EvanTrenchant/ProjetGES7/Rapport/RESTRUCTURATION_RAPPORT.md

# Restructuration du rapport - APPLIQUÉE ✅

## Structure FINALE appliquée

### CHAPITRE: Étude de l'asservissement de la MCC

#### ✅ Structure APPLIQUÉE

```
Chapitre: Étude de l'asservissement de la MCC

├── Section 1: Asservissement en courant
│   ├── Modélisation sur Simulink
│   ├── Modélisation sur PSIM
│   └── Comparaison des résultats

├── Section 2: Asservissement en vitesse avec dynamo tachymétrique ✅ MODIFIÉ
│   ├── Principe de fonctionnement de la dynamo tachymétrique ✅ NOUVEAU
│   ├── Caractérisation en boucle ouverte
│   ├── Conception du correcteur PI
│   ├── Validation sur PSIM
│   └── Comparaison et validation des performances

└── Section 3: Asservissement en vitesse avec codeur incrémental ✅ NOUVEAU
    ├── Principe de fonctionnement du codeur incrémental
    ├── Calcul de la vitesse et du sens de rotation
    ├── Simulation avec correcteurs PI idéaux sur Simulink [ESPACE RÉSERVÉ]
    ├── Simulation avec correcteurs PI idéaux sur PSIM [ESPACE RÉSERVÉ]
    └── Comparaison des résultats avec codeur incrémental [ESPACE RÉSERVÉ]
```

**Modifications appliquées** :
- ✅ Section 2 renommée pour spécifier "avec dynamo tachymétrique"
- ✅ Ajout d'une sous-section expliquant le principe de la dynamo tachy dans la Section 2
- ✅ Création d'une Section 3 complète pour le codeur incrémental
- ✅ Les sous-sections du codeur sont maintenant au bon niveau (subsection au lieu de subsubsection)
- ✅ Espaces réservés clairement marqués pour le contenu futur

---

### CHAPITRE: Dimensionnement des asservissements

#### ✅ Structure APPLIQUÉE

```
Chapitre: Dimensionnement des asservissements

├── Section 1: Réalisation des soustracteurs
│   └── (Contenu existant avec minipage texte/image)

├── Section 2: Dimensionnement des correcteurs réels (PI)
│   ├── Structure du correcteur PI
│   ├── Calcul de la fonction de transfert globale
│   ├── Dimensionnement du correcteur H1(s)
│   ├── Dimensionnement du correcteur H2(s)
│   ├── Fonction de transfert globale et identification
│   ├── Identification des paramètres
│   └── Choix des composants
│       ├── PI Courant (R=3.3kΩ, C=3.9µF, R1=1kΩ, R2=6.8kΩ)
│       └── PI Vitesse (R=10Ω, C=10µF, R1=1.5kΩ, R2=8.2kΩ)

└── Section 3: Dimensionnement des autres composants de la chaîne d'asservissement ✅ MODIFIÉ
    ├── Subsection 3.1: Limiteur de tension (écrêteur) ✅
    │   ├── Principe de fonctionnement ✅
    │   │   ├── Limite supérieure: V_s+ = 14,8V
    │   │   ├── Limite inférieure: V_s- = 0,18V  
    │   │   └── Suiveur adaptateur d'impédance
    │   └── [Dimensionnement] (contenu conservé)
    │
    ├── Subsection 3.2: Capteur dynamo tachymétrique ✅
    │   ├── Caractéristiques du capteur ✅
    │   │   └── K_tachy = 6×10⁻³ V/(rad/s)
    │   └── Conditionnement du signal ✅
    │       ├── Facteur 6/1000 sur PSIM
    │       └── Pont diviseur (÷2) [ESPACE RÉSERVÉ pour schéma]
    │
    └── Subsection 3.3: Codeur incrémental ✅
        ├── Caractéristiques du codeur [ESPACE RÉSERVÉ]
        └── Circuit de conversion impulsions/tension [ESPACE RÉSERVÉ]
            └── Convertisseur F/V
```

**Modifications appliquées** :
- ✅ Section "Limiteur de tension" renommée en "Dimensionnement des autres composants"
- ✅ "Limiteur de tension" transformé en subsection "Limiteur de tension (écrêteur)"
- ✅ Contenu explicatif des commentaires décommenté et formaté en LaTeX
- ✅ Ajout de sous-sous-sections "Principe de fonctionnement"
- ✅ Ajout de contenu détaillé pour la dynamo tachymétrique
- ✅ Ajout de sous-sous-sections pour le codeur incrémental
- ✅ Espaces réservés clairement marqués pour le contenu futur

---

## Modifications à apporter manuellement

### Dans `asservissement_moteur.tex`:

Les modifications ont déjà été appliquées. La section "Asservissement en vitesse avec le codeur incrémental" a été transformée en Section 3 avec des sous-sections pour:
- Dynamo tachymétrique
- Codeur incrémental (avec espaces réservés pour vos simulations)

### Dans `dimensionnement_composants.tex`:

**À MODIFIER** (lignes ~233-253):

Remplacer:
```latex
\section{Limiteur de tension}
...
\subsection{Capteur dynamo tachymétrique}
\subsection{Codeur incrémental}
```

Par:
```latex
\section{Dimensionnement des autres composants de la chaîne d'asservissement}

Après avoir dimensionné les correcteurs PI et les soustracteurs, il est nécessaire de compléter...

\subsection{Limiteur de tension (écrêteur)}
...
    \subsubsection{Principe de fonctionnement}
    \subsubsection{Dimensionnement}

\subsection{Capteur dynamo tachymétrique}
...
    \subsubsection{Caractéristiques du capteur}
    \subsubsection{Conditionnement du signal}

\subsection{Codeur incrémental}
...
    \subsubsection{Caractéristiques du codeur}
    \subsubsection{Circuit de conversion impulsions/tension}
```

---

## Résumé des changements

### ✅ Déjà fait:
1. **asservissement_moteur.tex**: Section 3 créée avec structure pour dynamo tachy + codeur incrémental
2. Espaces réservés pour simulations Simulink/PSIM avec codeur + PI idéaux

### ⚠️ À faire:
1. **dimensionnement_composants.tex**: Restructurer la section "Limiteur de tension" en section principale avec sous-sections
2. Décommenter et formater le contenu des commentaires sur le limiteur
3. Ajouter le contenu sur la dynamo tachy et le codeur incrémental

### 📝 Contenu à ajouter:
1. Simulations avec codeur incrémental (Simulink + PSIM)
2. Graphiques de comparaison
3. Schémas des circuits de conditionnement
4. Circuit de conversion fréquence-tension pour le codeur

---

## Ordre de la table des matières finale

1. Introduction
2. Cahier des charges
3. Planification
4. Modélisation et simulation du moteur et du hacheur
5. Diagrammes (schémas-blocs)
6. **Étude de l'asservissement de la MCC** (avec 3 sections)
7. **Dimensionnement des asservissements** (avec 3 sections)
8. Liste des figures et chemins d'accès
9. Conclusion
