EvanTrenchant/ProjetGES7/Rapport/contenu/diagrammes.tex

\section{Simplification du schéma bloc}

\noindent
\begin{minipage}[t]{0.48\textwidth}
\vspace{0pt}
A ce stade de l'analyse, nous disposons du schéma bloc complet de notre système, avant asservissement en vitesse. Comme illustré dans la Figure \ref{fig:schema_bloc_asservissement}, ce schéma est assez complexe en raison de la présence de plusieurs boucles de rétroaction imbriquées. Pour faciliter l'analyse et la conception des contrôleurs, il est nécessaire de simplifier ce schéma bloc en combinant les différents éléments.
\end{minipage}
\hfill
\begin{minipage}[t]{0.48\textwidth}
\vspace{0pt}
Cette simplification permet d'obtenir une représentation plus concise du système, facilitant ainsi l'analyse et la conception des contrôleurs.
\[
\begin{aligned}
\left\{
\begin{array}{l}
\varepsilon = e - \textcolor{blue}{B} \cdot \Omega - \textcolor{green!60!black}{C} \cdot \Omega \\
s = \textcolor{red}{A} \cdot \varepsilon = \textcolor{red}{A} \cdot \left( e - (\textcolor{blue}{B} + \textcolor{green!60!black}{C}) \cdot s \right)
\end{array}
\right.
\\[0.5em]
\Longrightarrow \quad
s = \frac{\textcolor{red}{A}\cdot e}{1+\textcolor{red}{A} \cdot \left( \textcolor{blue}{B} + \textcolor{green!60!black}{C}\right)} = H \cdot e
\end{aligned}
\]
\end{minipage}

\begin{figure}[H]
    \centering
    \begin{tikzpicture}[auto, node distance=2cm,>=latex', scale=0.65, transform shape]
        % Définition des styles
        \tikzstyle{block} = [draw, rectangle, minimum height=3em, minimum width=3em]
        \tikzstyle{sum} = [draw, circle, minimum size=6mm, node distance=1.5cm]
        \tikzstyle{input} = [coordinate]
        \tikzstyle{output} = [coordinate]
        \tikzstyle{gain} = [draw, regular polygon, regular polygon sides=3, shape border rotate=-90, minimum size=0.5em, inner sep=1pt]
        
        % Nœuds - Entrée et premier sommateur
        \node [input, name=input] (input) {};
        \node [gain, right of=input, node distance=1.5cm] (commande) {$6.4$};
        \node [sum, right of=commande, node distance=1.5cm] (sum2) {};
        
        \draw (sum2.north east) -- (sum2.south west);
        \draw (sum2.south east) -- (sum2.north west);
        \node [above left, inner sep=6pt] at (sum2.center) {\tiny $+$};
        \node [below right, inner sep=6pt] at (sum2.center) {\tiny $-$};
        
        % Bloc correcteur de vitesse
        \node [block, right of=sum2, node distance=2cm] (corrV) {$\dfrac{1}{R+L\cdot s}$};
        
        % Point intermédiaire entre corrV et kphi (nœud noir)
        \node [circle, fill=black, inner sep=2pt, right of=corrV, node distance=1.4cm] (point_iM) {};
        
        % Gain Kphi
        \node [gain, right of=corrV, node distance=2.4cm] (kphi) {$K_\phi$};

        % Sortie delta i_M au-dessus de corrV
        \node [output, above of=kphi, node distance=1.5cm] (delta_iM) {};
        \node [above] at (delta_iM) {$\delta i_M$};
        
        % Troisième sommateur
        \node [sum, right of=kphi, node distance=1.8cm] (sum3) {};
        
        % Ajout des signes + et - dans le troisième sommateur
        \draw (sum3.north east) -- (sum3.south west);
        \draw (sum3.south east) -- (sum3.north west);
        \node [above left, inner sep=6pt] at (sum3.center) {\tiny $+$};
        \node [below right, inner sep=6pt] at (sum3.center) {\tiny $-$};
        
        % Bloc intégrateur
        \node [block, right of=sum3, node distance=2.5cm] (integ) {$\dfrac{1}{J\cdot s}$};
        
        % Point Omega pour dérivation
        \node [coordinate, right of=integ, node distance=2.5cm] (omega) {};
        % Point s (nœud noir) après l'intégrateur
        \node [circle, fill=black, inner sep=2pt, right of=omega, node distance=0cm] (s_point) {};
        % Label s en bas à droite du point noir
        \node [below right, inner sep=3pt] at (s_point) {\small $s$};
        % Sortie
        \node [output, right of=omega, node distance=0.5cm] (output) {};
        
        % Boucle de retour 1 : Bloc retour 2f - positionné sous sum3
        \node [gain, shape border rotate=90, below of=integ, node distance=2cm] (gain2f) {$2f$};
        
        % Boucle de retour 2 : Bloc retour complexe Kphi² - positionné sous integ
        \node [block, below of=gain2f, node distance=2cm, minimum width=6em] (retourA) {$\dfrac{K_\phi^2}{L\cdot s+(R+R_{ch})}$};
        
        % Sommateur 4 : entre les retours 2f et Kphi² avant sum3
        \node [sum, below of=sum3, node distance=2cm] (sum4) {};
        
        % Ajout des signes + dans le sommateur 4
        \draw (sum4.north east) -- (sum4.south west);
        \draw (sum4.south east) -- (sum4.north west);
        \node [above right, inner sep=6pt] at (sum4.center) {\tiny $+$};
        \node [below right, inner sep=6pt] at (sum4.center) {\tiny $+$};
        
        % Boucle de retour 3 : Gain Kphi - positionné pour aller vers sum2
        \node [gain, shape border rotate=90, below of=sum3, node distance=5.5cm] (kphiret) {$K_\phi$};
        
        % Connexions principales
        \draw [->] (input) -- node[above, pos=- 0.2] {$\delta u_{commande}$} (commande);
        \draw [->] (commande) -- (sum2);
        \draw [->] (sum2) -- (corrV);
        \draw [-] (corrV) -- (point_iM);
        \draw [->] (point_iM) -- (kphi);
        
        % Sortie delta i_M depuis le point intermédiaire
        \draw [->] (point_iM) |- (delta_iM);
        
        \draw [->] (kphi) -- node[above] {$e$} (sum3);
        \draw [->] (sum3) -- node[above] {$\varepsilon$} (integ);
        \draw [-] (integ) -- (omega);
        \draw [->] (omega) -- node[above] {$\delta \Omega$} (output);
        
        % Boucle de retour 1 : 2f part de Omega et va dans sum4
        \draw [->] (omega) |- (gain2f);
        \draw [->] (gain2f) -- (sum4);
        
        % Boucle de retour 2 : Kphi² part de Omega et va dans sum4
        \draw [->] (omega) |- (retourA);
        \draw [->] (retourA) -| (sum4);
        
        % Sortie de sum4 vers sum3
        \draw [->] (sum4) -- (sum3);
        
        % Boucle de retour 3 : Kphi part de Omega et revient à sum2
        \draw [->] (omega) |- (kphiret);
        \draw [->] (kphiret) -| (sum2);
        
        % Rectangle coloré autour du bloc intégrateur
        \draw [red, thick, rounded corners] ([xshift=-0.2cm, yshift=0.2cm]integ.north west) rectangle ([xshift=0.2cm, yshift=-0.2cm]integ.south east);
        \node [red, font=\Large\bfseries, right of=integ, node distance=1.2cm, yshift=0.6cm] {A};
        
        % Rectangle coloré autour du bloc 2f
        \draw [blue, thick, rounded corners] ([xshift=-0.6cm, yshift=0.5cm]gain2f.north west) rectangle ([xshift=0.2cm, yshift=-0.4cm]gain2f.south east);
        \node [blue, font=\Large\bfseries, right of=gain2f, node distance=0.9cm, yshift=-0.5cm] {B};
        
        % Rectangle coloré autour du bloc Kphi²
        \draw [green!60!black, thick, rounded corners] ([xshift=-0.2cm, yshift=0.2cm]retourA.north west) rectangle ([xshift=0.2cm, yshift=-0.2cm]retourA.south east);
        \node [green!60!black, font=\Large\bfseries, left of=retourA, node distance=2.2cm, xshift=-0.05cm, yshift=0.5cm] {C};
        
    \end{tikzpicture}
    \caption{Schéma bloc de l'asservissement en courant avec boucle de courant imbriquée}
    \label{fig:schema_bloc_asservissement}
\end{figure}

Le diagramme bloc simplifié de l'asservissement en vitesse est présenté dans la Figure \ref{fig:schema_bloc_simplifie}.

\begin{figure}[H]
    \centering
    \begin{tikzpicture}[auto, node distance=2cm,>=latex', scale=0.65, transform shape]
        % Définition des styles
        \tikzstyle{block} = [draw, rectangle, minimum height=3em, minimum width=3em]
        \tikzstyle{sum} = [draw, circle, minimum size=6mm, node distance=1.5cm]
        \tikzstyle{input} = [coordinate]
        \tikzstyle{output} = [coordinate]
        \tikzstyle{gain} = [draw, regular polygon, regular polygon sides=3, shape border rotate=-90, minimum size=0.5em, inner sep=1pt]
        
        % Nœuds - Entrée et premier sommateur
        \node [input, name=input] (input) {};
        \node [gain, right of=input, node distance=1.5cm] (commande) {$6.4$};
        \node [sum, right of=commande, node distance=1.5cm] (sum2) {};

        \draw (sum2.north east) -- (sum2.south west);
        \draw (sum2.south east) -- (sum2.north west);
        \node [above left, inner sep=6pt] at (sum2.center) {\tiny $+$};
        \node [below right, inner sep=6pt] at (sum2.center) {\tiny $-$};

        % Bloc correcteur de vitesse
        \node [block, right of=sum2, node distance=2cm] (corrV) {$\dfrac{1}{R+L\cdot s}$};
        
        % Point intermédiaire entre corrV et kphi (nœud noir)
        \node [circle, fill=black, inner sep=2pt, right of=corrV, node distance=1.6cm] (point_iM) {};
        
        % Bloc Kphi * H
        \node [block, right of=point_iM, node distance=1.5cm] (kphih) {$K_\phi\cdot H$};

        % Sortie delta i_M au-dessus de corrV
        \node [output, above of=kphih, node distance=1.5cm] (delta_iM) {};
        \node [above] at (delta_iM) {$\delta i_M$};
        
        % Point Omega pour dérivation
        \node [coordinate, right of=kphih, node distance=1.5cm] (omega) {};
        % Point s (nœud noir) après l'intégrateur
        \node [circle, fill=black, inner sep=2pt, right of=omega, node distance=0cm] (s_point) {};
        % Label s en bas à droite du point noir
        \node [below right, inner sep=3pt] at (s_point) {\small $s$};
        % Sortie
        \node [output, right of=omega, node distance=0.5cm] (output) {};
        
        % Boucle de retour 3 : Gain Kphi - positionné pour aller vers sum2
        \node [gain, shape border rotate=90, below of=point_iM, node distance=1.5cm] (kphiret) {$K_\phi$};
        
        % Connexions principales
        \draw [->] (input) -- node[above, pos=- 0.2] {$\delta u_{commande}$} (commande);
        \draw [->] (commande) -- (sum2);
        \draw [->] (sum2) -- (corrV);
        \draw [-] (corrV) -- (point_iM);
        \draw [->] (point_iM) -- (kphih);

        % Sortie delta i_M depuis le point intermédiaire
        \draw [->] (point_iM) |- (delta_iM);

        \draw [-] (kphih) -- (omega);
        \draw [->] (omega) -- node[above] {$\delta \Omega$} (output);
        
        % Boucle de retour 3 : Kphi part de Omega et revient à sum2
        \draw [->] (omega) |- (kphiret);
        \draw [->] (kphiret) -| (sum2);
    \end{tikzpicture}
    \caption{Schéma bloc de l'asservissement en courant simplifié}
    \label{fig:schema_bloc_simplifie}
\end{figure}

On peut alors écrire la fonction de transfert en boucle ouverte du système simplifié :
\[
\delta_{i_{M}} (s) = \dfrac{\dfrac{1}{R+L\cdot s}}{1+\dfrac{\left(K_\phi\right)^2\cdot H}{R+L\cdot s}} \cdot 6{,}4 \cdot \delta u_{commande} (s) = FTBO (s) \cdot 6{,}4 \cdot \delta u_{commande} (s)
\]

Pour s'assurer que notre fonction de transfert est correcte, il faudrait la valider par des simulations numériques en comparant les résultats obtenus. Il serait alors possible de poursuivre l'analyse en utilisant cette fonction de transfert simplifiée pour concevoir et optimiser le contrôleur de l'asservissement en vitesse du moteur.
