EvanTrenchant/ProjetGES7/Rapport/contenu/liste_figures_chemins.tex

\chapter*{Liste des figures et chemins d'accès}
\addcontentsline{toc}{chapter}{Liste des figures et chemins d'accès}

Cette section recense l'ensemble des figures présentes dans ce rapport ainsi que le chemin d'accès aux fichiers de simulation correspondants.

\vspace{0.5cm}

% Cette liste se génère automatiquement à partir des figures ayant un chemin d'accès défini
% via la commande \figpath{label}{chemin} dans le préambule ou les chapitres
{\tiny
\begin{itemize}[leftmargin=0pt, labelwidth=0pt, labelsep=0pt, itemindent=0pt, itemsep=0.3cm]
    \printfigurelist
\end{itemize}
}
