EvanTrenchant/ProjetGES7/Partie Essais et Rectifications.docx

# Essais et Rectifications

Une fois que notre PCB est assemblé et que les connections avec les connectiques sont réalisées, nous pouvons passer au test du projet. Ce qui nous permettra également de résoudre les problèmes de conceptions si nous en rencontrons. Les tests se sont déroulés en deux parties principales qui sont l’asservissement à l’aide de la dynamo tachymétrique puis l’asservissement à l’aide du codeur incrémental.

## 1- Protocole d’essais

Pour réaliser ces tests, nous avons respecté le même protocole pour les deux parties.

Premièrement nous avons uniquement testé le PCB sur plaquette. Cela consiste à injecter des signaux continus aux différentes entrée de la chaine d’asservissement ou de traitement du signal codeur incrémental et d’observer les sorties de chaque étage. Une fois ces sorties mesurées, nous pouvons les comparer aux valeurs trouvées en simulation pour les mêmes tests et valider ou non le fonctionnement de notre carte. Pour ces tests avons veillé à court-circuiter les capacités de correcteur proportionnel intégrale pour qu’elle ne gêne pas les tests réalisés avec des signaux continus.

Une fois la validation du fonctionnement du PCB effectuée, nous pouvons passer aux tests sur la maquette réelle. Pour ce faire nous alimentons notre boitier en -15V/+15V et le hacheur qui alimentera la machine à courant continue en 48V. Nous utilisons un GBF pour appliquer une consigne, et avons choisis un signal carrée variant entre -2V et +2V de fréquence 400mHz pour observer un changement de sens de rotation de l’axe de la MCC. En parallèle nous utilisons un oscilloscope pour observer toutes les mesures qui nous intéresse donc la consigne envoyée à la carte, la vitesse de rotation du moteur donnée par la dynamo tachymétrique ou le codeur incrémental ainsi que le courant dans le moteur. Ces tests sur la maquette seront validés si la réponse de notre système est stable et si le courant dans le moteur est bien écrêté à une valeur maximale de 5A pour protéger la machine. Si ces critères sont remplis, nous pouvons faire les mesures de l’évolution dans le temps de la vitesse de rotation du moteur ainsi que le courant absorbé par celui-ci.

Finalement, la dernière partie des tests consistera à comparer les valeurs mesurées sur la maquette réelle aux valeur trouvées en simulations. Cela permettra de comparer les performances voulues en simulation aux performances que nous avons atteint en réalité. Nous portons une attention particulière au dépassement et au temps de réponse du système. Nous ferons une comparaison entre les valeurs réelles, les valeurs de simulation de Matlab ainsi qu’avec les valeurs données par PSIM.

## 2- Essais avec la dynamo tachymétrique

Pour ces premiers tests nous réalisons uniquement les tests pour asservir la machine à courant continue à l’aide du retour de vitesse fourni par la dynamo tachymétrique de la maquette.

### Problèmes rencontrés

Nous avons commencé par les tests sur plaquette de la carte et nous n’avons pas rencontrés de problèmes majeurs ce qui nous a permit de passer à la deuxième étape de test qui est tester notre carte sur la maquette. Nous avons donc réalisé ces tests sur maquette qui nous ont montré que notre système d’asservissement est fonctionnel car il répond de manière stable. En revanche nous avons observé deux problèmes qui sont :

- Le limiteur de courant était inefficace
- Le signal de courant n’était pas stable

Après avoir analyser notre montage et avoir refait des simulations nous nous somme rendu compte que pour le premier problème nous avions placer l’étage limiteur de courant au mauvais endroit dans la chaine d’asservissement. Ce limiteur avait été placé après l’étage qui compare la consigne de courant au retour de courant venant de la maquette alors que ce limiteur aurait dû être avant ce comparateur. Nous avons alors modifié notre PCB pour faire en sorte de replacer ce limiteur au bon endroit, comme montré sur la figure ci-dessous, et cela a fonctionné, nous avions bien un courant écrêté à 5A comme demandé pour protéger la machine.

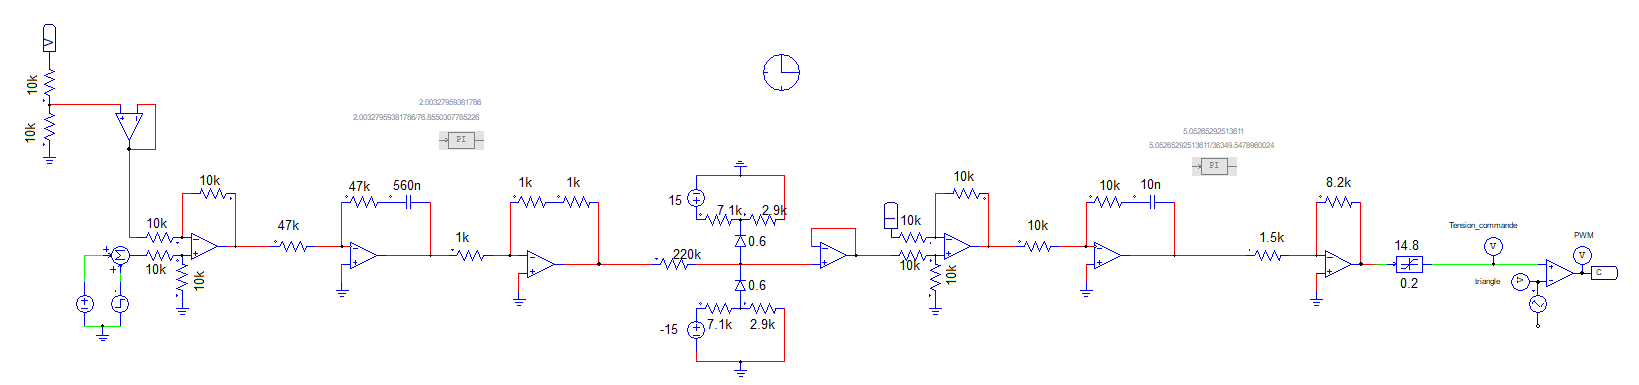
[picture p25: figure]

Figure 1 : Modification placement étage limiteur de courant

Pour ce qui est de la stabilité du signal de courant nous avons remarqué que nous avions soudé la mauvaise valeur de capacité dans l’étage du correcteur intégral de la boucle de courant. Nous avons donc remplacé cette capacité par la valeur prévue en lors du dimensionnement des composants et cela régler ce souci de stabilité.

### Performances obtenues

Une fois ces problèmes régler nous avons pu réaliser des tests complets sur la maquette. Grâce à l’oscilloscope nous avons relevé les courbes de vitesse et de courant réelles afin de pourvoir les comparer aux simulations. Nous avons réalisé les comparaisons en utilisant Matlab pour superposer les courbes données par Simulink, les valeurs renvoyées par PSIM et les valeurs réelles mesurées. Cela nous donne la comparaison suivant pour le courant :

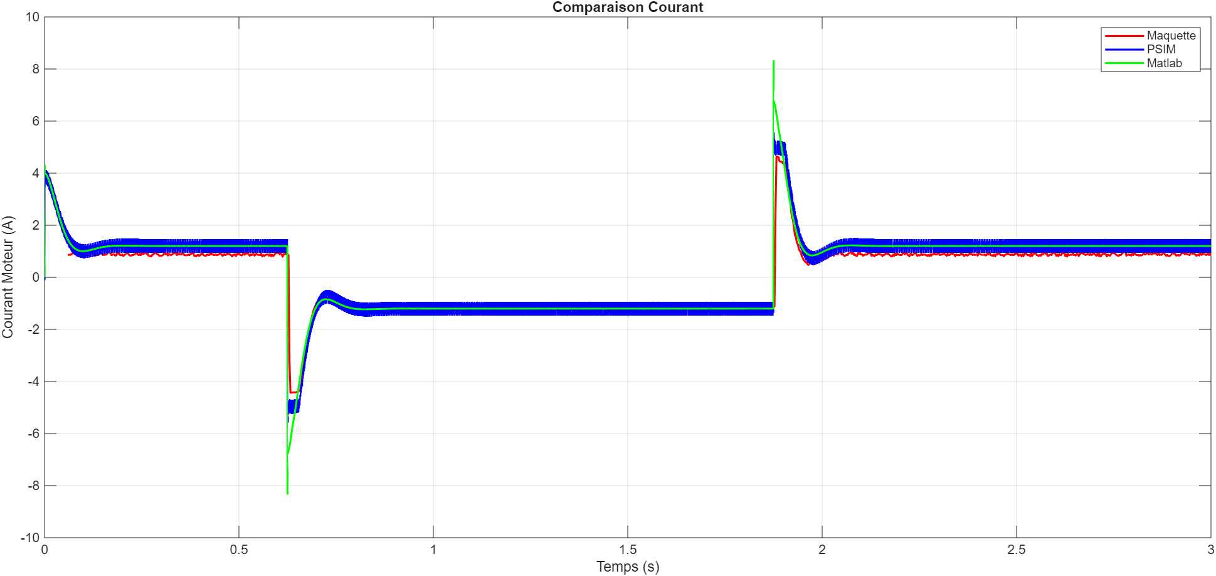
[picture p26: figure]

Pour la simulation faite avec Matlab nous avons volontairement laissé le pic de courant pour pouvoir observer facilement que notre projet écrête bien le courant à 5A, ce qui est également le cas pour la simulation PSIM avec laquelle nous avons dimensionné les composants. On observe que la courbe réelle du courant est très proche des courbes trouvées en simulation, ce qui permet de valider le fonctionnement de notre projet sur l’asservissement en courant. A noté que l’on peut observer une légère différence de valeur de courant en régime permanent entre les valeurs réelles et les valeurs simulées. Cela est dû au réglage de la charge que nous avons mis sur la maquette qui ne devait pas être exactement à une valeur de 10Ω alors que les simulations ont été réalisées pour une valeur exacte de 10Ω.

Figure 2 : Comparaison Courant Maquette Simu

Pour ce qui est de l’asservissement en vitesse nous obtenons cette comparaison :

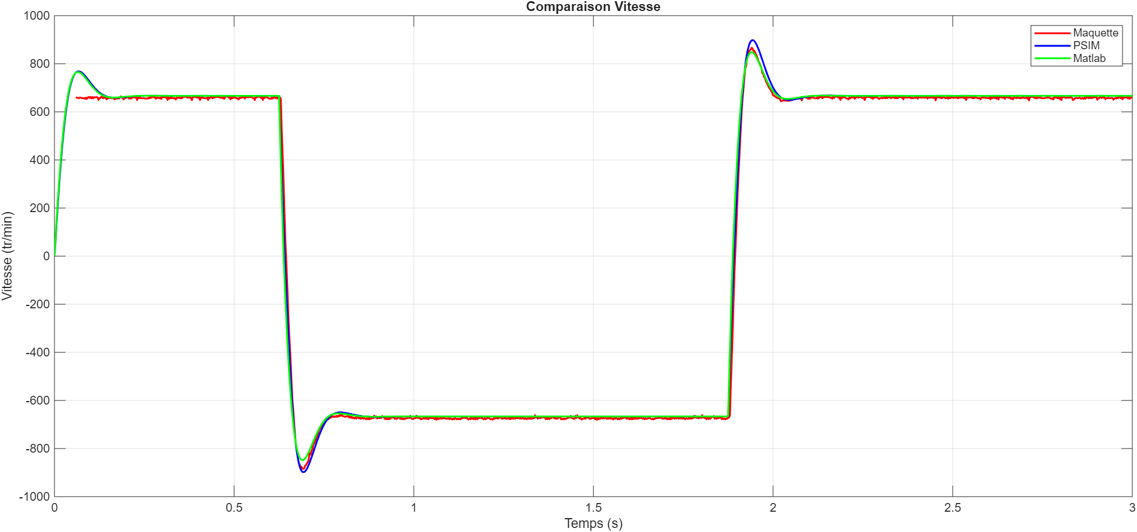
[picture p27: figure]

On remarque encore que les trois courbes ont très proches les unes des autres ce qui confirme que notre dimensionnement répond bien aux exigences que nous voulions. Nous avons également réalisé les mesures du temps de réponse et de dépassement à l’oscilloscope pour récupérer les performances de notre carte :

Figure 3 : Comparaison Vitesse Maquette Vitesse

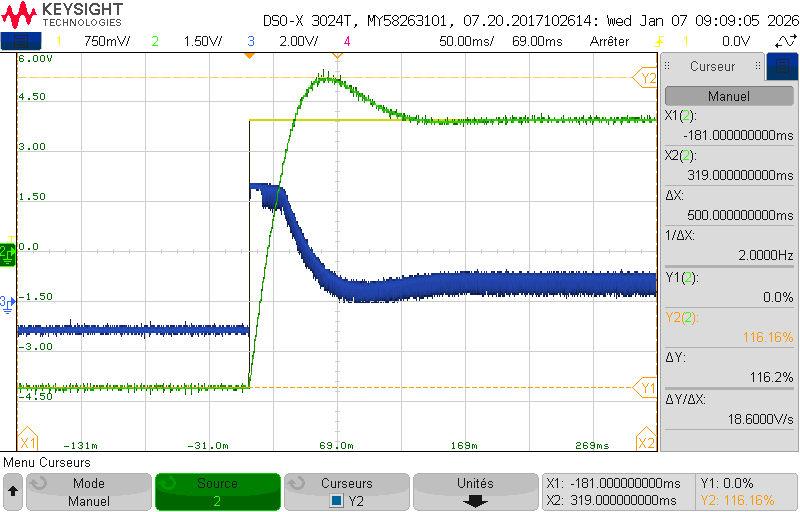
[picture p28: figure]
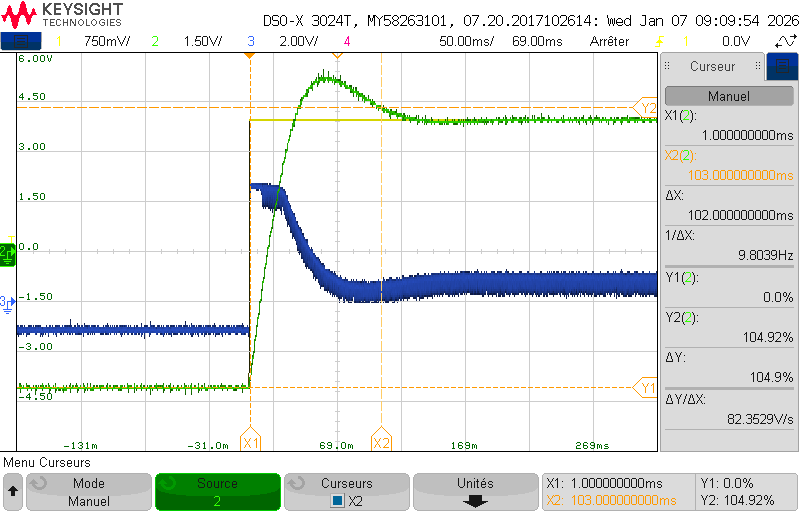
[picture p29: figure]

Figure 5 : Mesure Dépassement

Figure 5 : Mesure Temps de Réponse

Nous avons obtenu les performances suivantes :

- Dépassement : 16,2%
- Temps de réponse : 102 ms
- Limitation du courant : 4,97 A

Ces performances remplissent le cahier des charges que nous avions.

## 3- Essais avec le codeur incrémental

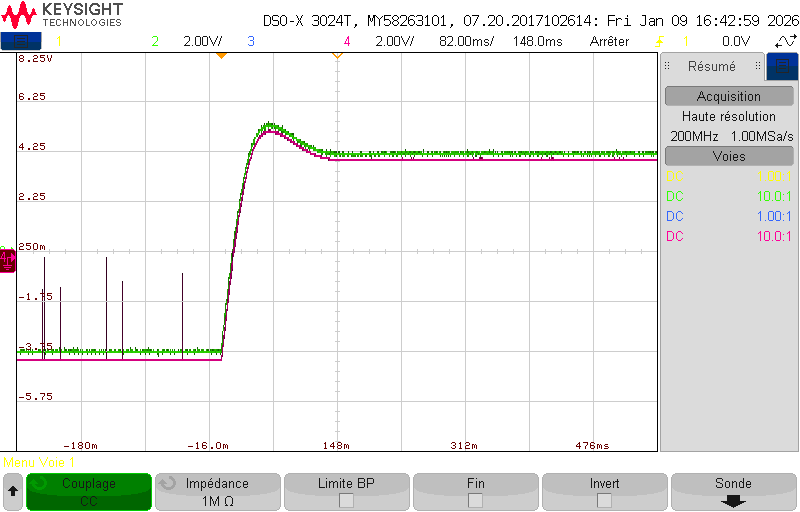
[picture p30: figure]

Pour cette partie des tests nous réalisons uniquement les tests pour asservir la machine à courant continue à l’aide du retour de vitesse fourni par le codeur incrémental de la maquette. Pour vérifier le bon fonctionnement de notre chaine de traitement du signal venant du codeur incrémental nous avons fait attention à vérifier sur le signal en sortie de cette chaine de traitement renvoie la même valeur de vitesse que la dynamo tachymétrique. Pour ce faire nous avons mis en place l’asservissement avec la dynamo tachymétrique et avons branché le codeur incrémental à notre chaine de traitement puis nous avons observé les retours de vitesses venant des deux capteurs. Cela nous a permis de régler le gain de la chaine de traitement du codeur incrémental pour obtenir le même retour de vitesse. Ce test est représenté ci-dessous :

Figure 6 : Test retour de vitesse Codeur Incrémental

### Problèmes rencontrés

Aucun problème n’a été rencontré lors des tests de la chaine de traitement du codeur incrémental sur plaquette ni sur la maquette.

### Performances obtenues

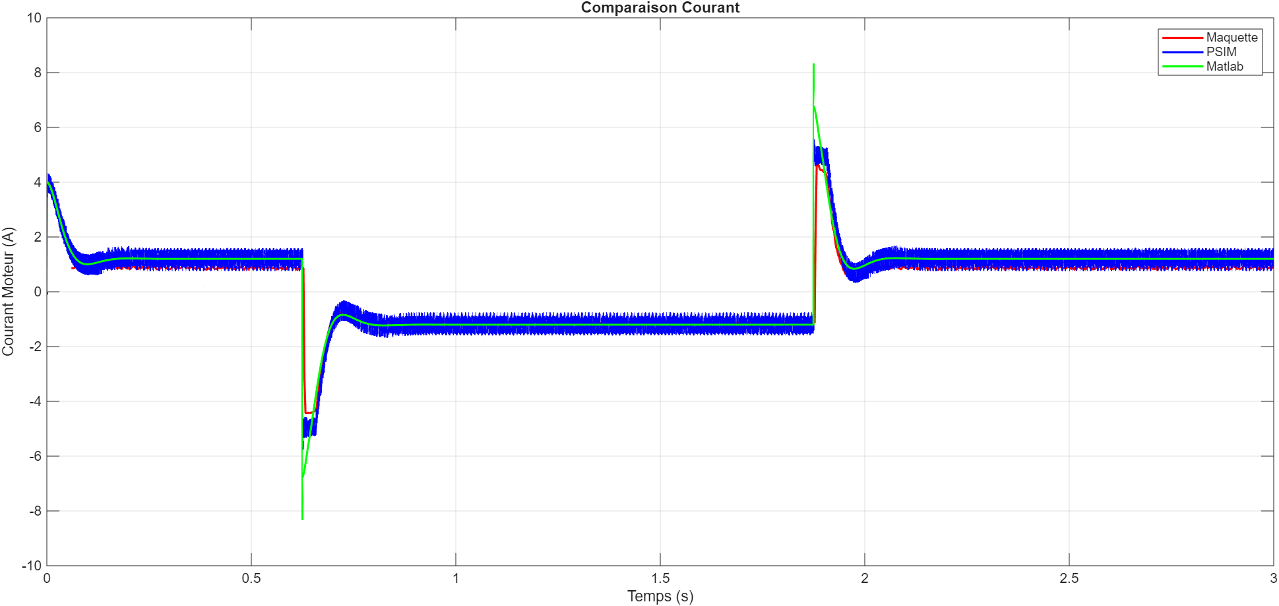
[picture p31: figure]

N’ayant pas rencontré de problème lors des tests nous avons pu réaliser les mesures de performance rapidement. Ces mesures nous donnent les comparaisons suivantes pour les courbes de vitesse et de courant. Nous obtenons à nouveau des courbes très similaires ce qui nous a permis de valider le fonctionnement de chaine d’asservissement en utilisant le codeur incrémental.

Figure 7 : Comparaison Courant Maquette Simu

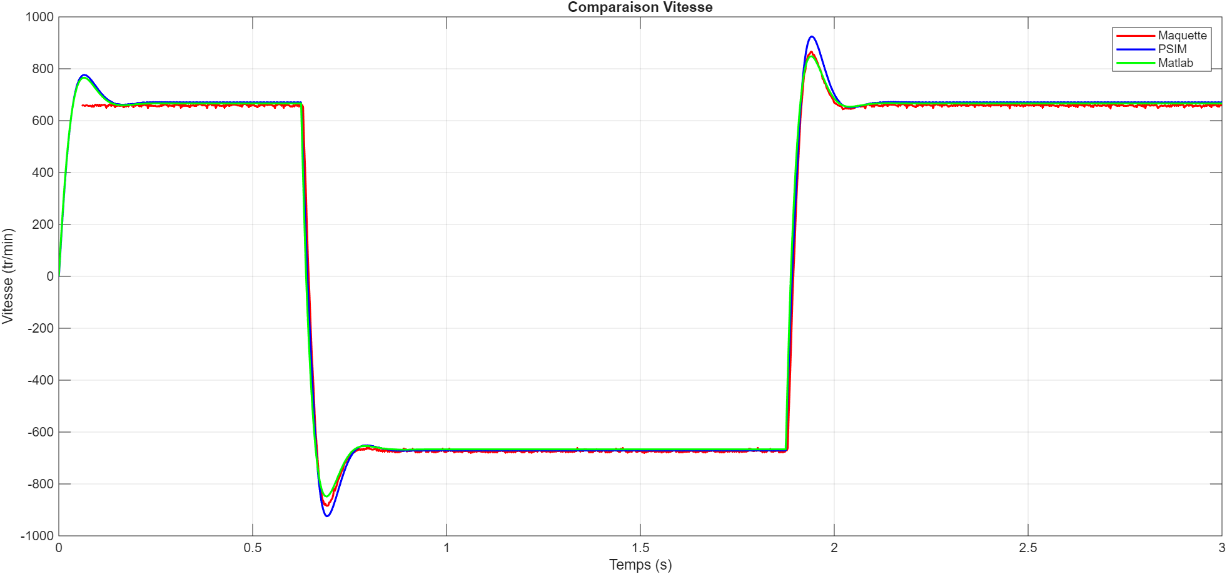
[picture p32: figure]

Figure 8 : Comparaison Vitesse Maquette Simu

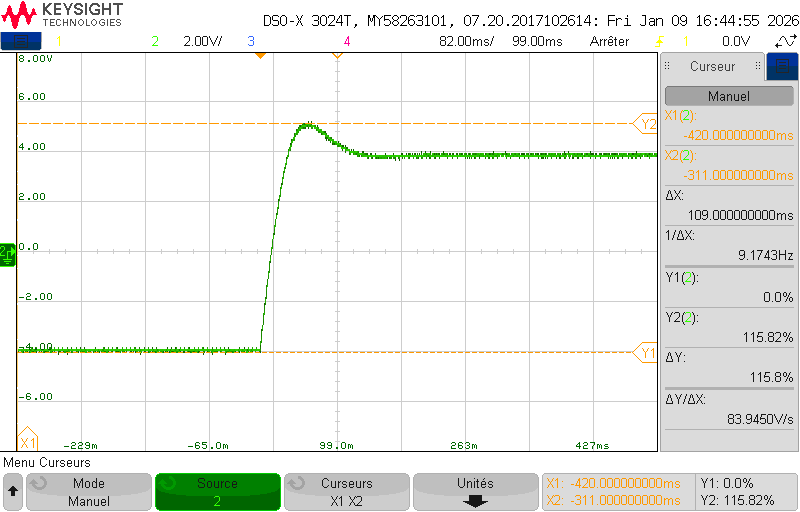
[picture p33: figure]
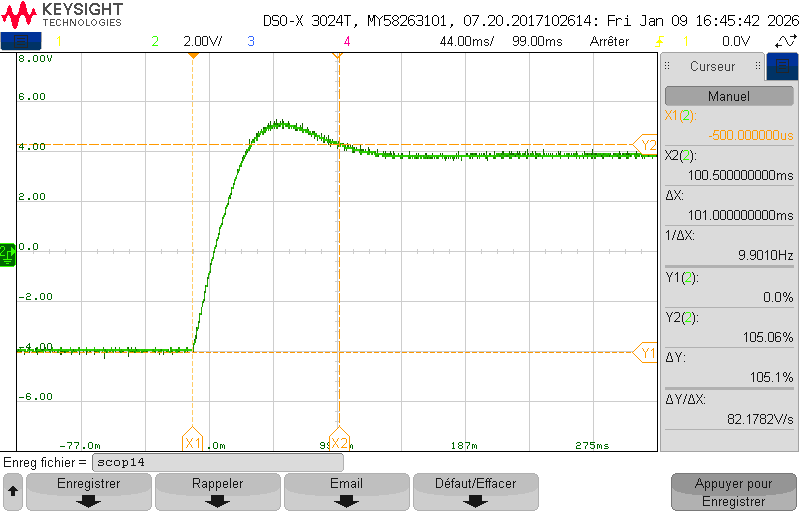
[picture p34: figure]

Nous avons également réalisé les mesures du temps de réponse et de dépassement à l’oscilloscope pour récupérer les performances de notre carte :

Figure 9 : Mesure Dépassement

Figure 10 : Mesure Temps de Réponse

Nous avons obtenu les performances suivantes :

- Dépassement : 15,8%
- Temps de réponse : 101 ms
- Limitation du courant : 4,97 A

Ces performances remplissent le cahier des charges que nous avions.
