EvanTrenchant/ProjetGES7/Projet_GES7_Rapport_Intermediaire_GE4_G2_TROULLIER_TRENCHANT_VIRQUIN_2025.pdf

# Projet GE S7

## Asservissement d’une machine à courant continu

## TRENCHANT Evan TROULLIER Laël VIRQUIN Rudy GE4, groupe 2

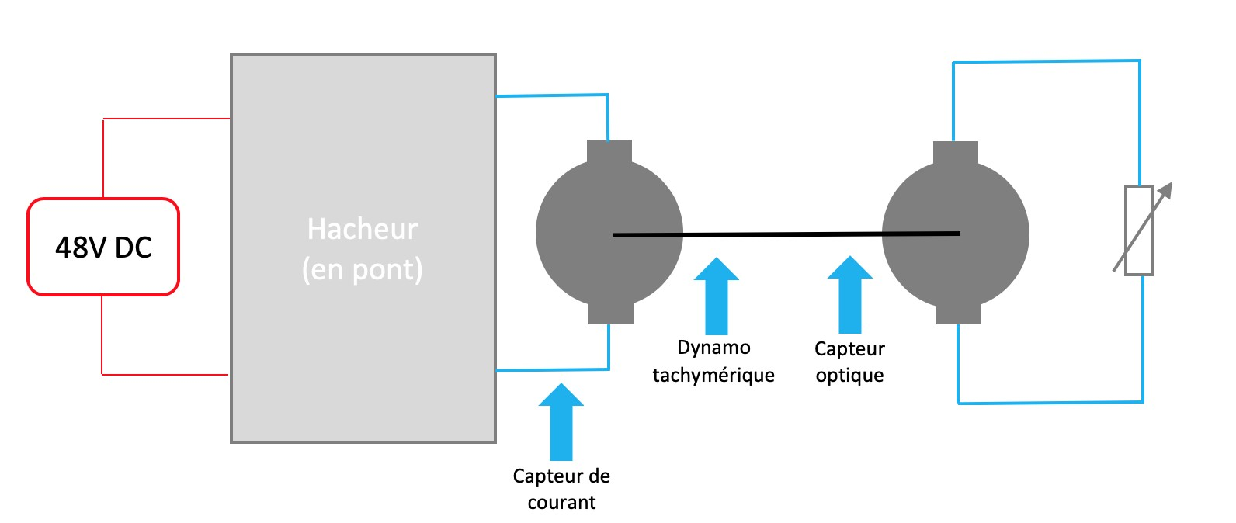
[picture p35: figure]

Professeur : Damien Flieller

9 novembre 2025

TRENCHANT Evan, TROULLIER Laël, VIRQUIN Rudy | 9/11/2025

# Introduction

Dans le domaine de l’électronique de puissance et de l’automatique, la commande des machines électriques constitue un enjeu majeur pour de nombreuses applications industrielles. Parmi ces machines, la machine à courant continu (MCC) occupe une place particulière de par sa simplicité de commande et sa capacité à fournir des couples élevés à basse vitesse.
Ce projet, réalisé dans le cadre du semestre 7 de la formation en Génie Électrique à l’INSA Strasbourg, porte sur l’étude et la réalisation de l’asservissement d’une machine à courant continu avec charge. L’objectif principal est de développer un système de contrôle permettant d’asservir précisément la vitesse et le courant de la machine tout en respectant les contraintes de performance imposées.

Contexte et problématique

L’asservissement des machines électriques nécessite une approche méthodique combinant la modélisation théorique, la simulation numérique et la validation expérimentale. Dans le cas particulier de la machine à courant continu, plusieurs défis doivent être relevés :

- La modélisation précise du comportement dynamique de la machine et de sa charge
- La conception de correcteurs adaptés pour les boucles de courant et de vitesse
- La limitation des dépassements lors des régimes transitoires
- L’optimisation des performances en régime permanent et dynamique

Objectifs du projet

Ce projet vise à concevoir et valider un système d’asservissement complet pour une machine à courant continu. Les objectifs spécifiques sont les suivants :

1. Modélisation et simulation : Développer un modèle mathématique précis de la machine à courant continu et de sa charge, puis l’implémenter dans les environnements MATLAB/Simulink et PSIM
2. Asservissement en courant : Concevoir et régler une boucle de régulation de courant permettant de contrôler précisément le couple de la machine
3. Asservissement en vitesse : Implémenter une boucle de régulation de vitesse en cascade avec la boucle de courant, utilisant soit un capteur tachymétrique soit un codeur incrémental
4. Respect des spécifications : Garantir que les dépassements en vitesse et en courant restent dans la plage de 10 à 20% lors des transitoires
5. Validation comparative : Comparer les résultats obtenus entre les simulations MAT-LAB/Simulink et PSIM pour valider la cohérence des modèles

Approche méthodologique

La démarche adoptée suit une approche progressive et structurée :
- Phase 1 : Étude et modélisation de la machine seule
- Phase 2 : Intégration de la charge mécanique et validation du modèle complet
- Phase 3 : Conception et réglage de la boucle de courant

- Phase 4 : Conception et réglage de la boucle de vitesse
- Phase 5 : Optimisation globale et validation finale du système d’asservissement

Chaque phase fait l’objet d’une validation croisée entre les outils MATLAB/Simulink et PSIM, permettant de garantir la fiabilité des résultats et d’identifier d’éventuelles divergences de modélisation.

Structure du rapport

Ce rapport présente de manière détaillée l’ensemble des travaux réalisés. Il s’articule autour des axes suivants :
- La modélisation théorique et numérique de la machine à courant continu
- L’analyse comparative des outils de simulation
- La conception des correcteurs et leur réglage
- La validation expérimentale des performances obtenues
- L’analyse critique des résultats et les perspectives d’amélioration
Les résultats obtenus démontrent la faisabilité d’un asservissement efficace de la machine à courant continu tout en respectant les spécifications imposées, ouvrant ainsi la voie à des applications industrielles concrètes.

# Table des matières

Introduction | 2
1 Cahier des charges | 5
2 Planification du projet | 6
3 Étude de la MCC et de son hacheur | 7
4 Étude de l’asservissement de la MCC | 18
5 Dimensionnement des asservissements | 27
Conclusion | 35
Liste des figures et chemins d’accès | 36

# 1 - Cahier des charges

### 1. Notations des variables pour le projet

Le tableau suivant récapitule l’ensemble des notations utilisées dans ce projet, ainsi que les valeurs et unités correspondantes pour notre moteur à courant continu.

Notations | Nom | Valeurs | Unités
| | Paramètres nominaux
M0 | couple en rotation lente | 0,54 | N.m
I0 | courant permanent rotation lente | 4,5 | A
U | tension d’alimentation de définition | 49 | V
N | vitesse de définition | 3 000 | tr/min
Paramètres maximaux
Umax | tension maximale | 65 | V
Nmax | vitesse maximale | 4 800 | tr/min
Imax | courant impulsionnel | 13 | A
Constantes électromécaniques
Ke | constante de fem (à 25°C) | 13,3 | V/(1000 tr/min)
KΦ | constante de couple électromagné-tique | 0,127 | N.m/A

Paramètres de frottement
Tf | couple de frottement sec | 2,4 | N.cm
Kd | coefficient de viscosité | 0,53 | N.cm/(1000 tr/min)
Paramètres électriques
R | résistance du bobinage (à 25°C) | 1,52 | Ω
L | inductance du bobinage | 2,2 | mH
Rch | résistance de charge | 10 | Ω
Paramètres mécaniques
J | inertie du rotor | 8,3 · 10⁻⁵ | kg.m²
M | masse du moteur | 1,34 | kg
Tth | constante de temps thermique | 7 | min
Variables dynamiques
Ω | vitesse de rotation | rad/s
Cm | couple électromagnétique | N.m
Cr | couple résistant total | N.m
i | courant d’induit | A
u | tension d’alimentation | V
e | force contre-électromotrice | V

### 2. Spécifications du système

Le cahier des charges du projet est défini comme suit :

Asservissement en courant

- Temps de réponse maximal de 10 fois la periode de la MLI soit 0,45 ms
- Depassement maximal de 20%

Asservissement en vitesse

- Temps de réponse à 5% divisé par 3 par rapport à la boucle ouverte
- Depassement maximal de 20%

# 2 - Planification du projet

La réalisation de ce projet d’asservissement d’une machine à courant continu nécessite une planification rigoureuse pour garantir l’atteinte des objectifs dans les délais impartis. Cette section présente l’organisation temporelle du projet et le diagramme de Gantt détaillant les différentes phases de développement.

Diagramme de Gantt

Le diagramme de Gantt ci-dessous illustre la planification détaillée du projet sur 9 semaines, avec les dépendances entre les tâches et les jalons importants.

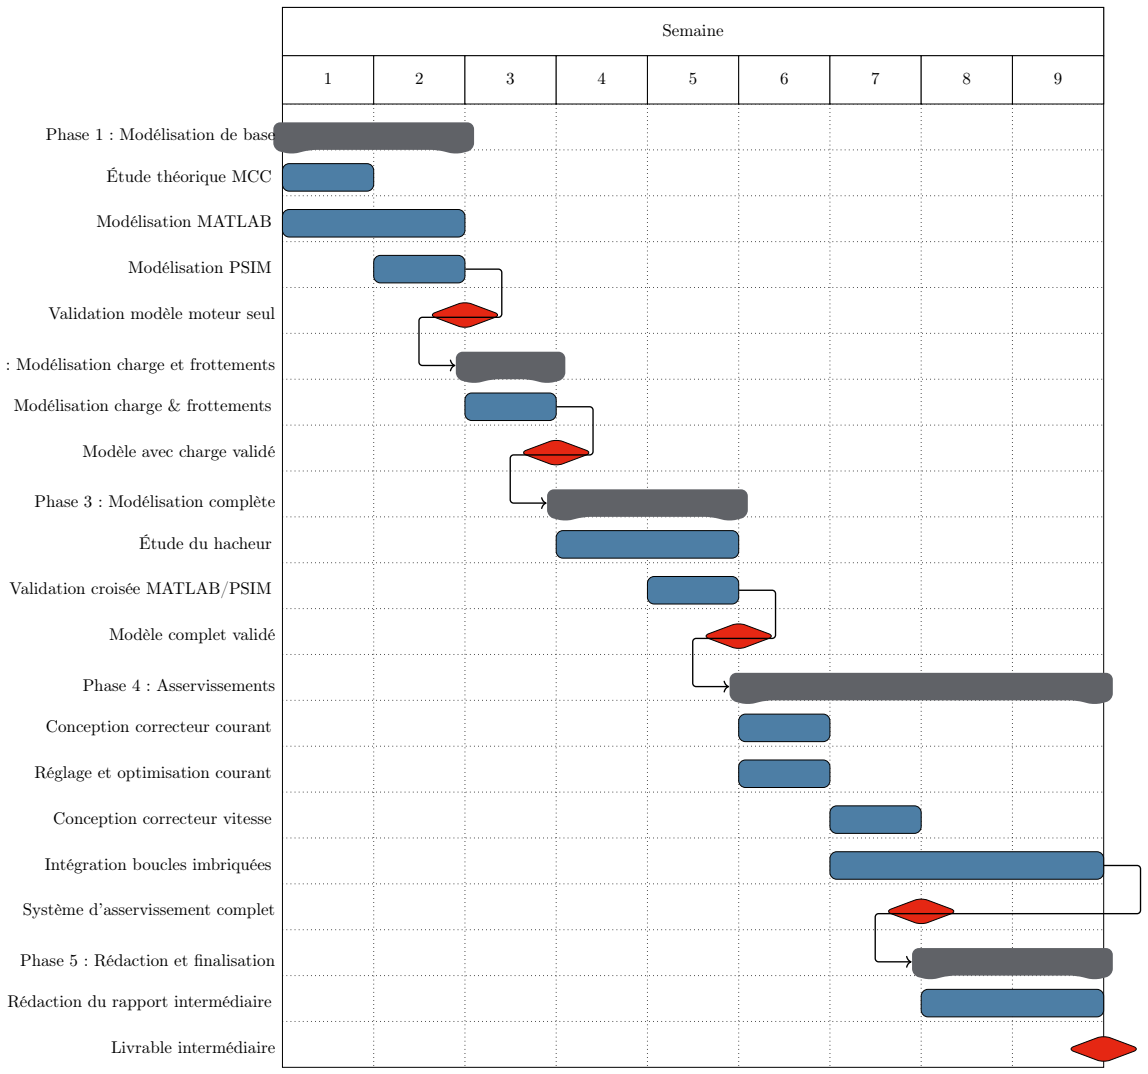
[picture p36: figure]
Semaine; Phase 1 : Modélisation de base; Étude théorique MCC; Modélisation MATLAB; Modélisation PSIM; Validation modèle moteur seul; Modélisation charge & frottements; Modèle avec charge validé; Phase 3 : Modélisation complète; Étude du hacheur; Validation croisée MATLAB/PSIM; Modèle complet validé; Phase 4 : Asservissements; Conception correcteur courant; Réglage et optimisation courant; Conception correcteur vitesse; Intégration boucles imbriquées; Système d’asservissement complet; Phase 5 : Rédaction et finalisation; Rédaction du rapport intermédiaire; Livrable intermédiaire

Phase 2 : Modélisation charge et frottements

Figure 2.1 – Diagramme de Gantt — récapitulatif jusqu’à 9 semaines

# 3 - Étude de la MCC et de son hacheur

### 1. Modélisation de la MCC à vide

### 1.1. Équations de la MCC

La machine à courant continu (MCC) est un dispositif électromécanique capable de convertir l’énergie électrique en énergie mécanique, et inversement. Cette conversion bidirectionnelle s’effectue grâce au passage d’un courant continu dans son induit, générant ainsi un couple moteur qui entraîne l’arbre en rotation. En mode générateur, le principe est inversé : la rotation de l’arbre produit une force électromotrice aux bornes de la machine. La MCC constitue ainsi un élément clé dans de nombreux systèmes d’entraînement industriels et de conversion d’énergie.

Formules d’une MCC sans pertes et sans charge

Les équations régissant le comportement d’une machine à courant continu sans pertes et sans charge sont les suivantes :

Équations temporelles de la MCC

u(t) = R · i(t) + L

di(t)
dt + e(t)

Cm(t) = Kc · i(t)

e(t) = Ke · ω(t)

J

dω
dt = Cm(t)

On note ici : Kc = Ke = KΦ

Transformée de Laplace

Les équations précédentes peuvent être exprimées dans le domaine de Laplace, ce qui facilite l’analyse et la modélisation du système :

Équations dans le domaine de Laplace

I(s) = U(s) − KΦΩ
R + Ls

Cm(s) = KΦ · I(s)

E(s) = KΦ · Ω(s)

Ω(s) = KΦ · I(s)
Js

Conversion vitesse-tension

Le moteur possède une force contre-électromotrice E proportionnelle à sa vitesse de rotation. Les données constructeur indiquent : E = 13,3 V pour 1000 tr/min.
En notant N la vitesse en tr/min et Ω la vitesse en rad/s, on obtient les relations suivantes :

E =

13, 3
1 000
- N

Ω = πN
30

⇒ E =

13, 3
1 000

·

30
π | | {z | }

0,127

·Ω

La constante de fcem est donc : KΦ = 0,127 V/(rad/s).

Une fois le modèle mathématique de la MCC défini à partir des équations présentées ci-dessus, nous pouvons procéder à sa simulation numérique. Cette simulation sera réalisée successivement sur deux environnements logiciels complémentaires : Simulink, qui permet une approche par schéma-blocs, et PSIM, orienté vers la simulation de circuits de puissance. La confrontation des résultats obtenus avec les deux outils permettra de valider notre modélisation théorique.

### 1.2. Simulation avec Simulink

Dans l’environnement Simulink, notre démarche consiste à traduire le système d’équations différentielles sous forme d’un schéma-blocs interconnectés, où chaque bloc représente une opération mathématique élémentaire.

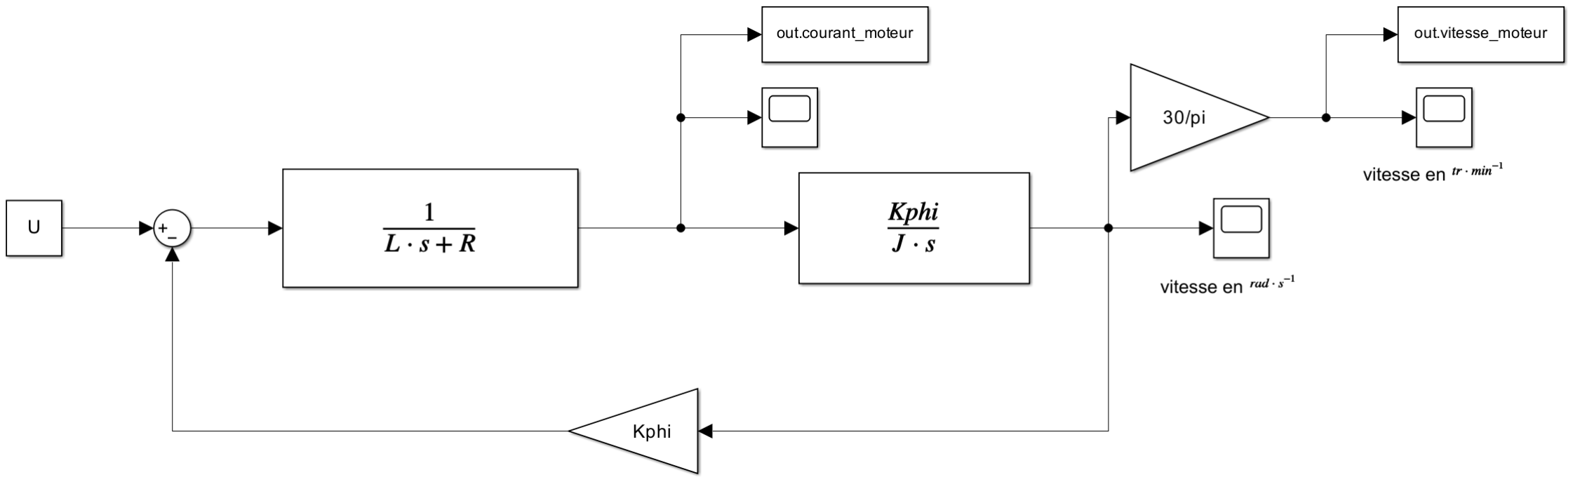
[picture p37: figure]

Figure 3.1 – Schéma Simulink du moteur à courant continu à vide

On remarque que le schéma Simulink présenté en Figure 3.1 intègre les équations de la MCC sans charge. Les simulations effectuées avec ce modèle permettent d’obtenir les réponses temporelles du courant et de la vitesse du moteur à vide, illustrées dans la Figure 3.2.

- Figure 3.1: Modélisation_Intermédiaire_VALIDE/00_Moteur_a_Vide/Moteur_Seul_VALIDE_12_09_2025.slx | 8/36


Figure 3.2 – Courbes de réponse du moteur à courant continu

### 1.3. Simulation sur PSIM

Pour la simulation sur PSIM, nous adoptons une approche méthodologique complémentaire. L’utilisation de deux méthodes distinctes (Simulink et PSIM) constitue une validation croisée : si les résultats concordent, nous pourrons confirmer la validité de nos modélisations. Contrairement à Simulink qui nécessite la construction du modèle à partir des équations différentielles, PSIM propose une approche plus directe basée sur l’utilisation de composants prédéfinis. Le logiciel met à disposition une bibliothèque de machines à courant continu standards qu’il suffit de paramétrer avec les caractéristiques de notre moteur réel. Cette méthodologie se rapproche davantage du fonctionnement physique du système et réduit significativement le nombre de calculs intermédiaires.

Le principe de modélisation sous PSIM repose sur l’assemblage de composants dont on définit ensuite les propriétés. Par exemple, pour simuler notre moteur, nous plaçons simplement un bloc « moteur DC » dans l’environnement de travail, puis nous renseignons ses paramètres électriques et mécaniques.


Figure 3.3 – Modélisation du moteur à courant continu sur PSIM

### 1.4. Comparaison des résultats

Nous comparons les résultats avec un programme MATLAB. Pour cela, nous avons besoin de récupérer les valeurs de notre modélisation sous forme de tableau : X =

t i(t) ω(t)

On retrouve bien les valeurs attendues, notamment en vitesse où on a la relation suivante à

- Figure 3.2: Modélisation_Intermédiaire_VALIDE/00_Moteur_a_Vide/Moteur_Seul_VALIDE_12_09_2025.slx
- Figure 3.3: Modélisation_Intermédiaire_VALIDE/00_Moteur_a_Vide/Moteur_Seul_VALIDE_12_09_2025.psimsch

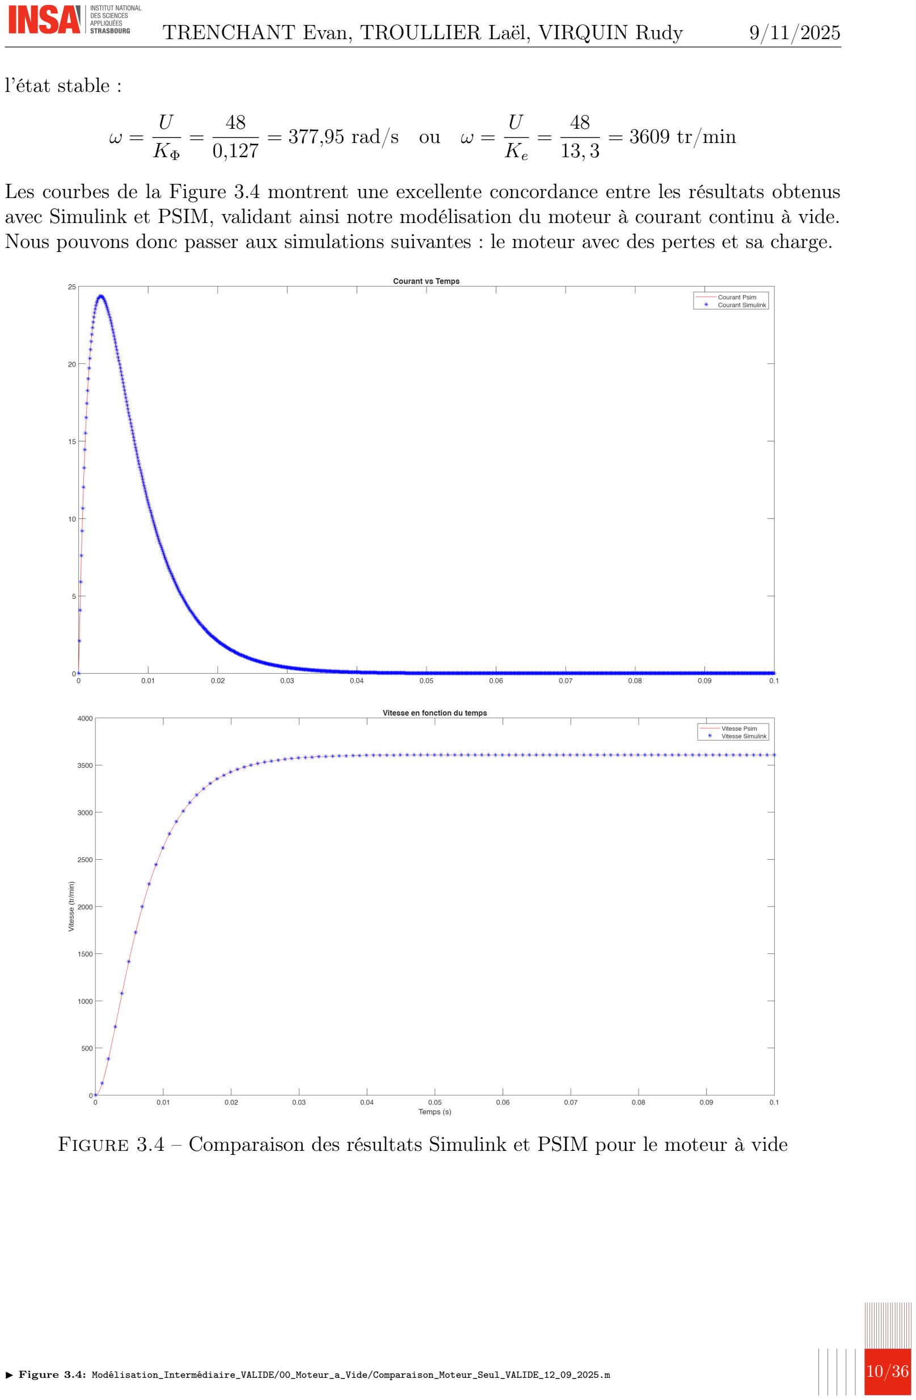
[picture p38: page 10]

l’état stable :

ω =

U
KΦ

=

48
0,127

= 377,95 rad/s ou ω =

U
Ke

=

48
13, 3

= 3609 tr/min

Les courbes de la Figure 3.4 montrent une excellente concordance entre les résultats obtenus avec Simulink et PSIM, validant ainsi notre modélisation du moteur à courant continu à vide. Nous pouvons donc passer aux simulations suivantes : le moteur avec des pertes et sa charge.

Figure 3.4 – Comparaison des résultats Simulink et PSIM pour le moteur à vide

- Figure 3.4: Modélisation_Intermédiaire_VALIDE/00_Moteur_a_Vide/Comparaison_Moteur_Seul_VALIDE_12_09_2025.m | 10/36

### 2. Modélisation de la MCC avec charge

Dans cette partie, nous allons effectuer la même logique qu’avec le moteur à vide. Cette fois-ci le moteur a des pertes, appelées frottements, et le couple résistant du moteur est pris en compte. On note :

f = Cf · Ω = 30
π

·

1
1 000
- 0,53 · 10⁻² = 5,06 · 10⁻⁵ N.m/rad.s

Cr = 2 · C0 = 0,024 N.m

### 2.1. Équations de la MCC avec pertes

Les équations de notre système vont donc changer. En effet en ajoutant les frottements, le système devient :

Formules d’une MCC avec pertes

u(t) = R · i(t) + L

di(t)
dt + e(t)

Cm(t) = Kc · i(t)

e(t) = Ke · ω(t)

J

dω
dt = Cm(t) − f · ω(t) − Cr(t)

Ce qui donne dans le domaine de Laplace :

Équations dans le domaine de Laplace

I(s) = U(s) − KΦΩ
R + Ls

Cm(s) = KΦ · I(s)

E(s) = KΦ · Ω(s)

Ω(s) = Cm + Cr
Js + f

Une fois les équations trouvées, nous allons pouvoir déterminer le schéma bloc et effectuer les mesures.

### 2.2. Simulation Simulink

Le schéma bloc n’est plus le même. En effet, celui-ci devient plus complexe, puisque qu’on y ajoute le couple résistant Cr et les frottements f.


Figure 3.5 – Schéma Simulink du moteur à courant continu avec charge et frottements

### 2.3. Simulation sur PSIM

De manière analogue à la simulation du moteur à vide, nous utilisons PSIM pour valider le modèle Simulink incluant cette fois-ci la charge et les frottements. La démarche reste similaire : nous utilisons le bloc moteur à courant continu de PSIM, mais en y ajoutant les paramètres de couple résistant (Cr) et de frottement visqueux (f). Cette approche directe, basée sur des composants physiques, permet de vérifier la cohérence des résultats obtenus par la modélisation par équations dans Simulink.


Figure 3.6 – Modélisation du moteur avec charge et frottements sur PSIM

- Figure 3.5: Modélisation_Intermédiaire_VALIDE/01_Moteur_Charge_Frottement/Moteur_Charge_Frottement_VALIDE_03_11_2025.slx
- Figure 3.6: Modélisation_Intermédiaire_VALIDE/01_Moteur_Charge_Frottement/Moteur_Charge_Frottement_VALIDE_03_11_2025.psimsch

### 2.4. Comparaison des résultats


Figure 3.7 – Comparaison des résultats Simulink et PSIM pour le moteur avec charge

Les courbes de la Figure 3.7 confirment la validité de notre modélisation avec charge et frottements. On observe une superposition quasi-parfaite des résultats Simulink (marqueurs) et PSIM (ligne continue) sur l’ensemble des grandeurs mesurées. La vitesse atteint un régime permanent
à environ 3100 tr/min, valeur inférieure à celle du moteur à vide (3609 tr/min) en raison de
la présence de la charge de 10 Ω, du couple résistant Cr et des frottements visqueux. Le cou-
- Figure 3.7: Modélisation_Intermédiaire_VALIDE/01_Moteur_Charge_Frottement/Comparaison_Courant_Moteur_Charge_Frottement_VALIDE_03_11_2025.m | 13/36

rant d’induit présente un pic initial caractéristique du démarrage, puis se stabilise à une valeur permanente correspondant à l’équilibre entre le couple moteur et les couples résistifs. Cette concordance valide l’implémentation des pertes mécaniques dans les deux environnements de simulation.

### 3. Modélisation de la MCC avec charge et hacheur

### 3.1. Modélisation du hacheur

Le hacheur, ou convertisseur continu–continu, est un dispositif d’électronique de puissance qui permet de modifier la valeur moyenne d’une tension continue à l’aide d’interrupteurs commandés. Il est couramment utilisé pour piloter des charges électriques (ici une machine à courant continu) avec un bon rendement.
Sur PSIM, le hacheur est modélisé par un pont en H composé de quatre transistors MOSFET pilotés en paires. Le schéma fonctionnel comporte le pont en H alimenté par une source continue (ici 48 V), un générateur de signal triangulaire et un comparateur qui produit le signal PWM de commande.


Figure 3.8 – Modélisation du hacheur sur PSIM

Le hacheur fournit une tension de sortie moyenne qui peut être positive ou négative (mode bipolaire). La valeur moyenne de la tension de sortie Vs dépend de trois grandeurs : la tension d’alimentation (ici 48 V), la tension de commande continue (notée Vcommande) et le rapport cyclique α du signal de commande (duty cycle) appliqué aux interrupteurs.
La commutation des transistors s’effectue par paires (par exemple 1 et 4 d’une part, 2 et 3 d’autre part) de façon complémentaire afin de piloter le pont en H. Le rapport cyclique α correspond à la proportion de la période pendant laquelle l’interrupteur est fermé. Pour α = 0 la tension de sortie vaut Vs = −48 V, pour α = 1 on obtient Vs = +48 V, et pour des valeurs intermédiaires de α la tension de sortie varie de manière (approximativement) linéaire entre ces extrêmes. Ainsi, une augmentation de α entraîne une augmentation de Vs.
La commande PWM est générée en comparant, au moyen d’un comparateur (ou d’un AOP configuré), une tension continue de référence Ve = Vcommande avec un signal triangulaire Vtriangle
- Figure 3.8: Modélisation_Intermédiaire_VALIDE/02_Moteur_Hacheur/Moteur_Hacheur_VALIDE_03_11_2025.psimsch | 14/36

qui varie typiquement de 0 à 15 V. Le comparateur produit alors le signal Vpwm dont le rapport cyclique est proportionnel à Vcommande. En sortie du comparateur, des suiveurs (buffers) sont placés pour assurer une adaptation d’impédance et piloter correctement les étages de commande des MOSFET.

### 3.2. Caractéristique du hacheur

Le hacheur utilisé possède une caractéristique de transfert non-linéaire avec une zone morte. La tension de sortie moyenne ⟨uAB⟩ dépend de la tension de commande ucommande selon la relation suivante :

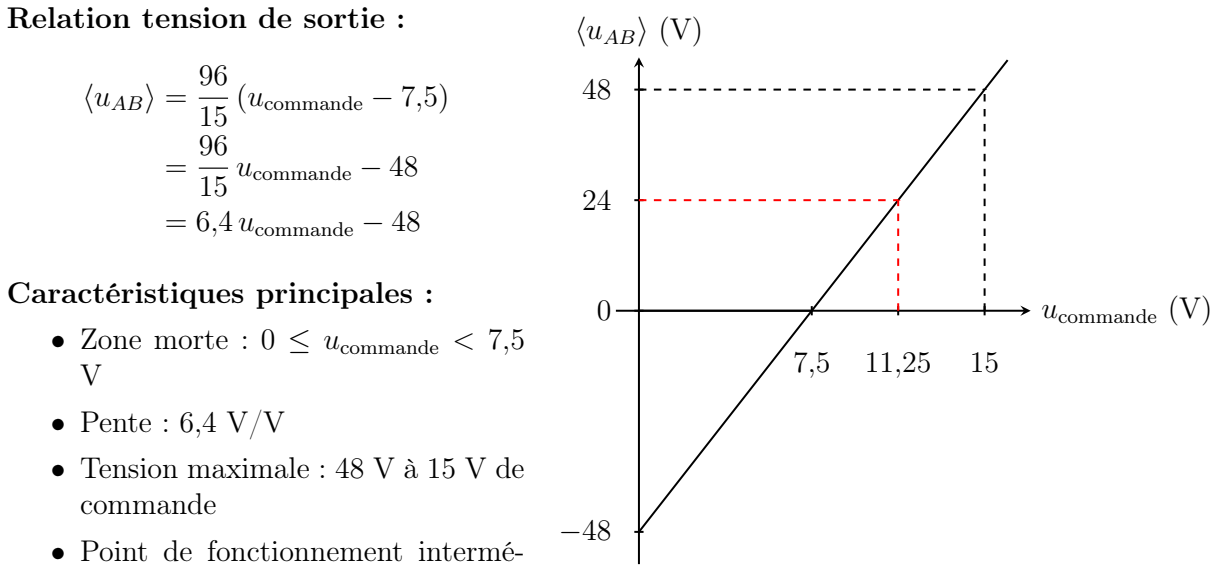
[picture p39: figure]
Relation tension de sortie :; ⟨uAB⟩ =; (ucommande − 7,5); ucommande − 48; = 6,4 ucommande − 48; Caractéristiques principales :; • Zone morte : 0 ≤ ucommande < 7,5 V; • Pente : 6,4 V/V; • Tension maximale : 48 V à 15 V de commande; • Point de fonctionnement intermé-; ⟨uAB⟩ (V); ucommande (V)

diaire (en rouge) : (11,25 V; 24 V)
Figure 3.9 – Caractéristique de transfert du hacheur

Cette caractéristique montre que le hacheur présente une zone morte pour les faibles tensions de commande (inférieures à 7,5 V), puis un comportement linéaire avec un gain de 6,4. La tension de sortie est limitée à ±48 V.

### 3.3. Simulation sur Simulink


Figure 3.10 – Modélisation du moteur avec hacheur sur Simulink

- Figure 3.10: Modélisation_Intermédiaire_VALIDE/02_Moteur_Hacheur/Moteur_Hacheur_VALIDE_03_11_2025.slx | 15/36

### 3.4. Comparaison des résultats

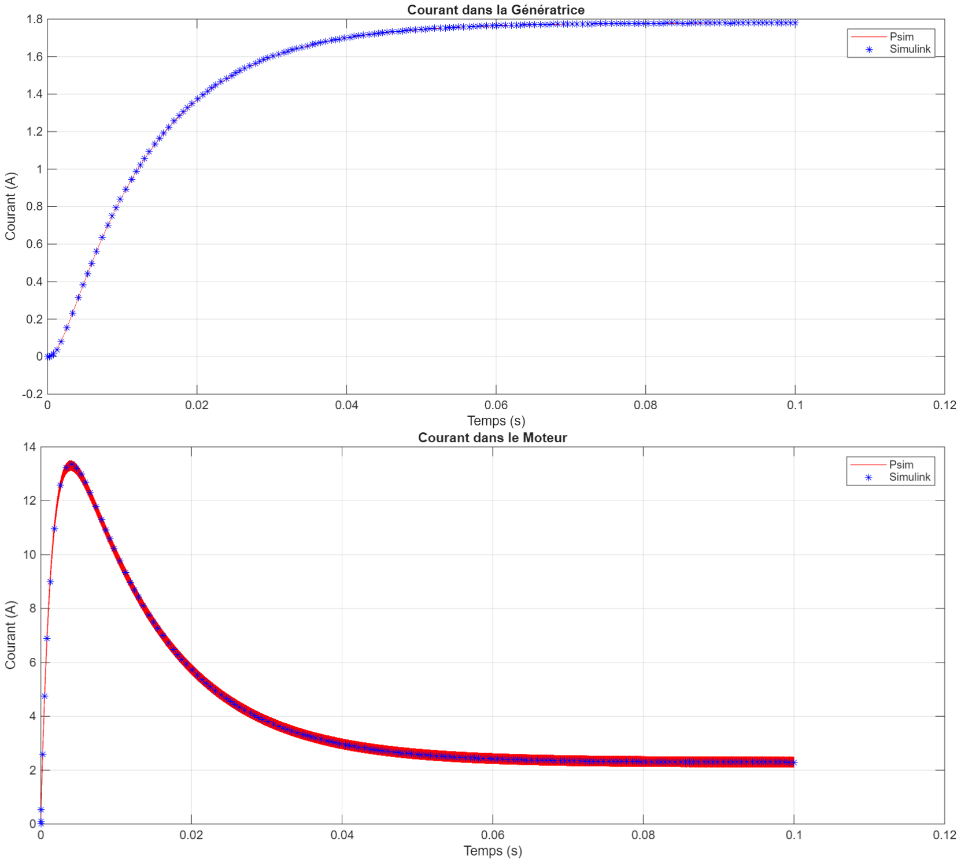
[picture p40: figure]

Figure 3.11 – Comparaison des résultats Simulink et PSIM pour le moteur avec hacheur

Les résultats présentés dans la Figure 3.11 démontrent la cohérence entre les modélisations Simulink et PSIM du système complet moteur-hacheur. Les trois grandeurs observées (courant générateur, courant moteur et vitesse) montrent une excellente superposition des courbes issues des deux simulateurs. On constate notamment que l’introduction du hacheur impose
une dynamique légèrement différente par rapport à l’alimentation directe, avec des ondulations
- Figure 3.11: Modélisation_Intermédiaire_VALIDE/02_Moteur_Hacheur/Comparaison_Courant_Moteur_Hacheur_VALIDE_03_11_2025.m | 16/36

caractéristiques de la modulation PWM. La vitesse converge vers une valeur de régime permanent proche de 3100 tr/min, cohérente avec le point de fonctionnement imposé par la tension de commande du hacheur. Cette validation croisée confirme la justesse de notre modélisation du convertisseur statique et de son interaction avec la charge mécanique.

### 4. Simplification du schéma bloc

A ce stade de l’analyse, nous disposons du schéma bloc complet de notre système, avant asservissement en vitesse. Comme illustré dans la Figure 3.12, ce schéma est assez complexe en raison de la présence de plusieurs boucles de rétroaction imbriquées. Pour faciliter l’analyse et la conception des contrôleurs, il est nécessaire de simplifier ce schéma bloc en combinant les différents éléments.

Cette simplification permet d’obtenir une représentation plus concise du système, facilitant ainsi l’analyse et la conception des contrôleurs.
ε = e − B · Ω − C · Ω
s = A · ε = A · (e − (B + C) · s)

=⇒ s =

A · e
1 + A · (B + C)

= H · e

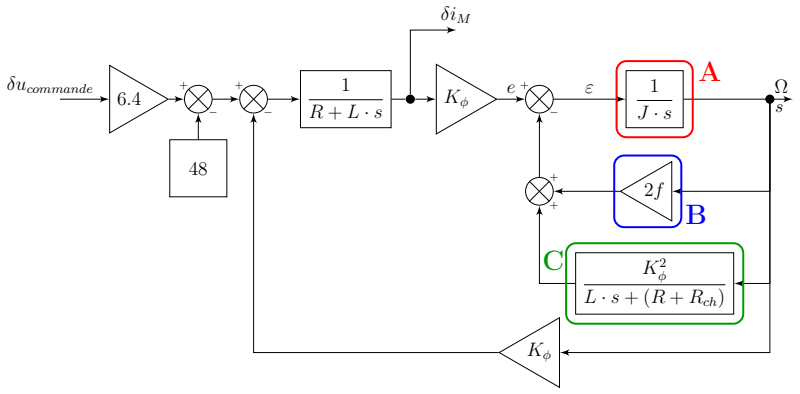
[picture p41: figure]
δiM; K² ϕ L · s + (R + Rch); δucommande

Figure 3.12 – Schéma bloc de l’asservissement en courant avec boucle de courant imbriquée

Le diagramme bloc simplifié de l’asservissement en vitesse est présenté dans la Figure 3.13.

6.4

48

+

−

+

−

1
R + L · s

Kϕ · H

δiM

s

Kϕ

δucommande | Ω

Figure 3.13 – Schéma bloc de l’asservissement en courant simplifié

On peut alors écrire la fonction de transfert en boucle ouverte du système simplifié :

δiM (s) =

1
R + L · s

1 +

(Kϕ)

2
- H
R + L · s
- δucommande(s) = F T BO(s) · δucommande(s)

Pour s’assurer que notre fonction de transfert est correcte, il faudrait la valider par des simulations numériques en comparant les résultats obtenus. Il serait alors possible de poursuivre l’analyse en utilisant cette fonction de transfert simplifiée pour concevoir et optimiser le contrôleur de l’asservissement en vitesse du moteur.

# 4 - Étude de l’asservissement de la MCC

### 1. Asservissement en courant

L’asservissement en courant du moteur constitue la boucle interne de notre système de régulation en cascade. Son rôle principal est d’assurer que le courant absorbé par le moteur suive fidèlement la consigne fournie par l’asservissement en vitesse. Cette régulation permet de contrôler précisément le couple moteur et d’améliorer la dynamique globale du système.

### 1.1. Modélisation sur Simulink

L’asservissement en courant doit appliquer la consigne déterminée par l’asservissement en vitesse. Pour cela, nous mettons en œuvre un correcteur Proportionnel-Intégral (PI). Le cahier des charges impose un temps de réponse égal à 10 fois la période de la modulation de largeur d’impulsion (MLI), soit 0.45 ms, avec un dépassement maximal de 20 %.
À l’aide de l’outil PID Tuner de Simulink, nous obtenons les paramètres optimaux suivants pour le correcteur PI :
- Gain proportionnel : Kp = 5,053
- Gain intégral : Ki = 36 349,6

Il est important de souligner que la notation du correcteur PI diffère entre Simulink et PSIM. Sur PSIM, la valeur du paramètre τ représente le rapport Kp
Ki

, tandis que sur Simulink, les deux gains sont exprimés directement.

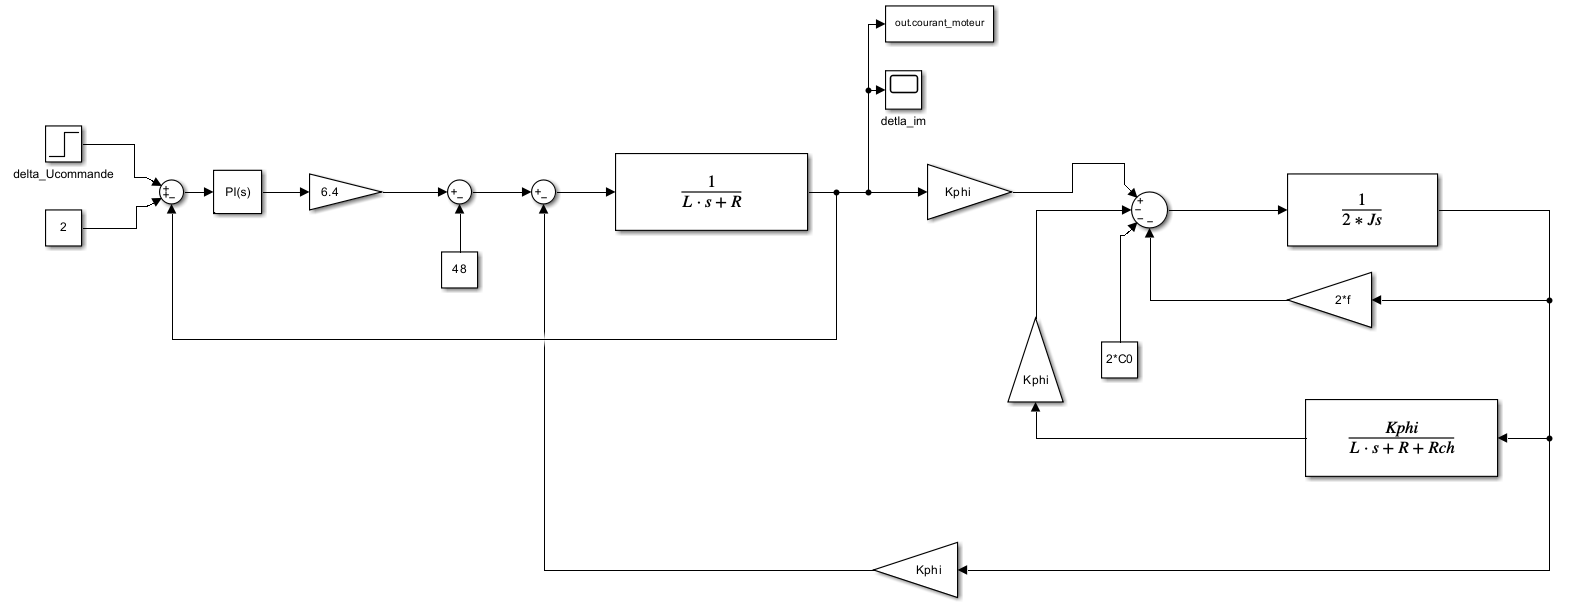
[picture p42: figure]

Figure 4.1 – Schéma de l’asservissement en courant du moteur dans Simulink

### 1.2. Modélisation sur PSIM

Pour adapter le correcteur PI de Simulink à PSIM, il faut convertir les paramètres en utilisant les relations suivantes :
Dans Simulink :

G(s) = Kp +

Ki
s

= Kp

s +

Ki
Kp
s
- Figure 4.1: Modélisation_Intermédiaire_VALIDE/03_BF_Courant/BF_Courant_VALIDE_06_11_2025.slx | 18/36

Dans PSIM :
G(s) = k

1 + sT
sT

⇒ k = Kp et T =

Kp
Ki

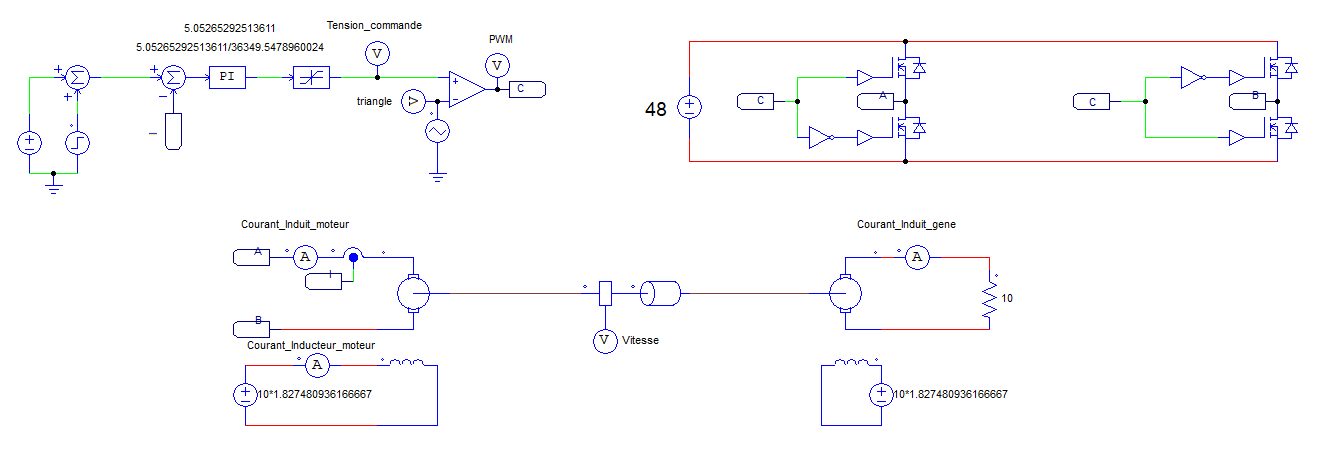
[picture p43: figure]

Figure 4.2 – Schéma de l’asservissement en courant du moteur dans PSIM

### 1.3. Comparaison des résultats

Dans cette section, nous allons comparer les résultats obtenus avec les deux outils de simulation, Simulink et PSIM.

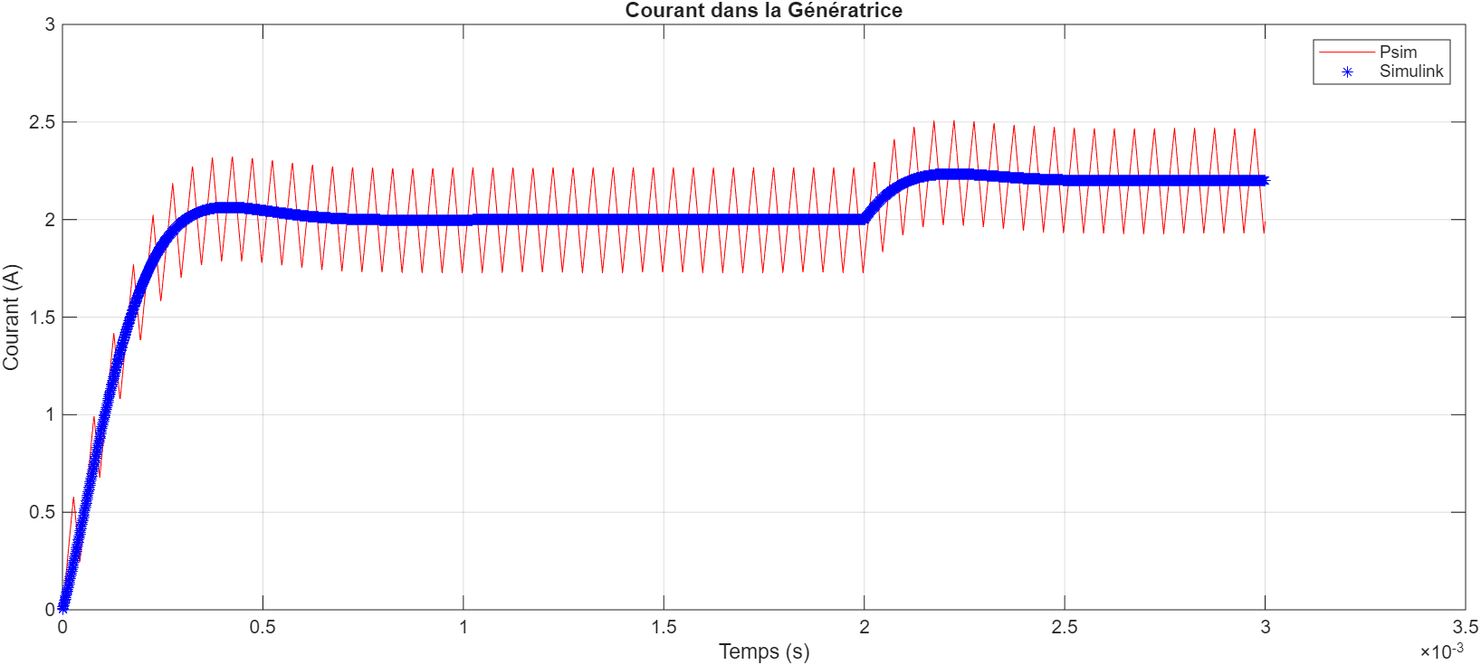
[picture p44: figure]

Figure 4.3 – Comparaison des réponses indicielle de l’asservissement en courant du moteur entre Simulink et PSIM

La figure 4.3 illustre la comparaison des réponses indicielle de l’asservissement en courant du moteur entre Simulink et PSIM. Les deux courbes sont quasiment superposées, ce qui confirme la cohérence des modélisations réalisées dans les deux environnements.
On constate que la réponse indicielle de l’asservissement en courant du moteur présente un dépassement d’environ 19% et un temps de réponse de 0,35 ms. Ce qui respecte les spécifications du cahier des charges qui exige un dépassement maximal de 20% et un temps de réponse maximal de 10 fois la prériode de la MLI soit 0,45 ms.
- Figure 4.2: Modélisation_Intermédiaire_VALIDE/03_BF_Courant/BF_Courant_VALIDE_06_11_2025.psimsch
- Figure 4.3: Modélisation_Intermédiaire_VALIDE/03_BF_Courant/Comparaison_Asservissement_Courant_VALIDE_06_11_2025.m

### 2. Asservissement en vitesse avec dynamo tachymétrique

L’asservissement en vitesse constitue la boucle externe et la régulation principale de notre système de contrôle en cascade. Contrairement à l’asservissement en courant qui opère sur une grandeur électrique interne, l’asservissement en vitesse agit directement sur la grandeur mécanique d’intérêt pour l’application finale. C’est donc cet asservissement qui détermine les performances réelles du système vis-à-vis des exigences du cahier des charges.
La régulation en vitesse permet de garantir que le moteur atteint et maintient la vitesse de rotation souhaitée, indépendamment des perturbations externes telles que les variations de charge ou les frottements. Elle assure également la rapidité de la réponse du système face aux changements de consigne, tout en limitant les dépassements pour éviter les sollicitations mécaniques excessives.
Dans cette section, nous utilisons une dynamo tachymétrique comme capteur de vitesse. Ce capteur analogique fournit une tension proportionnelle à la vitesse de rotation, ce qui permet une mise en œuvre simple et une mesure continue de la vitesse.

### 2.1. Principe de fonctionnement de la dynamo tachymétrique

La dynamo tachymétrique est une petite génératrice à courant continu couplée mécaniquement au moteur. Elle génère une tension proportionnelle à sa vitesse de rotation selon la relation :

Vtachy = Ktachy · ω

où Ktachy est la constante de la dynamo tachymétrique (en V/(rad/s)) et ω la vitesse angulaire du moteur.
Cette caractéristique linéaire en fait un capteur particulièrement adapté pour les asservissements analogiques, car la tension de sortie peut être directement utilisée comme signal de rétroaction sans nécessiter de conversion numérique-analogique.

### 2.2. Caractérisation en boucle ouverte

Nous commençons par la simulation de la vitesse du moteur en boucle ouverte sur Simulink afin d’établir une référence de performance. Nous réalisons le schéma suivant :

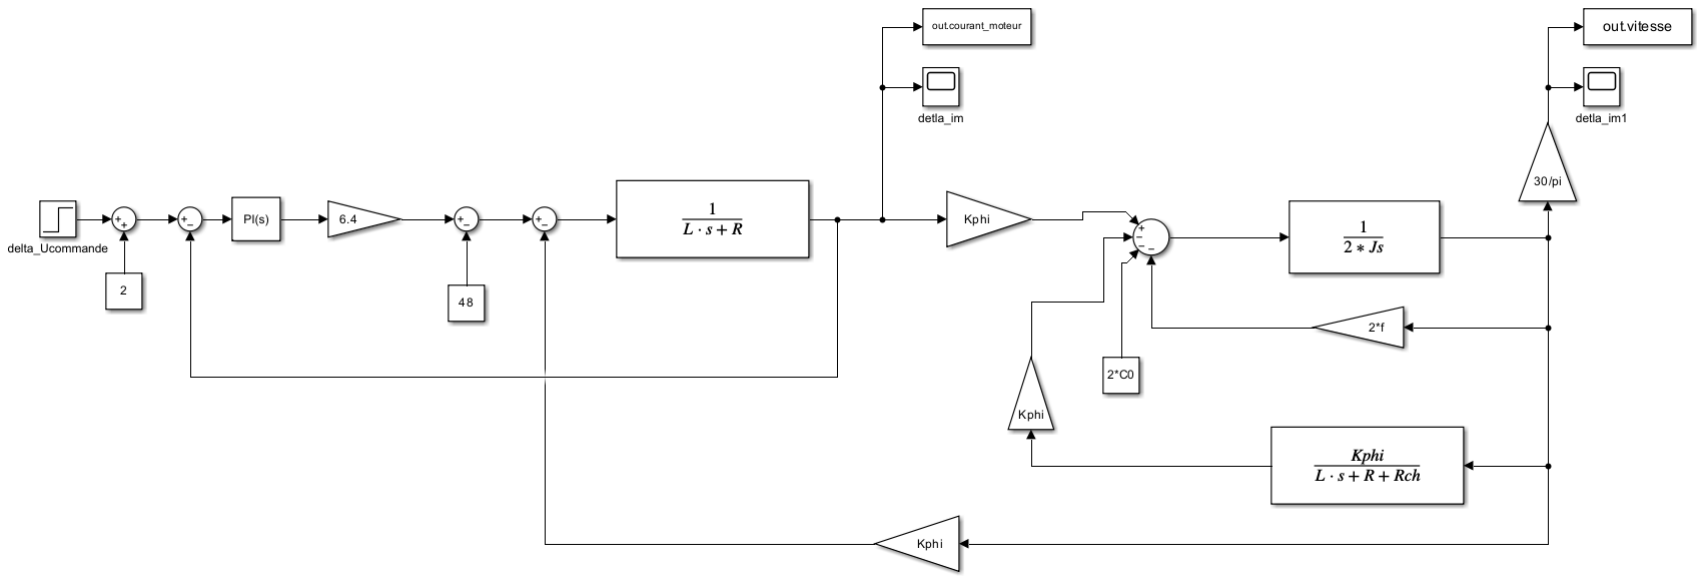
[picture p45: figure]

Figure 4.4 – Schéma de la simulation en boucle ouverte de la vitesse du moteur dans Simulink

La simulation en boucle ouverte nous permet d’observer la réponse naturelle du système sans rétroaction. Cette étape est essentielle pour comprendre les limites intrinsèques du système et établir les objectifs d’amélioration pour l’asservissement. Pour effectuer cette caractérisation,

- Figure 4.4: Modélisation_Intermédiaire_VALIDE/04_BF_Courant_Vitesse/BO_Vitesse/BO_Vitesse_VALIDE_06_11_2025.slx | 20/36

nous attendons d’abord que le système atteigne son régime permanent, puis nous appliquons une consigne en échelon pour observer la dynamique de réponse.

L’analyse de la réponse indicielle révèle un temps de réponse à 5 % en boucle ouverte de 124.1 ms. Cette valeur relativement élevée indique une dynamique lente qui ne serait pas acceptable pour de nombreuses applications industrielles nécessitant des temps de réaction rapides.

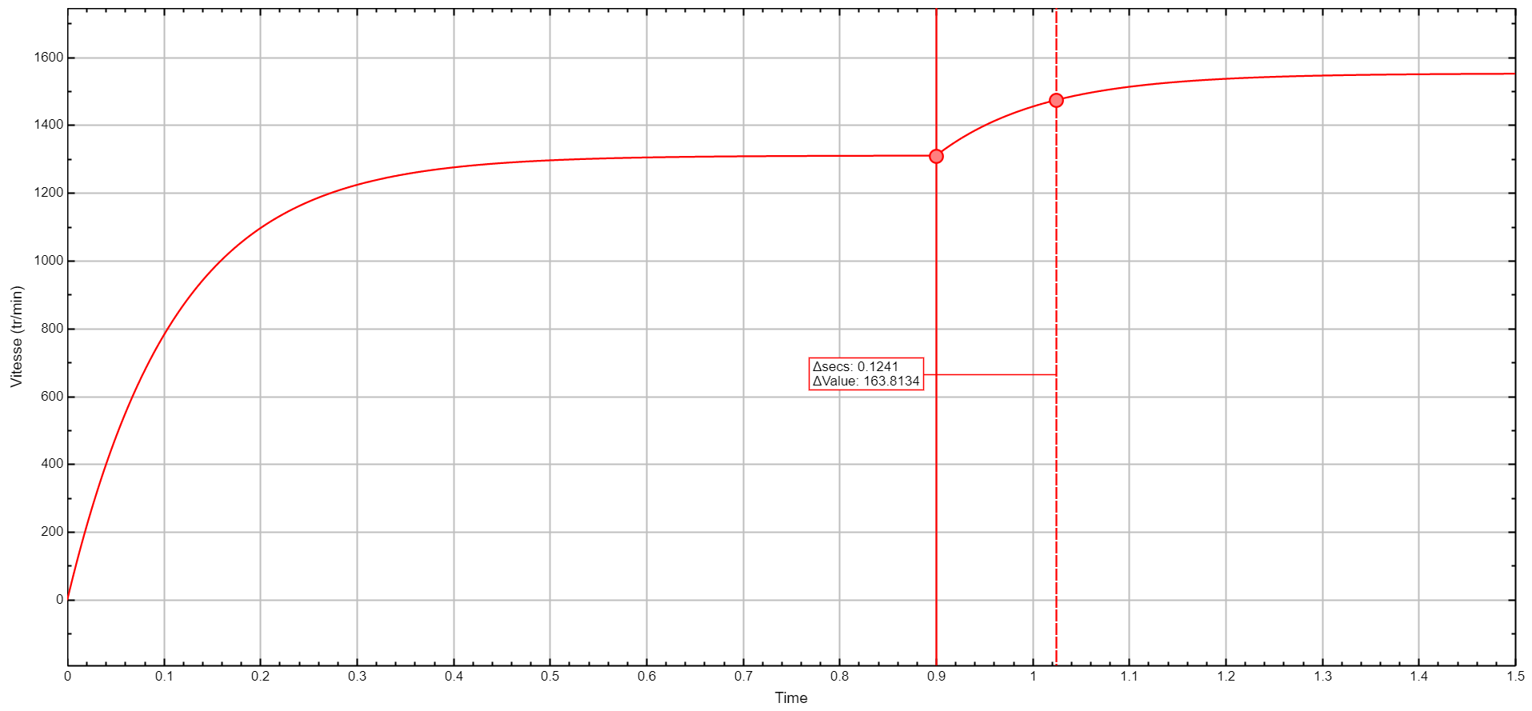
[picture p46: figure]

Figure 4.5 – Réponse de la vitesse du moteur en boucle ouverte dans Simulink

### 2.3. Conception du correcteur PI

Face aux limitations observées en boucle ouverte, nous mettons en œuvre un asservissement en boucle fermée avec un correcteur PI. L’objectif de cet asservissement est d’améliorer drastiquement les performances dynamiques du système. Nous visons un temps de réponse à 5 % trois fois plus rapide qu’en boucle ouverte, soit 41.37 ms, tout en maintenant un dépassement maximal de 20 % pour limiter les contraintes mécaniques.

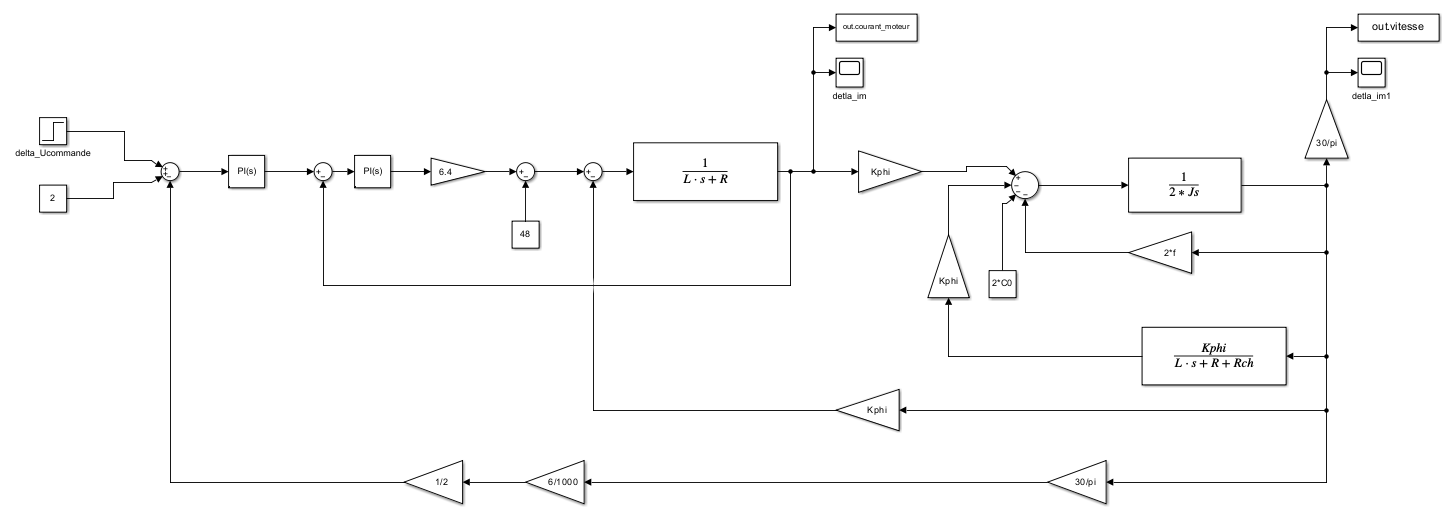
[picture p47: figure]

Figure 4.6 – Schéma de l’asservissement en vitesse du moteur dans Simulink

Le schéma présente l’architecture complète du système de régulation en cascade : la boucle externe d’asservissement en vitesse génère une consigne de courant qui est ensuite régulée par la boucle interne d’asservissement en courant. Cette structure en cascade permet de bénéficier d’une meilleure robustesse et d’une dynamique optimisée.
À l’aide de l’outil PID Tuner de Simulink, nous déterminons les paramètres optimaux du correcteur PI permettant de satisfaire les spécifications temporelles imposées :
- Figure 4.5: Modélisation_Intermédiaire_VALIDE/04_BF_Courant_Vitesse/BO_Vitesse/BO_Vitesse_VALIDE_06_11_2025.slx
- Figure 4.6: Modélisation_Intermédiaire_VALIDE/04_BF_Courant_Vitesse/BF_Vitesse/BF_Courant_Vitesse_VALIDE_06_11_2025.slx

- Gain proportionnel : Kp = 6,68
- Gain intégral : Ki = 496,43

Ces valeurs résultent d’un compromis entre rapidité et stabilité, garantissant une réponse dynamique tout en évitant les oscillations excessives qui pourraient endommager le système mécanique.

### 2.4. Validation sur PSIM

Après avoir conçu et validé le correcteur PI sur Simulink, nous procédons à l’implémentation du système complet sur PSIM. Cette étape est cruciale car PSIM offre une modélisation plus proche de la réalité physique, notamment en ce qui concerne les composants électroniques de puissance et leurs caractéristiques non-idéales. Comme pour l’asservissement en courant, il est nécessaire d’adapter les paramètres du correcteur PI de Simulink vers la notation utilisée par PSIM, en utilisant les relations de conversion présentées précédemment :

k = Kp et T =

Kp
Ki

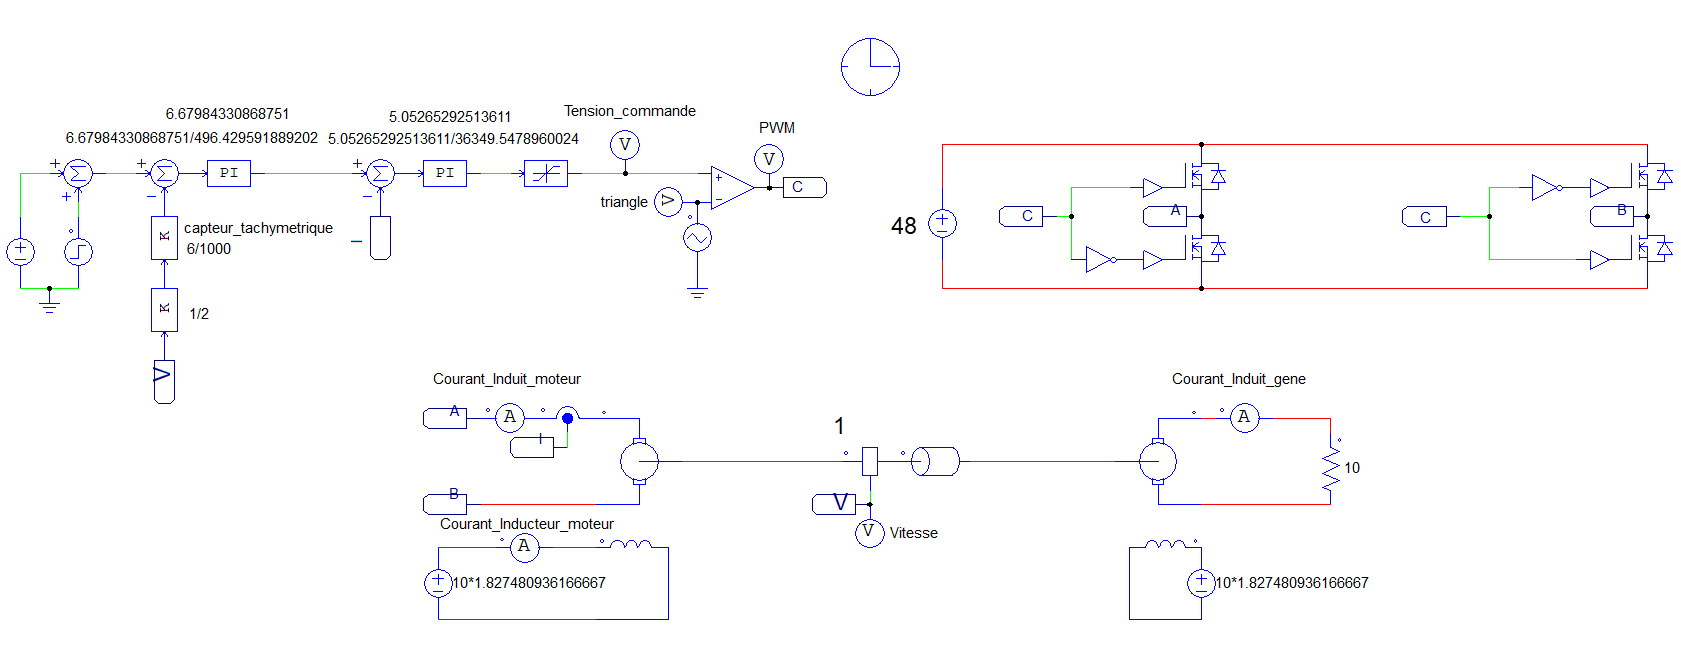
[picture p48: figure]

Figure 4.7 – Schéma de l’asservissement en vitesse du moteur dans PSIM

Le schéma PSIM intègre l’ensemble de la chaîne de régulation en cascade : l’asservissement en vitesse commande l’asservissement en courant, qui lui-même pilote le hacheur quatre quadrants alimentant le moteur à courant continu. Cette modélisation complète permet de simuler le comportement réel du système dans des conditions proches de l’implémentation finale.

### 2.5. Comparaison et validation des performances

La validation de notre approche de modélisation nécessite une comparaison rigoureuse entre les résultats obtenus sur Simulink et PSIM. Cette confrontation permet non seulement de vérifier la cohérence de nos modèles, mais également de confirmer que les performances visées sont effectivement atteintes dans les deux environnements de simulation.

- Figure 4.7: Modélisation_Intermédiaire_VALIDE/04_BF_Courant_Vitesse/BF_Vitesse/BF_Asservissement_Courant_Vitesse_VALIDE_06_11_2025.psimsch | 22/36

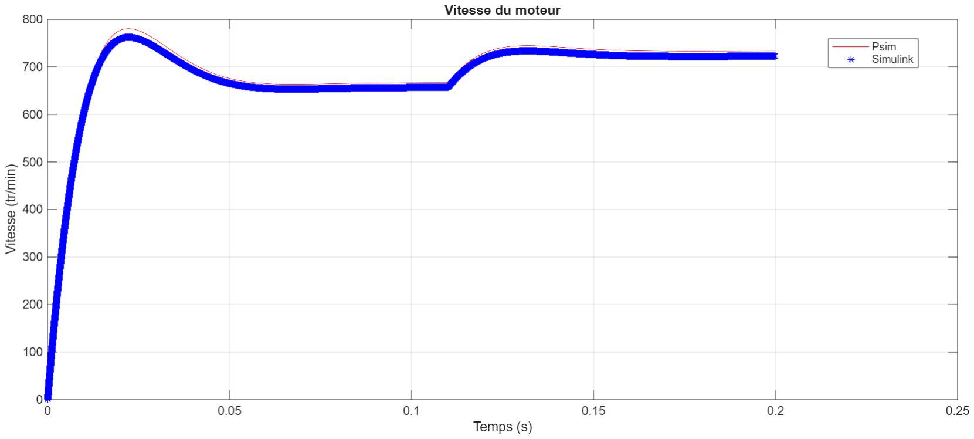
[picture p49: figure]

Figure 4.8 – Comparaison des réponses en vitesse entre Simulink et PSIM

La figure 4.8 illustre une superposition quasi-parfaite des réponses temporelles obtenues dans les deux environnements. Cette concordance remarquable valide la cohérence de nos modélisations et confirme que les paramètres du correcteur PI ont été correctement adaptés entre Simulink et PSIM. Pour faciliter la visualisation des deux courbes, un facteur de 0.99 a été appliqué aux valeurs de vitesse issues de Simulink.
L’analyse des performances révèle que l’asservissement en vitesse respecte pleinement les spécifications du cahier des charges :
- Le temps de réponse à 5 % est d’environ 39.8 ms, soit plus de trois fois plus rapide que la réponse en boucle ouverte (124.1 ms)
- Le dépassement observé reste inférieur à 20 % ( 18.5 %), ce qui limite les contraintes mécaniques sur le système d’entraînement
- Le régime permanent est atteint sans erreur statique grâce à l’action intégrale du correcteur PI

### 3. Asservissement en vitesse avec codeur incrémental

Le cahier des charges impose également la possibilité d’asservir la vitesse du moteur à l’aide d’un codeur incrémental. Contrairement à la dynamo tachymétrique qui fournit un signal analogique continu, le codeur incrémental est un capteur numérique qui génère des impulsions proportionnelles à la vitesse de rotation. Ce type de capteur offre une précision élevée et une meilleure immunité au bruit électromagnétique que les capteurs analogiques.
Dans cette section, nous présentons d’abord le principe de fonctionnement du codeur incrémental, puis nous validons son utilisation dans l’asservissement en vitesse à travers des simulations avec des correcteurs PI idéaux sur Simulink et PSIM.

### 3.1. Principe de fonctionnement du codeur incrémental

Le fonctionnement du codeur incrémental repose sur un disque rotatif équipé de fentes. Celui-ci est interposé entre une diode électroluminescente et un capteur photodiode. Lorsque le disque tourne, les fentes permettent à la lumière de passer à travers, générant ainsi des impulsions électriques dans le capteur. Le nombre d’impulsions générées par tour dépend de la résolution du codeur.

- Figure 4.8:
Modélisation_Intermédiaire_VALIDE/04_BF_Courant_Vitesse/Comparaison_BF_Vitesse/Comparaison_Asservissement_Courant_Vitesse_VALIDE_06_11_2025.m

Le codeur incrémental fourni est composé de deux pistes de fentes décalées d’un quart de période, ce qui permet de déterminer le sens de rotation du moteur en analysant la séquence des impulsions générées par les deux capteurs.

### 3.2. Calcul de la vitesse et du sens de rotation

Pour mesurer la vitesse de rotation du moteur, il suffit de compter le nombre d’impulsions générées par le codeur sur une période de temps donnée. La vitesse angulaire peut être calculée en utilisant la formule suivante :
ω =

N · 2π
P · T
où :
- ω est la vitesse angulaire en radians par seconde (rad/s)
- N est le nombre d’impulsions comptées
- P est le nombre d’impulsions par tour du codeur
- T est la période de temps pendant laquelle les impulsions sont comptées en secondes (s)
- 2π est une constante pour convertir les tours en radians
Pour connaitre le sens de rotation, on analyse la séquence des impulsions des deux pistes. Si la piste A précède la piste B, le moteur tourne dans un sens. Si la piste B précède la piste A, le moteur tourne dans le sens inverse.

Rotation positive (A précède B)

A

B

t

Rotation négative (B précède A)

A

B

t

Figure 4.9 – Chronogrammes selon le sens de rotation avec le codeur incrémental

### 3.3. Simulation avec correcteurs PI idéaux sur PSIM

A présent, nous implémentons l’asservissement en vitesse avec le codeur incrémental en utilisant des correcteurs PI idéaux (blocs PI de PSIM). Cette étape permet de valider le principe de fonctionnement du système avant de passer à l’implémentation avec des composants réels. Nous obtenons le schéma suivant pour la partie codeur incrémental :

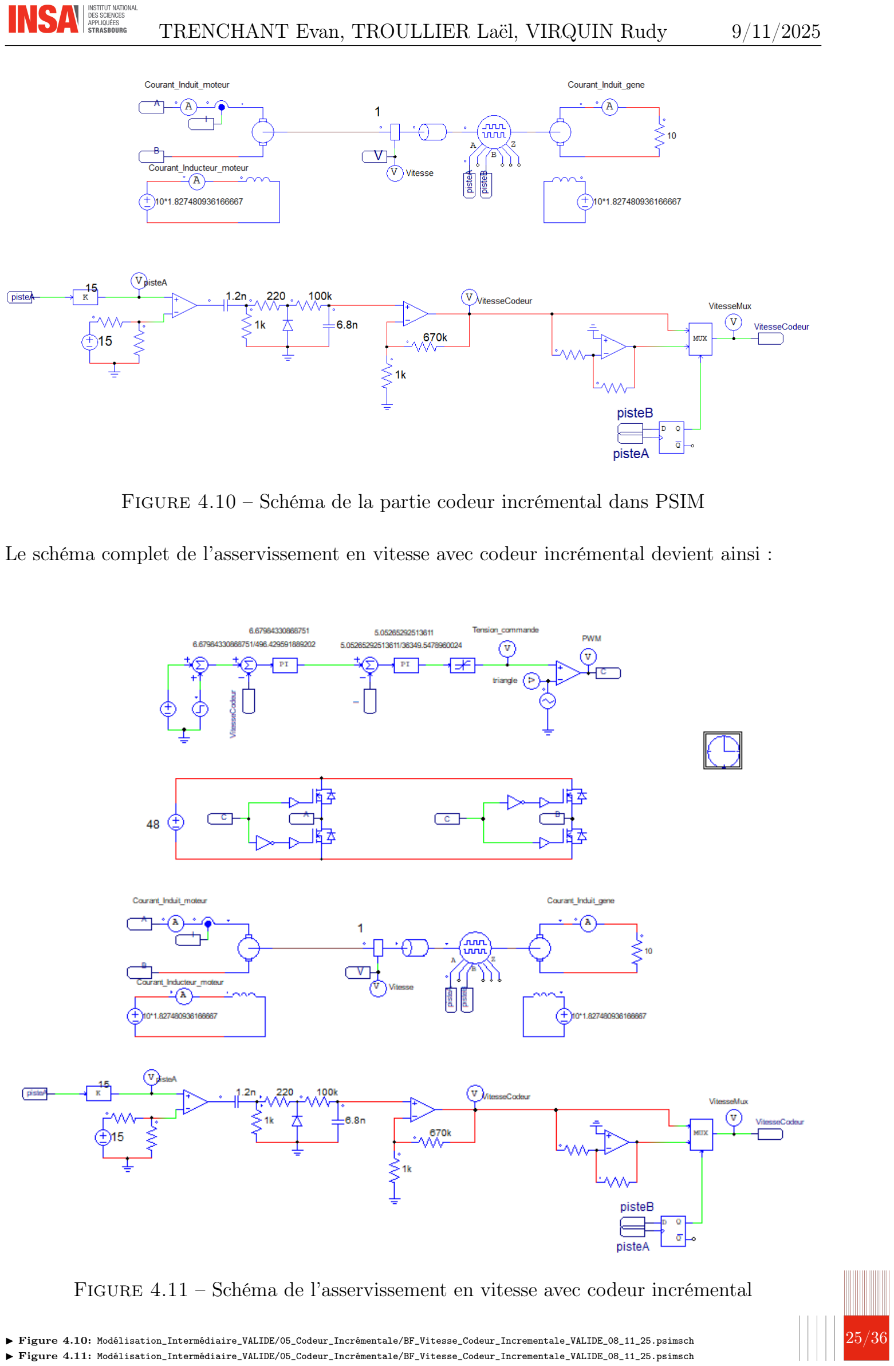
[picture p50: page 25]

Figure 4.10 – Schéma de la partie codeur incrémental dans PSIM

Le schéma complet de l’asservissement en vitesse avec codeur incrémental devient ainsi :

Figure 4.11 – Schéma de l’asservissement en vitesse avec codeur incrémental

- Figure 4.10: Modélisation_Intermédiaire_VALIDE/05_Codeur_Incrémentale/BF_Vitesse_Codeur_Incrementale_VALIDE_08_11_25.psimsch
- Figure 4.11: Modélisation_Intermédiaire_VALIDE/05_Codeur_Incrémentale/BF_Vitesse_Codeur_Incrementale_VALIDE_08_11_25.psimsch

### 3.4. Comparaison des résultats avec codeur incrémental

Nous comparons ici les résultats obtenus avec Simulink sans le codeur incrémental et PSIM avec l’asservissement en vitesse utilisant le codeur incrémental. Cette comparaison permet de valider la cohérence de nos modélisations et de vérifier que les performances sont conformes au cahier des charges.

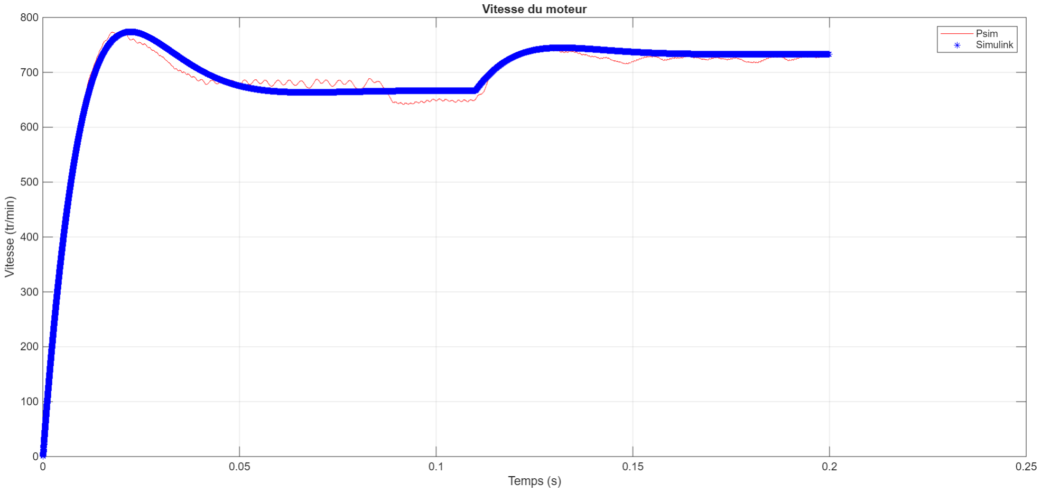
[picture p51: figure]

Figure 4.12 – Comparaison des résultats entre Simulink et PSIM avec codeur incrémental

La figure 4.12 présente une superposition des réponses en vitesse obtenues avec l’asservissement utilisant la dynamo tachymétrique sur Simulink et celui utilisant le codeur incrémental sur PSIM. Les deux courbes présentent une concordance satisfaisante, validant ainsi la cohérence entre les deux approches de mesure de vitesse.
On observe toutefois une différence notable dans l’allure des signaux : la réponse avec la dynamo tachymétrique présente une courbe lisse, tandis que celle avec le codeur incrémental affiche des oscillations caractéristiques. Cette différence s’explique par la nature fondamentalement différente des deux capteurs :
- Dynamo tachymétrique : capteur analogique générant une tension continue proportionnelle à la vitesse instantanée, produisant un signal de rétroaction lisse.
- Codeur incrémental : capteur numérique générant des impulsions discrètes. La vitesse est calculée en comptant les impulsions sur une fenêtre temporelle, introduisant une quantification qui crée un effet d’escalier entre deux impulsions successives.

Ces oscillations sont intrinsèques à la mesure numérique et leur amplitude dépend de la résolution du codeur (1000 impulsions/tour, soit 0.36◦
) et de la période d’échantillonnage. Malgré ces oscillations, les performances dynamiques moyennes restent conformes au cahier des charges : temps de réponse à 5 % d’environ 40 ms, dépassement inférieur à 20 %, et absence d’erreur statique. Le codeur incrémental constitue donc une alternative viable à la dynamo tachymétrique, offrant une meilleure immunité au bruit et une précision accrue. Les oscillations peuvent être atténuées par filtrage numérique si nécessaire.
- Figure 4.12: Modélisation_Intermédiaire_VALIDE/05_Codeur_Incrémentale/Comparaison_Vitesse_Codeur_Incremental_VALIDE_08_11_2025.m | 26/36

# 5 - Dimensionnement des asservissements

Après avoir validé la structure de contrôle avec des régulateurs PI idéaux en simulation, il est nécessaire de passer à l’étape de réalisation pratique. Cette phase consiste à traduire les fonctions de transfert théoriques en circuits électroniques réels à base d’amplificateurs opérationnels (AOP).
Le dimensionnement des asservissements constitue une étape cruciale du projet, car elle établit le lien entre la théorie et la mise en œuvre physique. Chaque bloc de la chaîne de commande doit être soigneusement dimensionné afin de garantir que les performances obtenues en simulation soient effectivement reproduites sur le système réel. Dans ce chapitre, nous détaillons le dimensionnement de chacun des éléments constitutifs de la boucle d’asservissement, en commençant par les circuits soustracteurs, puis en abordant les correcteurs PI pour les boucles de courant et de vitesse.

### 1. Réalisation des soustracteurs

Pour commencer nous réalisons un montage soustracteur permettant de comparer la sortie du montage a la commande.
On utilise alors ce montage a AOP qui permet, en choisissant les mêmes valeurs de résistances, d’obtenir un soustracteur simple :

VS = V2 − V1

On choisit des résistances de 10kΩ pour la réalisation pratique.

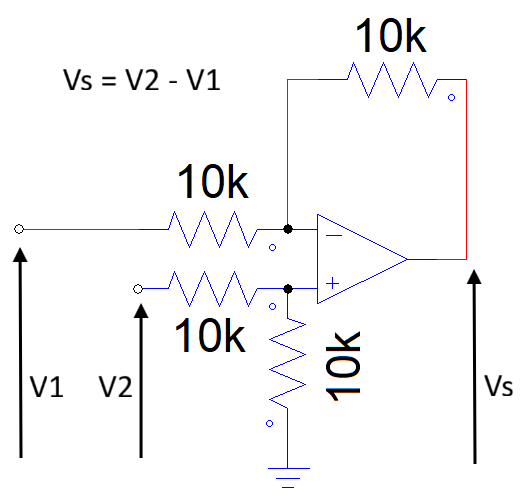
[picture p52: figure]

Figure 5.1 – Montage soustracteur à AOP

### 2. Dimensionnement des correcteurs réels

### 2.1. Structure du correcteur PI

La structure du correcteur PI à implémenter est représentée à la figure 5.2.

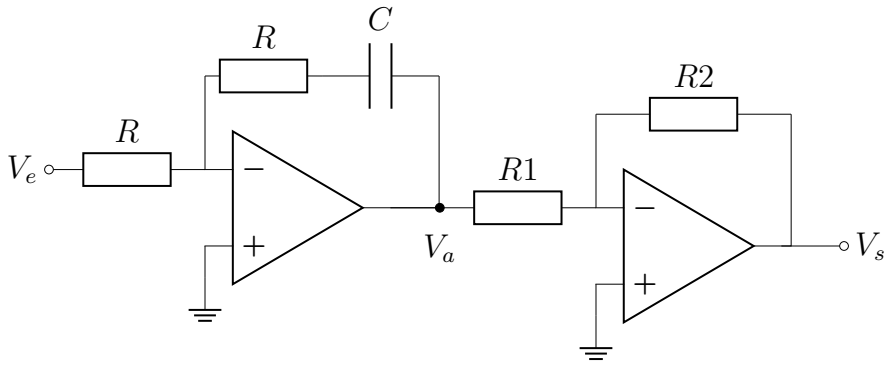
[picture p53: figure]

Figure 5.2 – Schéma d’un correcteur PI avec des amplificateurs opérationnels

### 2.2. Calcul de la fonction de transfert globale

La fonction de transfert globale du système s’exprime comme suit :

H(s) = Vs(s)
Ve(s)

=

Va(s)
Ve(s)

·

Vs(s)
Va(s)

= H1(s) · H2(s)

Dans cette configuration, on suppose que les amplificateurs opérationnels sont idéaux, ce qui implique ε = 0 =⇒ V

+ = V

−. Le dimensionnement des correcteurs s’effectue en séparant les deux fonctions de transfert.

### 2.3. Dimensionnement du correcteur H1(s)

Pour le premier étage du correcteur, on introduit une impédance équivalente :

Zeq(s) = R +

1
C · s

=

RC · s + 1
sC
En appliquant le théorème de Millman à l’entrée négative du premier AOP, on obtient :

V

− =

Ve
R +

Va
Zeq(s)
1
R +

1
Zeq(s)
Puisque V

− = 0V , le numérateur doit être nul. On a donc :

Ve
R

+

Va
Zeq(s)

= 0

En réarrangeant, on obtient : Va
Zeq(s)

= −

Ve
R

Va = −

Zeq(s)
R

Ve

Et donc :
H1(s) = Va(s)
Ve(s)

= −

Zeq(s)
R

= −

RC·s+1
C·s
R

= −

RC · s + 1
RC · s

### 2.4. Dimensionnement du correcteur H2(s)

On applique le théorème de Millman au nœud V

− du second AOP :

V

− =

Va(s)
R1

+

Vs(s)
R2
1
R1

+

1
R2
Puisque V

− = 0V (masse virtuelle), le numérateur doit être nul :

Va(s)
R1

+

Vs(s)
R2

= 0

On isole Vs(s) pour trouver la fonction de transfert :

Vs(s)
R2

= −

Va(s)
R1

=⇒ Vs(s) = −Va(s) ·

R2
R1

La fonction de transfert du second étage s’exprime alors par :

H2(s) = Vs(s)
Va(s)

= −

R2
R1

### 2.5. Fonction de transfert globale et identification

On calcule la fonction de transfert globale H(s) en multipliant H1(s) et H2(s) :

H(s) = H1(s) · H2(s) =
−

RC · s + 1
RC · s
·
−

R2
R1

Les deux signes négatifs s’annulent. On réarrange les termes :

H(s) = R2
R1

·

RC · s + 1
RC · s

On sépare la fraction pour faire apparaître la forme canonique :

H(s) = R2
R1

·

RC · s
RC · s

+

1
RC · s
=

R2
R1
1 +

1
RC · s

La forme de Laplace standard (ou canonique) pour un correcteur PI est :

HP I (s) = Kp

1 +

1
Tis

### 2.6. Identification des paramètres

Par identification directe avec la structure PI souhaitée, on obtient les relations suivantes :

Kp =

R2
R1
Ti = RC

### 2.7. Choix des composants

À partir des paramètres théoriques des correcteurs PI déterminés précédemment, nous procédons à l’identification des composants passifs normalisés (résistances et condensateurs) dont les valeurs commerciales permettent d’approcher au mieux les caractéristiques désirées. Les résultats de cette identification sont présentés ci-après :

Correcteur PI pour l’asservissement en courant :
Les paramètres du correcteur sont : Kp = 5,053 et Ti = Kp/Ki = 1,39 × 10⁻⁴ s.
Par identification avec les relations Kp = R2/R1 et Ti = RC, nous obtenons :

R · C = 10 × 10 × 10⁻⁶ = 1 × 10⁻⁴ ≈ Ti et

R2
R1

=

8,2 × 10³
1,5 × 10³

= 5,467 ≈ Kp

Composant Valeur

R | 10 Ω
C | 10 µF
R1 | 1,5 kΩ
R2 | 8,2 kΩ

Correcteur PI pour l’asservissement en vitesse :
Les paramètres du correcteur sont : Kp = 6,8 et Ti = Kp/Ki = 13,45 ms. Par identification avec les relations Kp = R2/R1 et Ti = RC, nous obtenons :

R · C = 3,3 × 10³ × 3,9 × 10⁻⁶ = 0,0129 ≈ Ti et

R2
R1

=

6,8 × 10³
1 × 10³

= 6,8 ≈ Kp

Composant Valeur

R | 3,3 kΩ
C | 3,9 µF
R1 | 1 kΩ
R2 | 6,8 kΩ

### 3. Dimensionnement des autres composants de la chaîne d’asservis-

sement

Après avoir dimensionné les correcteurs PI et les soustracteurs, il est nécessaire de compléter la chaîne d’asservissement avec les autres éléments essentiels : le limiteur de tension (écrêteur) pour protéger le système, et les capteurs de vitesse (dynamo tachymétrique et codeur incrémental) qui nécessitent des circuits de conditionnement pour adapter leurs signaux.

### 3.1. Limiteur de tension (écrêteur)

Pour réaliser le limiteur de tension que nous avions mis en place en simulation, nous utilisons un montage écrêteur à diodes et ponts diviseurs de tension.

Principe de fonctionnement

Si on étudie uniquement la partie supérieure de ce montage, on remarque qu’il se comporte comme un redresseur à simple alternance. En effet, si la tension d’entrée du signal dépasse la somme de la tension de conduction de la diode et de la tension en sortie du pont diviseur de tension, alors la diode conduit. Soit :

Ve > Vs+ = VD + VP

= 0,6 + 15 ×

18k
1k + 18k
≈ 14,8 V

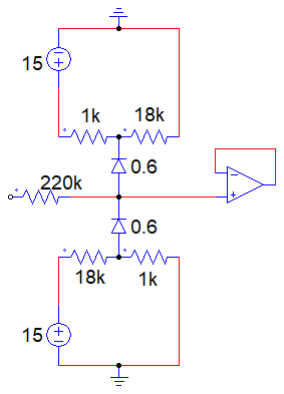
[picture p54: figure]

Figure 5.3 – Montage limiteur de tension à diodes

Dans ces conditions, la diode conduit et limite la tension de sortie du montage à 14,8 V. C’est donc en changeant les valeurs des résistances du pont diviseur de tension que l’on obtient notre tension de seuil positive. La partie basse du montage effectue la même fonction mais en créant une limite basse que l’on fixe également avec le pont diviseur de tension. Dans notre cas, cette tension de seuil est de :
Vs− = −0,6 + 15 ×

1k
1k + 18k

≈ 0,19 V

Pour respecter le limiteur que l’on avait mis en simulation qui limitait la tension entre 0,2 V et 14,8 V.
L’amplificateur opérationnel en sortie du montage est simplement un suiveur qui joue le rôle d’adaptateur d’impédance. Le résultat final est donc un signal limité entre 0,2 V et 14,8 V comme le montre la figure ci-dessous.

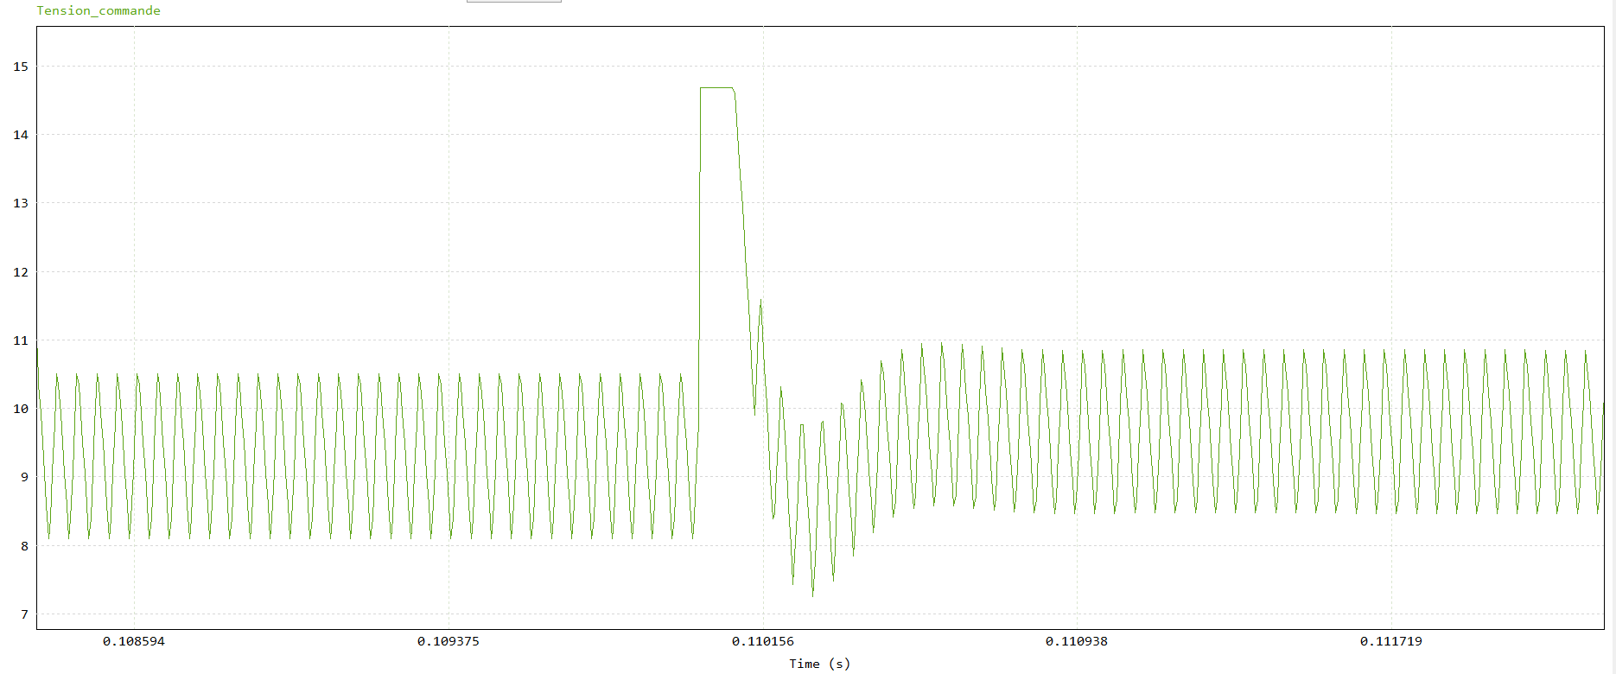
[picture p55: figure]

Figure 5.4 – Visualisation de la tension de commande limitée sur PSIM

### 3.2. Capteur dynamo tachymétrique

La dynamo tachymétrique est un capteur analogique qui convertit directement la vitesse de rotation en une tension proportionnelle. Ce composant nécessite un conditionnement de signal pour adapter sa sortie aux niveaux requis par notre système d’asservissement.

Caractéristiques du capteur

Le capteur dynamo tachymétrique utilisé possède une constante de conversion Ktachy = 6×10⁻³ V/(rad/s). Cette valeur indique la tension générée par le capteur pour une vitesse de rotation donnée.

Conditionnement du signal

Sur PSIM, nous modélisons le capteur en appliquant le facteur 6/1000 à la vitesse mesurée pour représenter la dynamo tachymétrique réelle. Pour adapter la tension de sortie aux niveaux requis par le système, nous ajoutons un pont diviseur de tension qui divise par deux la tension de sortie.

- Figure 5.5: Modélisation_Intermédiaire_VALIDE/06_Choix_Des_Composants/Tachy/Choix_composants_Tachy_VALIDE_08_11_25.psimsch | 31/36

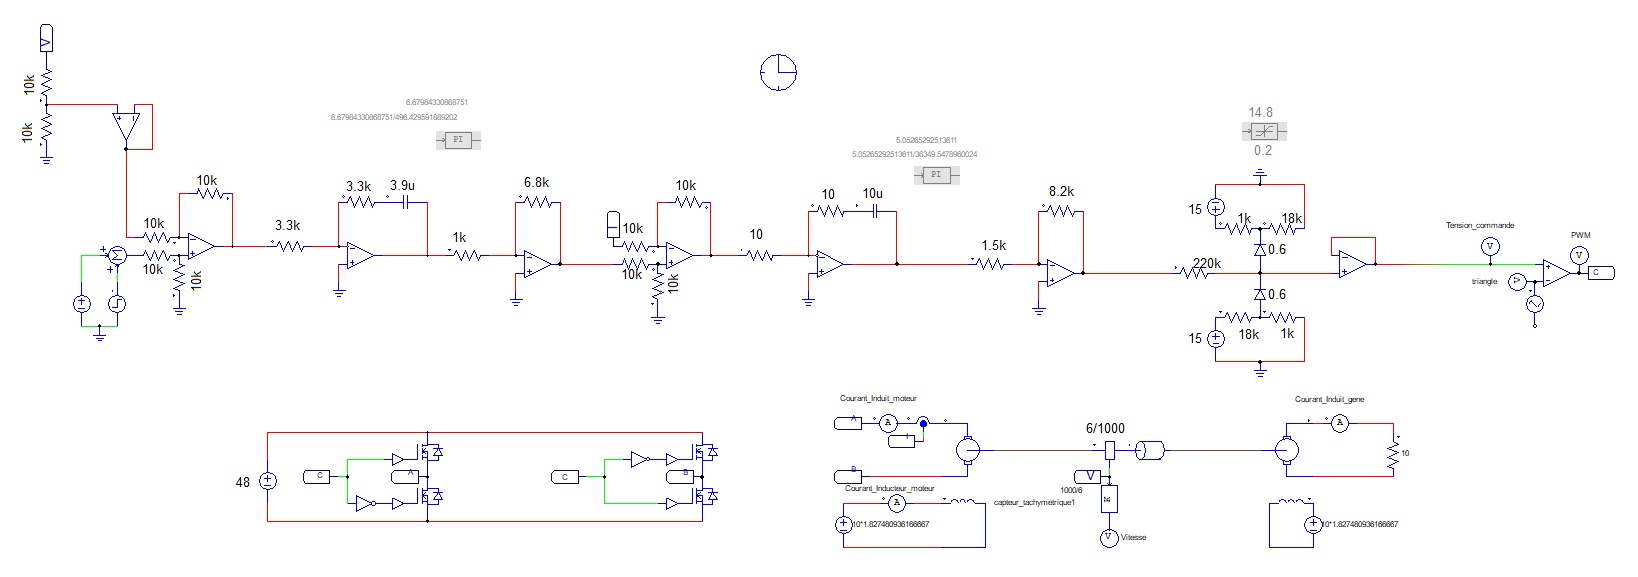
[picture p56: figure]

Figure 5.5 – Schéma de modélisation du capteur tachymétrique sur PSIM

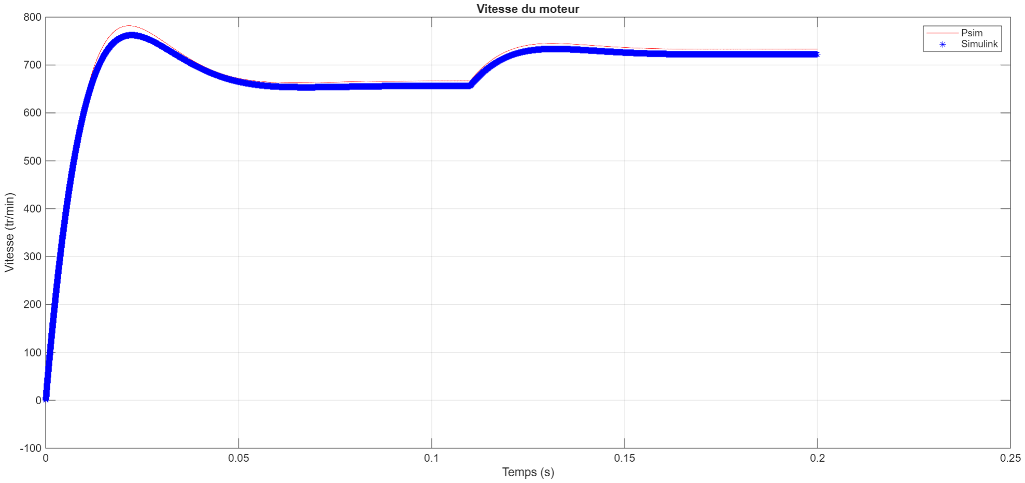
[picture p57: figure]

Figure 5.6 – Comparaison entre Simulink et PSIM pour le capteur tachymétrique et les choix de composants

La figure 5.6 illustre la comparaison entre les modélisations Simulink avec correcteurs PI idéaux et PSIM avec composants réels (résistances et condensateurs). On observe une excellente concordance entre les deux courbes, sachant que nous avons à nouveau appliqué un facteur 0,99 aux données Simulink. Le graphe confirme que les choix de composants permettent de reproduire les performances théoriques. Les performances dynamiques restent conformes aux spécifications, démontrant que le passage aux composants réels n’altère pas significativement le comportement de l’asservissement.

- Figure 5.6: Modélisation_Intermédiaire_VALIDE/06_Choix_Des_Composants/Tachy/Comparaison_Composants_Tachy_VALIDE_08_11_2025.m | 32/36

### 3.3. Codeur incrémental

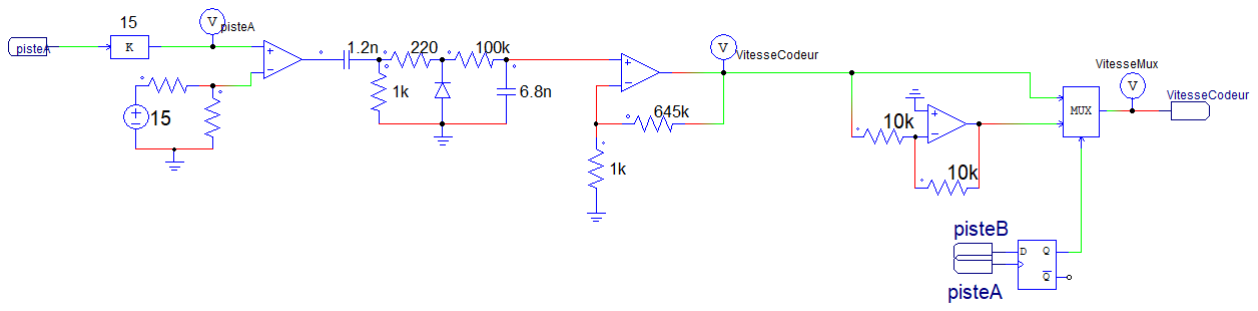
[picture p58: figure]

Figure 5.7 – Schéma de modélisation du codeur incrémental sur PSIM

Le codeur simulé sous PSIM délivre une tension comprise entre 0 et 1 V, alors que le codeur réel fournit un signal de 0 à 15 V. Pour corriger cette différence d’échelle et obtenir une simulation représentative, un gain de 15 a été ajouté à l’entrée du bloc de calcul de la vitesse de rotation.

Circuit de conversion impulsions/tension

Pour utiliser le codeur incrémental dans notre système d’asservissement analogique, il est nécessaire de convertir les impulsions numériques en une tension analogique proportionnelle à la vitesse. Cette conversion peut être réalisée par un circuit fréquence-tension (convertisseur F/V). Le schéma complet de l’asservissement en vitesse avec codeur incrémental devient ainsi :

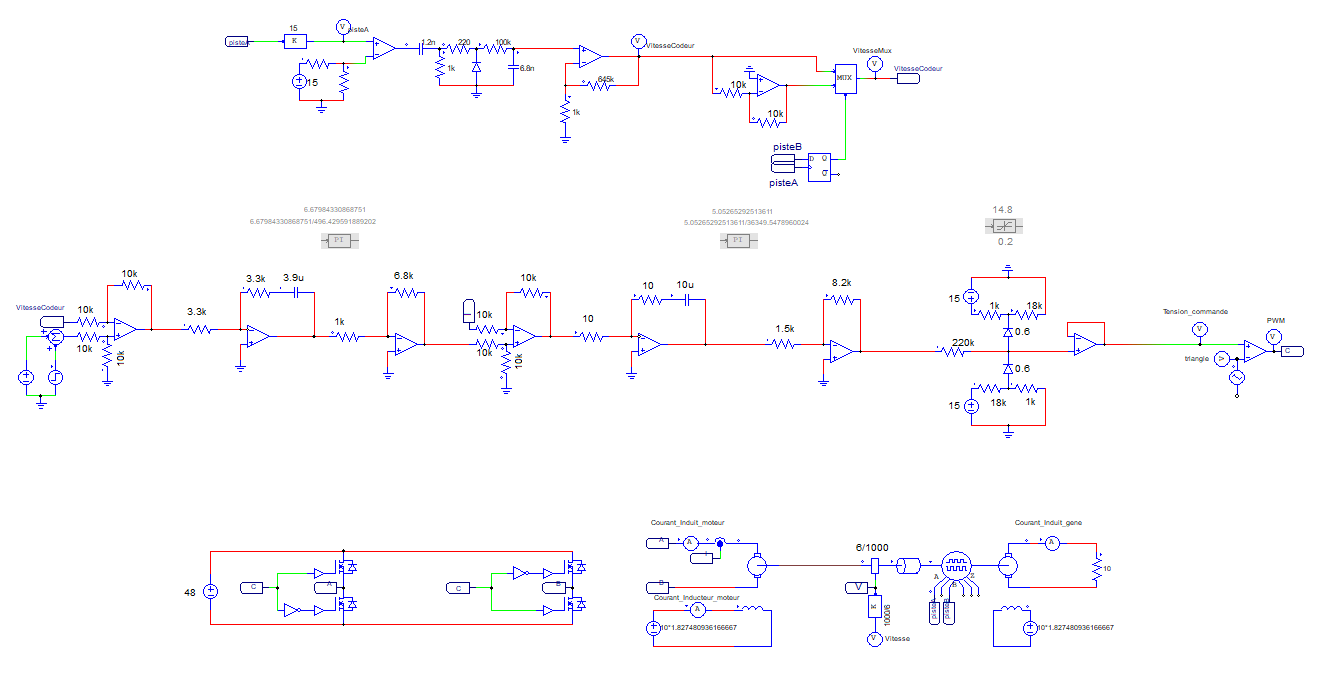
[picture p59: figure]

Figure 5.8 – Schéma complet de l’asservissement en vitesse avec codeur incrémental

- Figure 5.7: Modélisation_Intermédiaire_VALIDE/06_Choix_Des_Composants/Codeur/Choix_Composants_Codeur_Incremental_VALIDE_08_11_25.psimsch
- Figure 5.8: Modélisation_Intermédiaire_VALIDE/06_Choix_Des_Composants/Codeur/Choix_Composants_Codeur_Incremental_VALIDE_08_11_25.psimsch

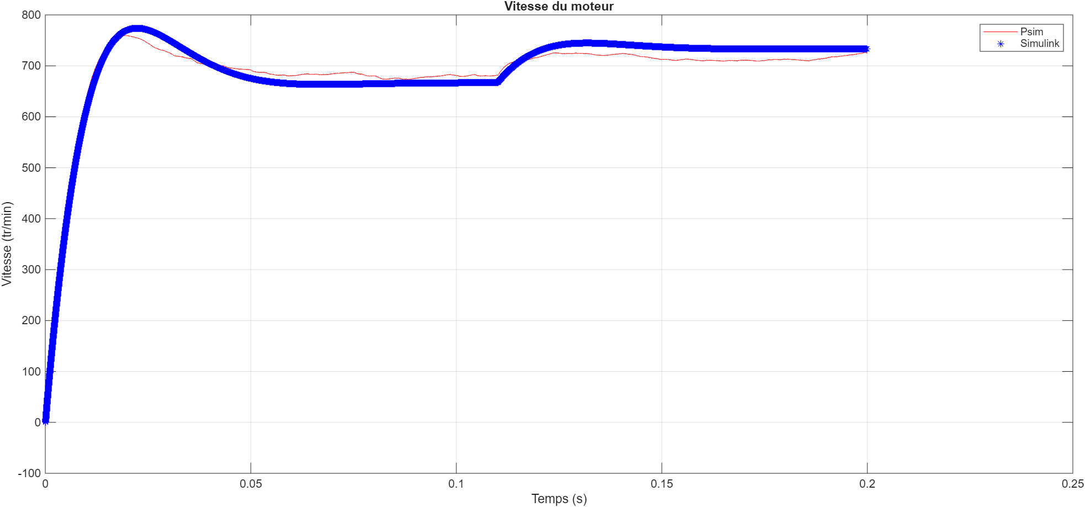
[picture p60: figure]

Figure 5.9 – Comparaison entre Simulink et PSIM pour le codeur incrémental et les choix de composants

La figure 5.9 illustre la comparaison entre les modélisations Simulink avec correcteurs PI idéaux et PSIM avec composants réels (résistances et condensateurs). On observe une bonne concordance entre les deux courbes, confirmant que les choix de composants permettent de reproduire les performances théoriques. Les oscillations caractéristiques du codeur incrémental sont présentes sur la simulation PSIM, validant la cohérence de la modélisation du capteur numérique. Les performances dynamiques restent conformes aux spécifications, démontrant que le passage aux composants réels n’altère pas significativement le comportement de l’asservissement.

- Figure 5.9: Modélisation_Intermédiaire_VALIDE/06_Choix_Des_Composants/Codeur/Comparaison_Composants_Codeur_Incremental_VALIDE_08_11_25.m | 34/36

# Conclusion

Ce projet d’asservissement d’une machine à courant continu a permis d’acquérir une vision complète de la chaîne de régulation, depuis la modélisation théorique jusqu’au dimensionnement des composants électroniques réels. À ce stade du projet, il convient de dresser un bilan des travaux réalisés et d’identifier les tâches qui restent à accomplir pour finaliser le système.

Travaux restant à réaliser

Malgré les avancées significatives effectuées en simulation et en dimensionnement, plusieurs étapes essentielles restent à compléter avant la finalisation du projet :

1. Réalisation du circuit imprimé (PCB) : La conception et la fabrication de la carte électronique permettant d’implémenter physiquement l’ensemble des circuits dimensionnés (correcteurs PI, soustracteurs, limiteur de tension, conditionnement des capteurs).
2. Assemblage et câblage du système : Le montage des composants sur le PCB, le raccordement du moteur, des capteurs (dynamo tachymétrique et codeur incrémental) et de l’alimentation de puissance.
3. Tests et validation expérimentale : La mise en service progressive du système réel, comprenant :
- La vérification du bon fonctionnement des correcteurs PI analogiques
- Les tests de l’asservissement en courant puis en vitesse
- La comparaison des performances mesurées avec les résultats de simulation
4. Réglage et optimisation : L’ajustement fin des paramètres si nécessaire pour compenser les écarts entre le modèle théorique et la réalité (tolérances des composants, pertes non modélisées, perturbations électromagnétiques).
5. Caractérisation complète : L’évaluation des performances dans différentes conditions de fonctionnement (variations de charge, changements de consigne, robustesse face aux perturbations).

Bilan et perspectives

Les travaux menés ont établi des fondations solides pour la réalisation pratique du système. La modélisation mathématique de la MCC a été développée et validée sur MATLAB/Simulink et PSIM, incluant la machine à vide, avec charge mécanique et hacheur quatre quadrants. Deux boucles de régulation en cascade ont été conçues et optimisées, respectant les spécifications du cahier des charges en termes de temps de réponse et de dépassement. L’étude comparative de deux capteurs (dynamo tachymétrique et codeur incrémental) a validé la flexibilité du système, et le dimensionnement complet des circuits analogiques réels a été réalisé avec succès.

Ce projet a permis de développer une méthodologie rigoureuse allant de la modélisation théorique à la réalisation pratique, tout en maîtrisant les outils de simulation et en validant systématiquement chaque étape par comparaison croisée. La réalisation expérimentale du système constituera l’aboutissement de ces travaux, permettant de confronter les prédictions théoriques à la réalité. Les fondations méthodologiques acquises constitueront des atouts précieux pour les développements futurs et l’adaptation du système à d’autres applications industrielles.

# Liste des figures et chemins d’accès

Cette section recense l’ensemble des figures présentes dans ce rapport ainsi que le chemin d’accès aux fichiers de simulation correspondants.

Figure 3.1: Modélisation_Intermédiaire_VALIDE/00_Moteur_a_Vide/Moteur_Seul_VALIDE_12_09_2025.slx

Figure 3.2: Modélisation_Intermédiaire_VALIDE/00_Moteur_a_Vide/Moteur_Seul_VALIDE_12_09_2025.slx

Figure 3.3: Modélisation_Intermédiaire_VALIDE/00_Moteur_a_Vide/Moteur_Seul_VALIDE_12_09_2025.psimsch

Figure 3.4: Modélisation_Intermédiaire_VALIDE/00_Moteur_a_Vide/Comparaison_Moteur_Seul_VALIDE_12_09_2025.m

Figure 3.5: Modélisation_Intermédiaire_VALIDE/01_Moteur_Charge_Frottement/Moteur_Charge_Frottement_VALIDE_03_11_2025.slx

Figure 3.6: Modélisation_Intermédiaire_VALIDE/01_Moteur_Charge_Frottement/Moteur_Charge_Frottement_VALIDE_03_11_2025.psimsch

Figure 3.7: Modélisation_Intermédiaire_VALIDE/01_Moteur_Charge_Frottement/Comparaison_Courant_Moteur_Charge_Frottement_VALIDE_03_11_2025.m

Figure 3.8: Modélisation_Intermédiaire_VALIDE/02_Moteur_Hacheur/Moteur_Hacheur_VALIDE_03_11_2025.psimsch

Figure 3.10: Modélisation_Intermédiaire_VALIDE/02_Moteur_Hacheur/Moteur_Hacheur_VALIDE_03_11_2025.slx

Figure 3.11: Modélisation_Intermédiaire_VALIDE/02_Moteur_Hacheur/Comparaison_Courant_Moteur_Hacheur_VALIDE_03_11_2025.m

Figure 4.1: Modélisation_Intermédiaire_VALIDE/03_BF_Courant/BF_Courant_VALIDE_06_11_2025.slx

Figure 4.2: Modélisation_Intermédiaire_VALIDE/03_BF_Courant/BF_Courant_VALIDE_06_11_2025.psimsch

Figure 4.3: Modélisation_Intermédiaire_VALIDE/03_BF_Courant/Comparaison_Asservissement_Courant_VALIDE_06_11_2025.m

Figure 4.4: Modélisation_Intermédiaire_VALIDE/04_BF_Courant_Vitesse/BO_Vitesse/BO_Vitesse_VALIDE_06_11_2025.slx

Figure 4.5: Modélisation_Intermédiaire_VALIDE/04_BF_Courant_Vitesse/BO_Vitesse/BO_Vitesse_VALIDE_06_11_2025.slx

Figure 4.6: Modélisation_Intermédiaire_VALIDE/04_BF_Courant_Vitesse/BF_Vitesse/BF_Courant_Vitesse_VALIDE_06_11_2025.slx

Figure 4.7: Modélisation_Intermédiaire_VALIDE/04_BF_Courant_Vitesse/BF_Vitesse/BF_Asservissement_Courant_Vitesse_VALIDE_06_11_2025.psimsch

Figure 4.8: Modélisation_Intermédiaire_VALIDE/04_BF_Courant_Vitesse/Comparaison_BF_Vitesse/Comparaison_Asservissement_Courant_Vitesse_VALIDE_06_11_2025.m

Figure 4.10: Modélisation_Intermédiaire_VALIDE/05_Codeur_Incrémentale/BF_Vitesse_Codeur_Incrementale_VALIDE_08_11_25.psimsch

Figure 4.11: Modélisation_Intermédiaire_VALIDE/05_Codeur_Incrémentale/BF_Vitesse_Codeur_Incrementale_VALIDE_08_11_25.psimsch

Figure 4.12: Modélisation_Intermédiaire_VALIDE/05_Codeur_Incrémentale/Comparaison_Vitesse_Codeur_Incremental_VALIDE_08_11_2025.m

Figure 5.5: Modélisation_Intermédiaire_VALIDE/06_Choix_Des_Composants/Tachy/Choix_composants_Tachy_VALIDE_08_11_25.psimsch

Figure 5.6: Modélisation_Intermédiaire_VALIDE/06_Choix_Des_Composants/Tachy/Comparaison_Composants_Tachy_VALIDE_08_11_2025.m

Figure 5.7: Modélisation_Intermédiaire_VALIDE/06_Choix_Des_Composants/Codeur/Choix_Composants_Codeur_Incremental_VALIDE_08_11_25.psimsch

Figure 5.8: Modélisation_Intermédiaire_VALIDE/06_Choix_Des_Composants/Codeur/Choix_Composants_Codeur_Incremental_VALIDE_08_11_25.psimsch

Figure 5.9: Modélisation_Intermédiaire_VALIDE/06_Choix_Des_Composants/Codeur/Comparaison_Composants_Codeur_Incremental_VALIDE_08_11_25.m
