EvanTrenchant/ProjetGES7/Rapport/main.tex

\documentclass[12pt, a4paper]{report}

% --- Inclusion des configurations ---
\input{config/project-settings} % Variables du projet
\input{config/packages}        % Packages et couleurs
\input{config/layout}          % Mise en page et styles
\input{config/figure-paths}    % Gestion automatique des chemins de figures
\input{config/figure-paths-definitions} % Définitions des chemins des figures

% =====================================
% DOCUMENT PRINCIPAL
% =====================================

\begin{document}

% --- Page de garde ---
\maketitlepage

% --- Démarrage de la numérotation à 2 (page de garde = page 1) ---
\startpagenumbering

% --- Introduction et objectifs ---
\input{contenu/introduction.tex}

\newpage

% --- Sommaires ---
\tableofcontents
\newpage

% --- Cahier des charges ---
\input{contenu/cdc.tex}

% --- Inclusion des chapitres/parties du rapport ---
\input{contenu/planification.tex}

% --- Modelisation et simulation du moteur et du hacheur ---
\input{contenu/modelisation_simulation_moteur_hacheur.tex}
\input{contenu/diagrammes.tex}
% --- Asservissement du moteur ---
\input{contenu/asservissement_moteur.tex}

\input{contenu/dimensionnement_composants.tex}
\input{contenu/conception_pcb.tex}
\input{contenu/assemblage.tex}
\input{contenu/essais.tex}

% --- Conclusion ---
\input{contenu/conclusion.tex}
\input{contenu/liste_figures_chemins.tex}
\end{document}
