EvanTrenchant/ProjetGES7/Rapport/config/figure-paths-definitions.tex

% =====================================
% DÉFINITION DES CHEMINS DES FIGURES
% =====================================
% 
% Ce fichier centralise tous les chemins d'accès aux fichiers de simulation
% correspondant aux figures du rapport.
%
% Usage: \figpath{label_de_la_figure}{chemin/vers/fichier}
%
% Exemple:
% \figpath{fig:mon_schema}{Modelisation/01_12_09_2025/schema.slx}
%
% Les chemins seront automatiquement affichés dans la section
% "Liste des figures et chemins d'accès"
% =====================================

% =====================================
% CHAPITRE 1 : MODÉLISATION ET SIMULATION
% =====================================

% --- Section 1.1 : Moteur à vide ---

% =====================================
% STATISTIQUES
% =====================================
% Total : 27 figures avec chemins définis
% - Fichiers Simulink (.slx) : 9
% - Fichiers PSIM (.psimsch) : 12
% - Scripts MATLAB (.m) : 6
% =====================================
