EvanTrenchant/ProjetGES7/Rapport/config/layout.tex

% =====================================
% CONFIGURATION DE LA MISE EN PAGE
% =====================================

% --- Format de date DD/MM/YYYY ---
\newdateformat{ddmmyyyy}{\THEDAY/\THEMONTH/\THEYEAR}
\ddmmyyyy

% --- Personnalisation du format des chapitres ---
\titleformat{\chapter}
    {\normalfont\huge\bfseries}     % Format du titre
    {\thechapter~-~}                % Format du numéro (X - )
    {0pt}                           % Séparation entre numéro et titre
  {}                              % Code avant le titre
\titlespacing*{\chapter}{0pt}{-20pt}{20pt} % Ajustement des espaces : pas d'espace négatif avant le chapitre

% --- Configuration des en-têtes et pieds de page ---
\pagestyle{fancy}
\fancyhf{} % Nettoie les champs

% Configuration de l'en-tête
\fancyhead[L]{}
\fancyhead[C]{\authorsInline}
\fancyhead[R]{\ddmmyyyy\today}

% Configuration du pied de page
\fancyfootoffset{0pt}
\fancyfoot[L]{\scriptsize\figfooter\clearfigfooter}
\fancyfoot[C]{}
\fancyfoot[R]{%
  \begin{picture}(0,0)
  % Réduction de l'image (scale passé de 1 à 0.8)
  \put(-13,-10){%
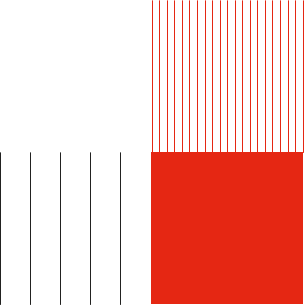
[picture p81: Rapport/images/foot-logo.png]
    % 
  }%
  % Ajout de \footnotesize pour réduire le texte
  \put(9.7,0){%
    \begin{minipage}{12mm}
      \centering
      \color{BLANC}{\footnotesize\thepage/\pageref*{LastPage}}% 
    \end{minipage}%
  }%
\end{picture}%
}

% Configuration des lignes de séparation
\renewcommand{\headrulewidth}{0.4pt}
\renewcommand{\footrulewidth}{0pt}

\addtolength{\topmargin}{-5pt}

% --- Configuration du style plain pour table des matières et chapitres ---
\fancypagestyle{plain}{%
  \fancyhf{} % Nettoie les champs
  % En-tête identique au style fancy
  \fancyhead[L]{}
  \fancyhead[C]{\authorsInline}
  \fancyhead[R]{\ddmmyyyy\today}
  % Pied de page identique au style fancy
  \fancyfootoffset{0pt}
  \fancyfoot[L]{\scriptsize\figfooter\clearfigfooter}
  \fancyfoot[C]{}
  \fancyfoot[R]{%
    \begin{picture}(0,0)
  % Réduction de l'image (scale passé de 1 à 0.8)
  \put(-13,-10){%
    % 
  }%
  % Ajout de \footnotesize pour réduire le texte
  \put(9.7,0){%
    \begin{minipage}{12mm}
      \centering
      \color{BLANC}{\footnotesize\thepage/\pageref*{LastPage}}% 
    \end{minipage}%
  }%
\end{picture}%
  }
  \renewcommand{\headrulewidth}{0.4pt}
  \renewcommand{\footrulewidth}{0pt}
}

% --- Paramètres généraux de mise en page ---
\setlength{\parindent}{0pt}  % Suppression de l'indentation automatique des paragraphes

% --- Configuration de la numérotation des pages ---
% Commande pour démarrer la numérotation à 2 (page de garde = page 1 non numérotée)
\newcommand{\startpagenumbering}{%
    \setcounter{page}{2}%
    \pagestyle{fancy}%
}

\titleformat{\section}{\normalfont\large\bfseries}{\thesection}{1em}{}
\titleformat{\subsection}{\normalfont\normalsize\bfseries}{\thesubsection}{1em}{}

% Numérotation des sections
\renewcommand\thesection{\arabic{section}.}
\renewcommand\thesubsection{\thesection\arabic{subsection}.}
