EvanTrenchant/ProjetGES7/Rapport/images/background.pdf

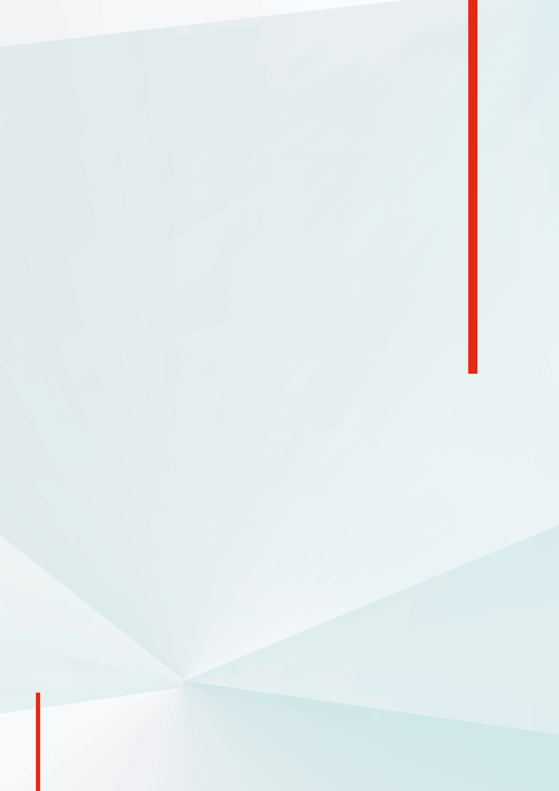
[picture p82: page 1]
