EvanTrenchant/ProjetGES7/Rapport/images/Image PCB/VGA_SCHEMA.pdf

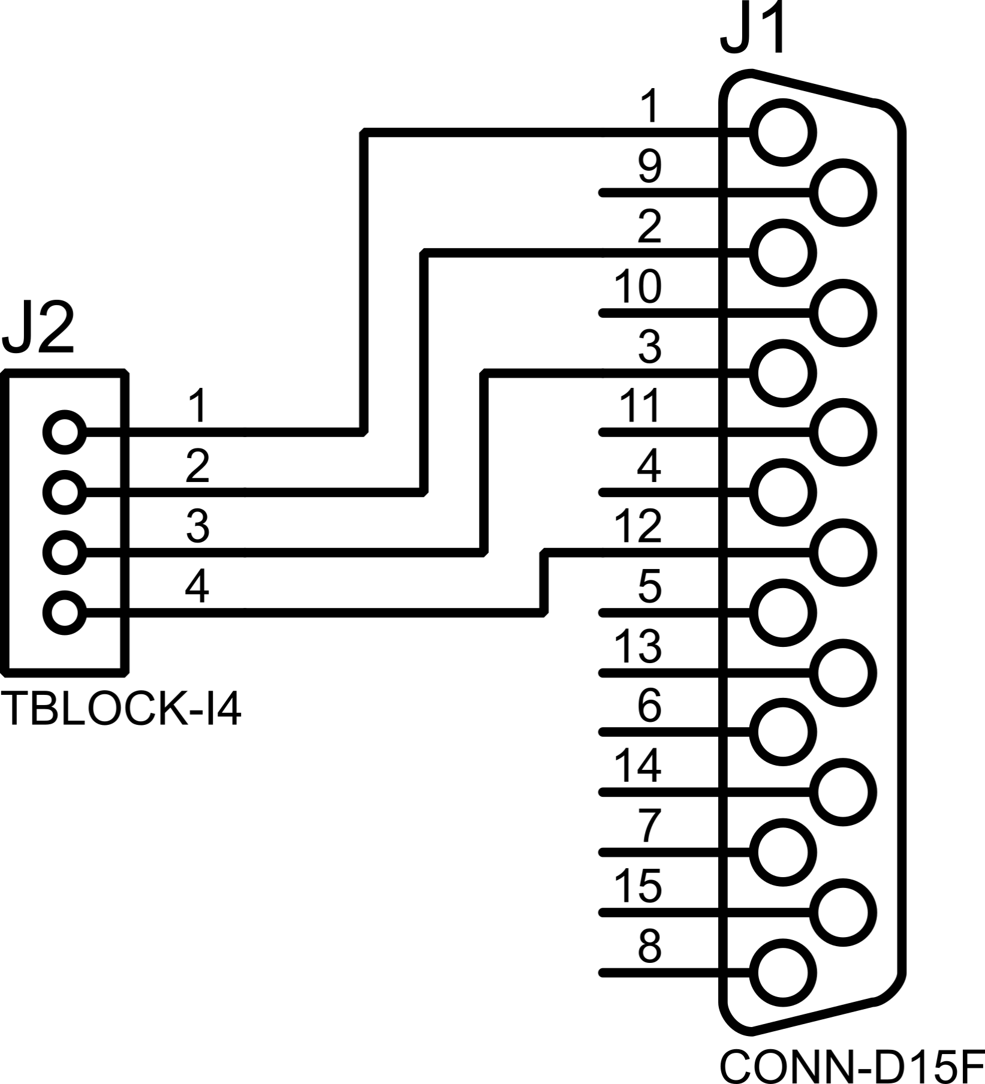
[picture p83: page 1]
