EvanTrenchant/ProjetGES7/Archives/2024-2025/03_moteur_hacheur_0210/rapport.txt

Petite différence dans les vitesses dû à la conso des MOSFET
