EvanTrenchant/ProjetGES7/Archives/2024-2025/14janv_Presentation_ProjetS7_Gass_Guerchpn.pdf

# Projet GES7

### ASSERVISSEMENT D’UNE MACHINE A COURANT CONTINU EN COURANT ET EN VITESSE

## Siméon Gass – Mickael Guerchon

GE4

# Cahier des charges

- Dépassement en vitesse entre 10 et 20%
- Limitation en courant à 5 ampères
- Asservissement en vitesse par un capteur tachymétrique ou un codeur incrémental
- 25 euros de budget

# Simulation

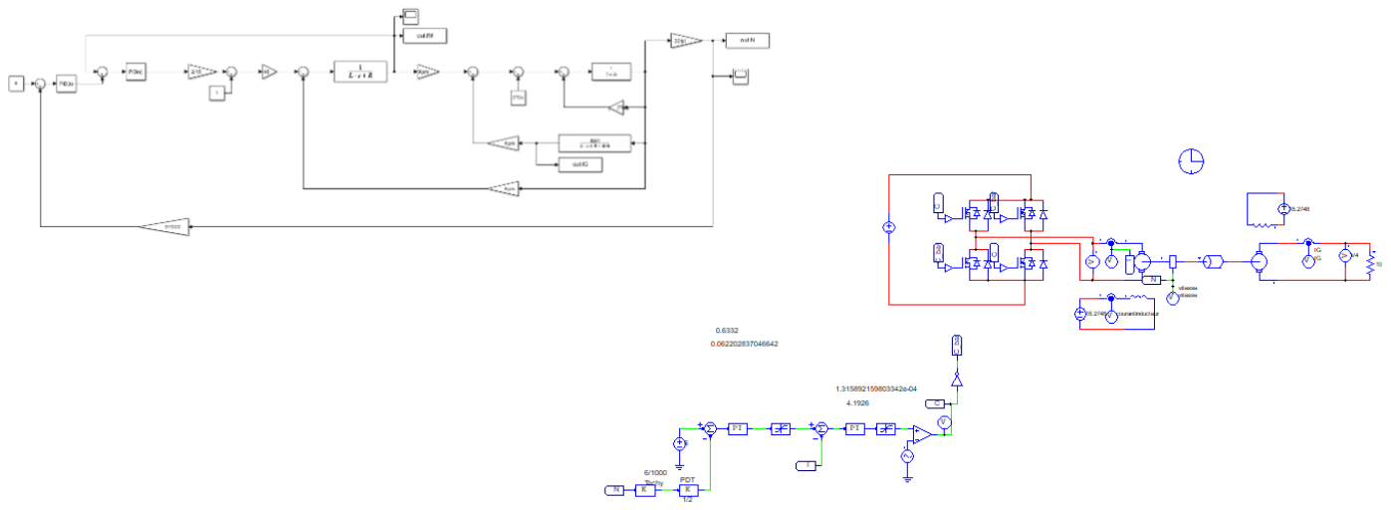
[picture p91: figure]

# Simulation avec composants réels

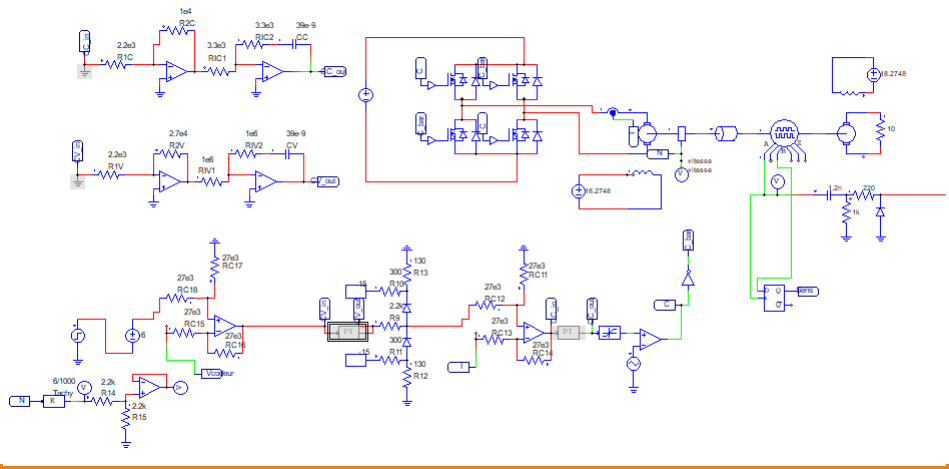
[picture p92: figure]
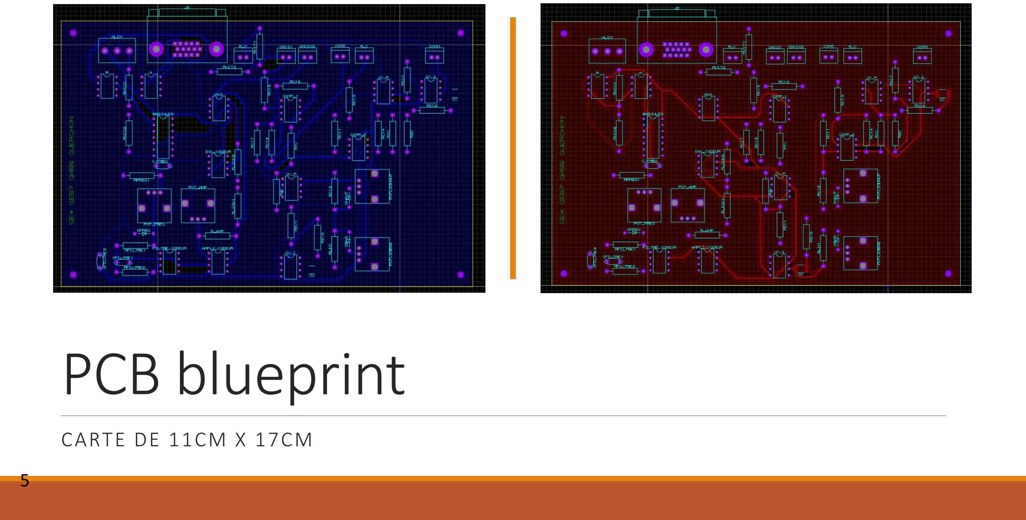
[picture p93: page 5]

# PCB blueprint

CARTE DE 11CM X 17CM

# Carte imprimée

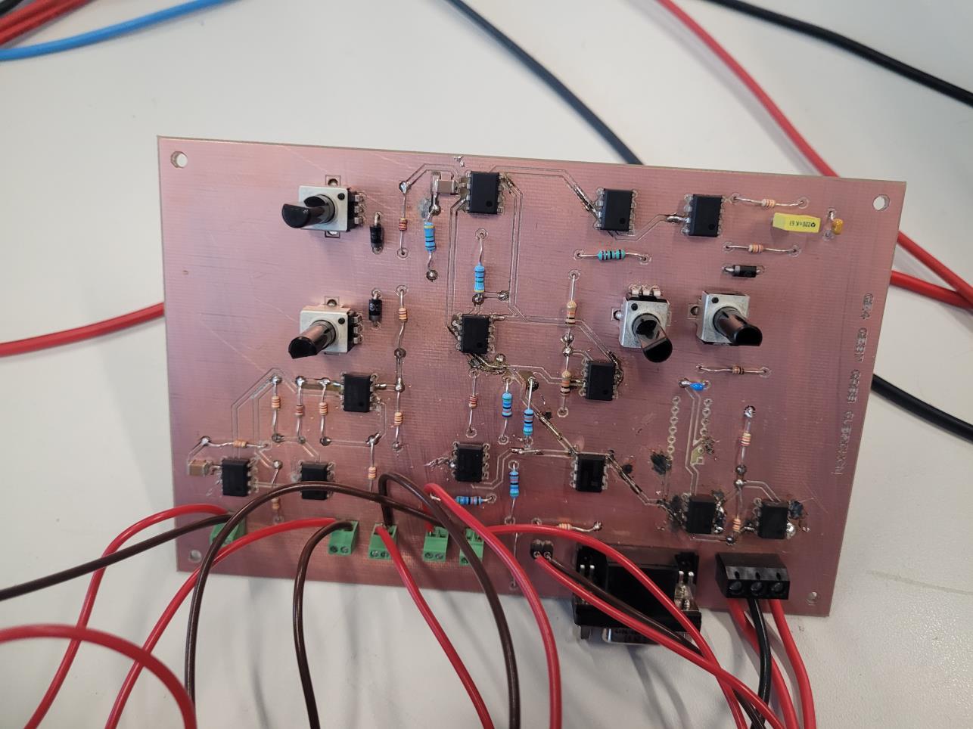
[picture p94: figure]

# Montage final

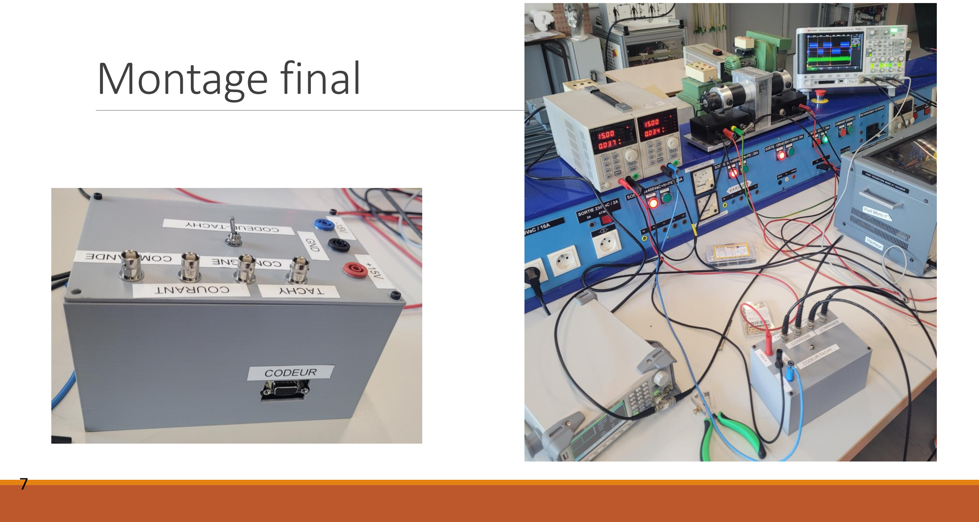
[picture p95: page 7]

# Résultats

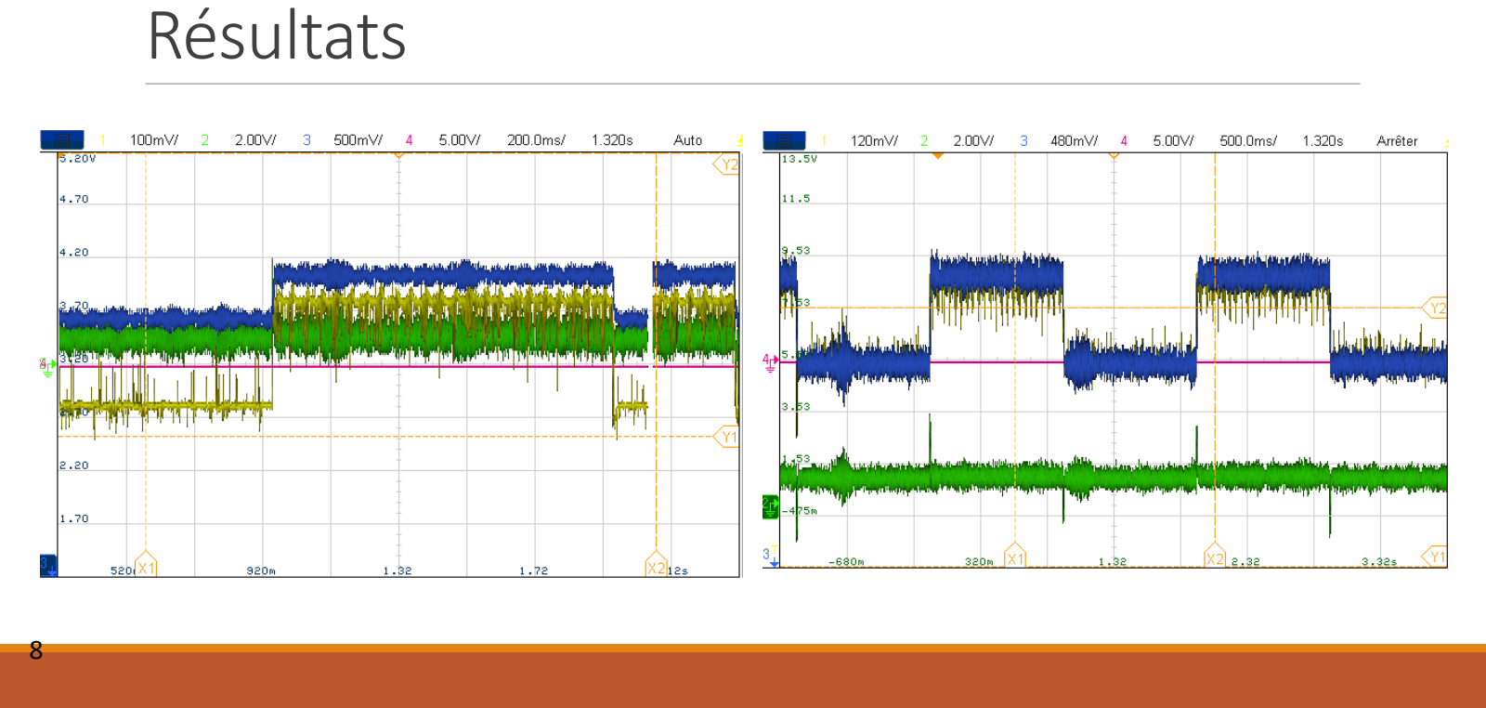
[picture p96: page 8]

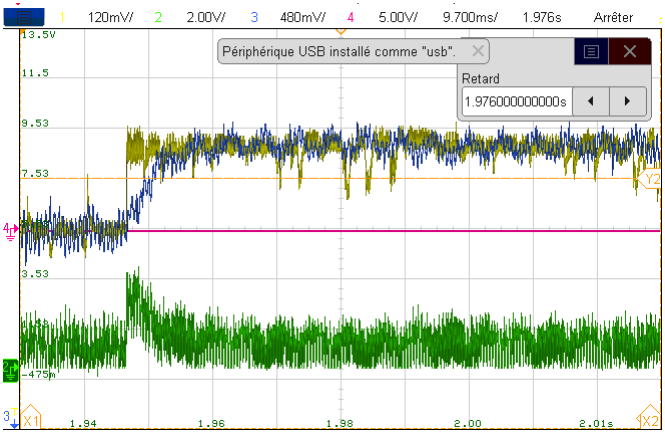
[picture p97: figure]

# Résultats

- Temps de réponse : environ 7,9 ms
- Pas de dépassement en vitesse
- Pic de courant à 3,7 ampères

# Comparaison avec simulation

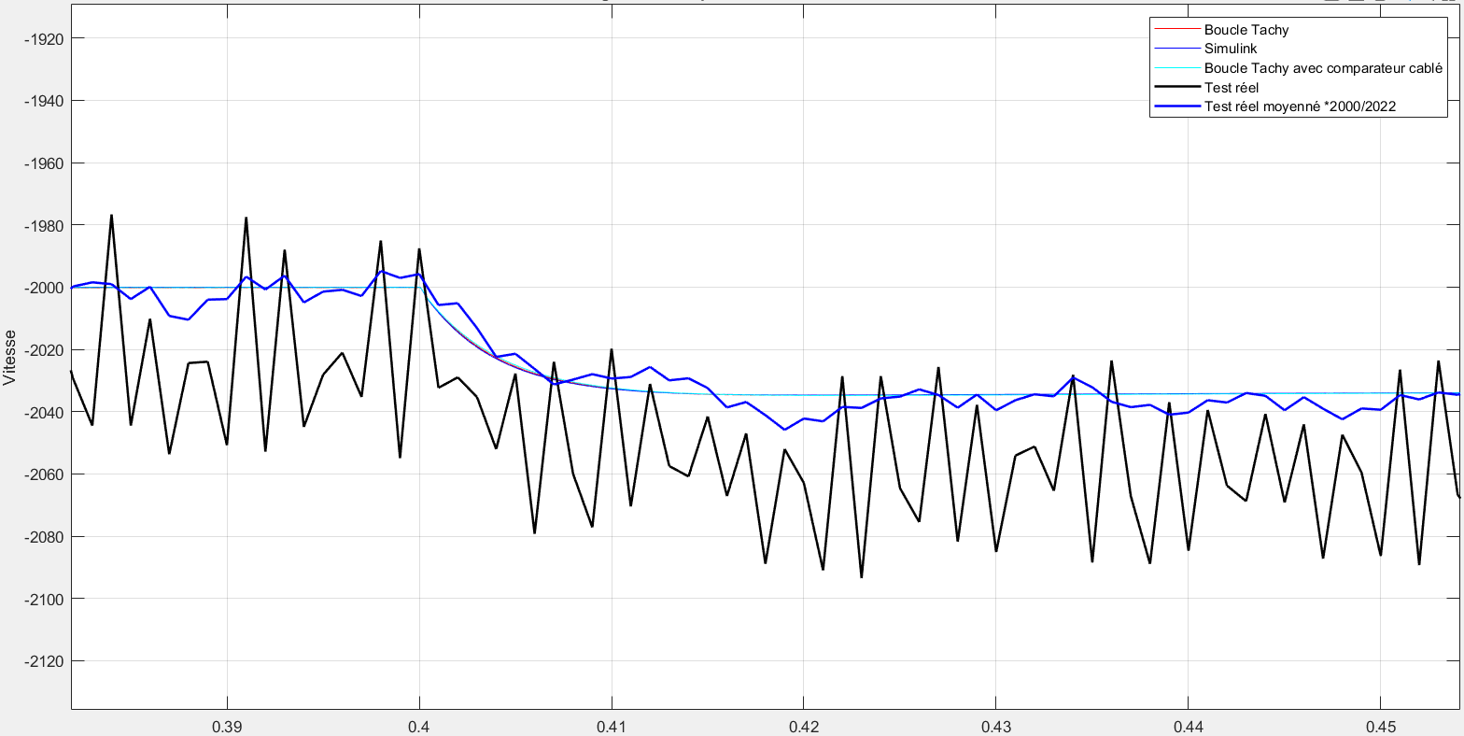
[picture p98: figure]

# Avez-vous des questions ?

Merci de nous avoir écouté
