EvanTrenchant/ProjetGES7/Archives/2024-2025/readme.txt

On a enlevé les fichiers de simu du OneDrive, pour éviter de prendre trop de place
je les ai tjrs sur mon pc a priori

-- Simeon Gass
