EvanTrenchant/ProjetGES7/Archives/2022-2023/Soutenance.pptx

## Asservissement d’une machine à courant continu (MCC)

Emma BARETY
David MARTINEZ
Iona GUTH

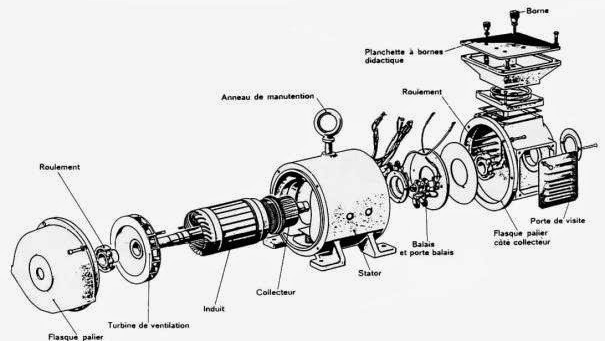
[picture p99: figure]

PROJET GE1:

## BUT DU PROJET:

- Comprendre les logiques de l’asservissement
- Appliquer la théorie des cours d’automatique 1 et 2
- Apprendre le fonctionnement détaillé le fonctionnement d’une MCC
- Travailler en groupe (par 3)

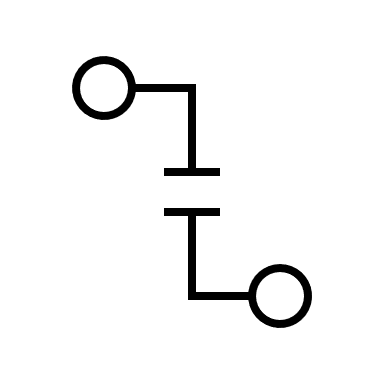
[picture p100: figure]
Déconnecté contour

Sample Footer Text

## CAHIER DES CHARGES

- L’asservissement en vitesse se fera par deux moyens différents : soit par un capteur tachymétrique soit par un codeur incrémental
- La vitesse maximale indiquée de 4800 tr/min ne doit pas être dépassée.
- La boucle d’asservissement du courant se fera grâce au capteur prévu à cet effet dans le module du hacheur.
- Le courant de saturation ne devra pas être supérieur 4,95 A
- Le dépassement en vitesse et en courant est limité entre 10 et 20%.
- Le temps de réponse doit être le plus faible possible.
- Le budget est de 25 euros par groupe.

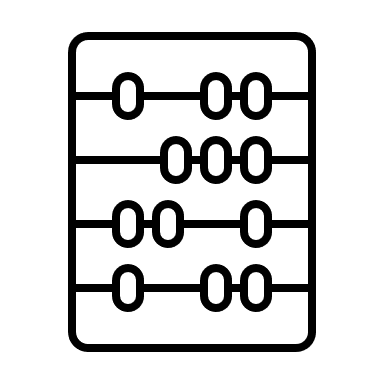
[picture p101: figure]
Boulier contour

## REPARTITIONS DES TACHES ET PLANIFICATION

- Organisation
- Les simulations
- Liste des composants
- Proteus et PCB
- La soudure
- Test et débogage
- Documentation

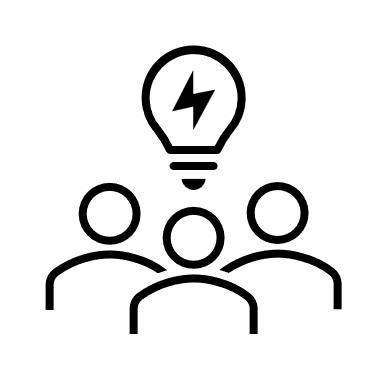
[picture p102: figure]
Brainstorming de groupe contour

## QU’EST CE QU’UNE MCC?

Formule du courant et de la vitesse d’une MCC sans pertes et sans charges:
I(s)=(U(s)−K_φ Ω(s))/(R+Ls)
Ω(s)=(K_φ ∙I(s))/(Js)

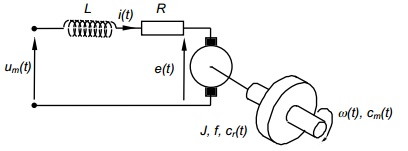
[picture p103: figure]

## Slide 6

Formule du courant et de la vitesse d’une MCC avec pertes et génératrice:
I(s)=(U(s)−K_φ Ω(s))/(R+Ls)
Ω(s)=(C_m +C_r)/(Js+f)

Formule du courant et de la vitesse d’une MCC avec pertes et génératrice:
I(s)=(U(s)−K_φ Ω(s))/(R+R_(ch) +Ls)
Ω(s)=(I(s) (R+R_(ch) +Ls))/(K_φ)

On a mis ces équations sous forme de schéma bloc.

## SIMULATION ET MODELISATION DE LA MCC

## SIMULATION ET MODELISATION DE LA MCC A VIDE

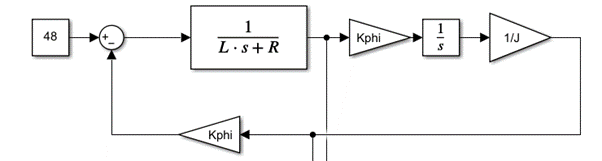
[picture p104: figure]
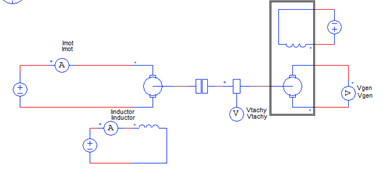
[picture p105: figure]
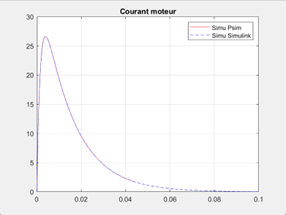
[picture p106: figure]
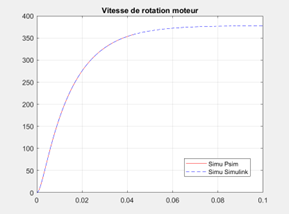
[picture p107: figure]

## SIMULATION ET MODELISATION DE LA MCC AVEC FROTTEMENTS

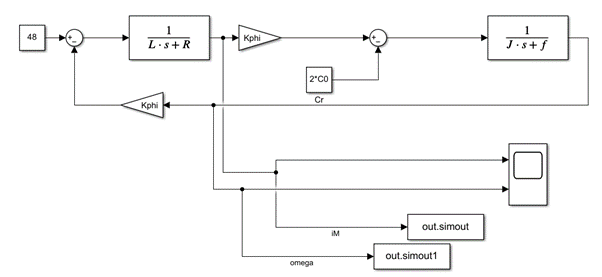
[picture p108: figure]
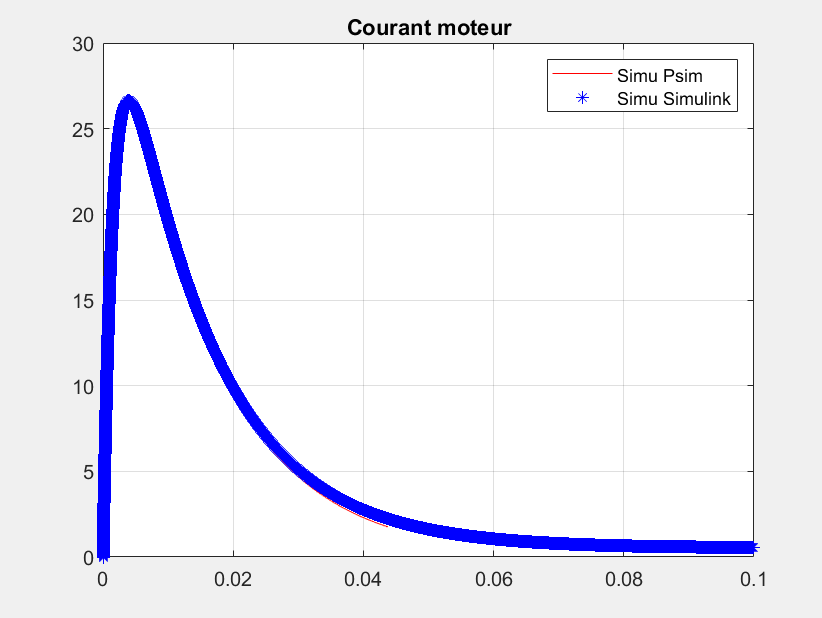
[picture p109: figure]
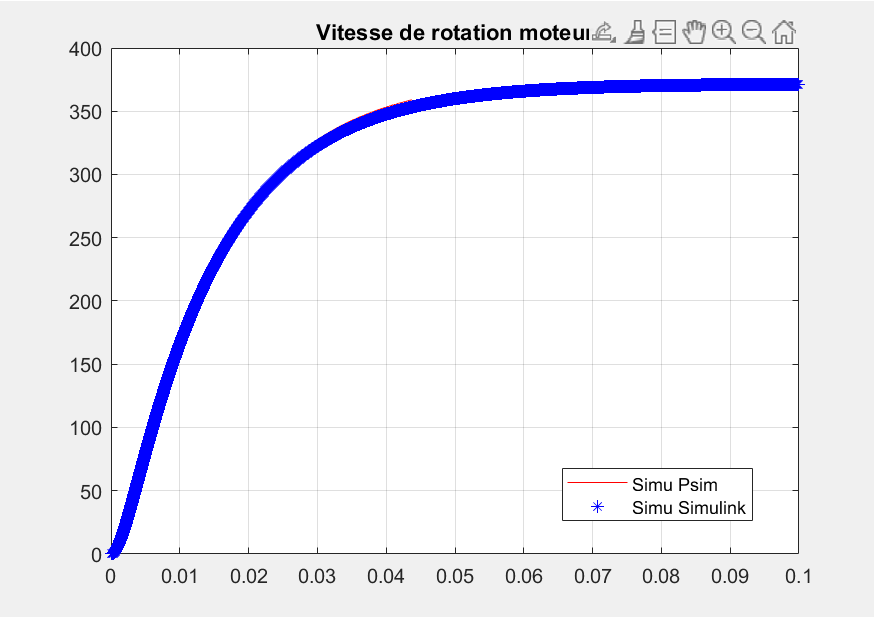
[picture p110: figure]

## SIMULATION ET MODELISATION DE LA MCC AVEC FROTTEMENTS ET CHARGE

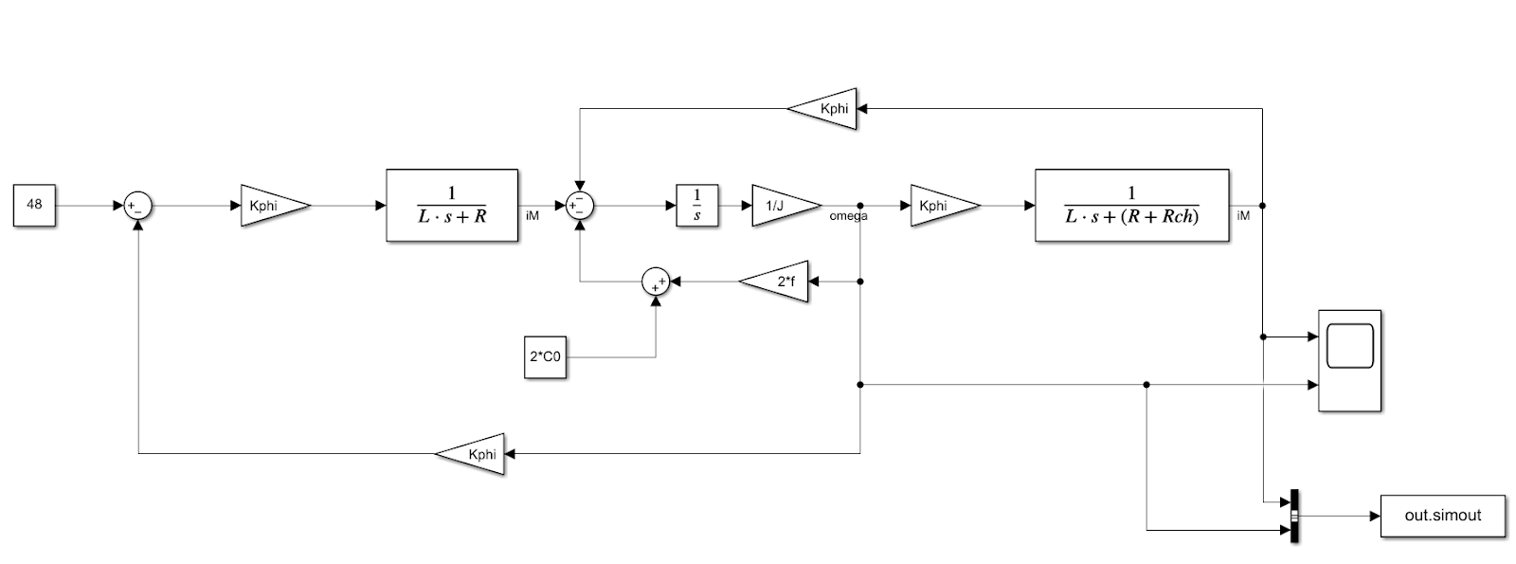
[picture p111: figure]
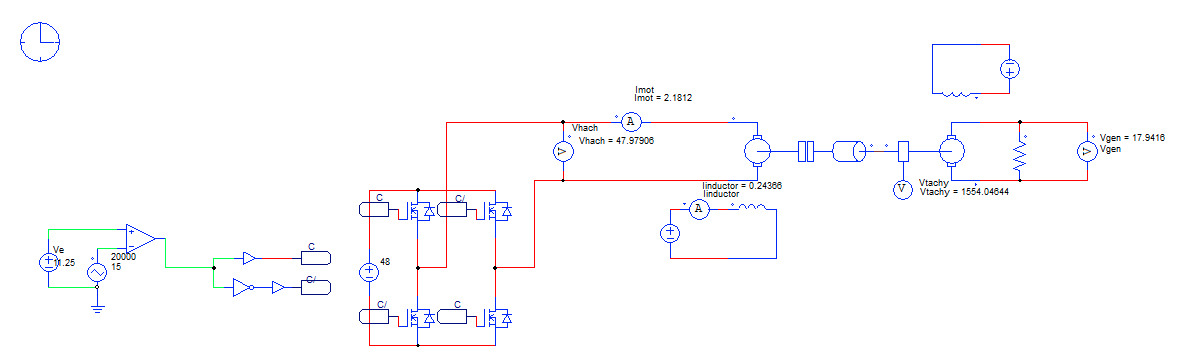
[picture p112: figure]

## Slide 11

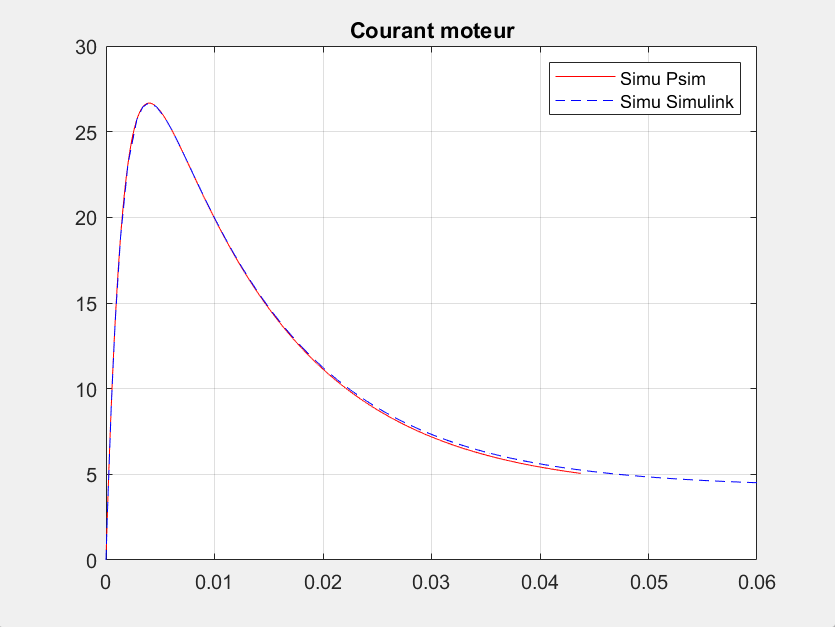
[picture p113: figure]
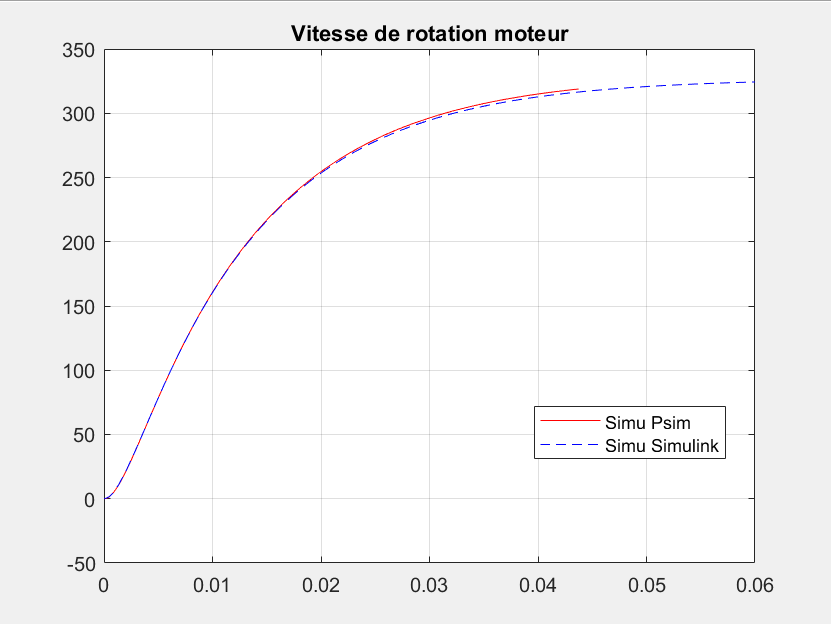
[picture p114: figure]

## MODELISATION DU HACHEUR

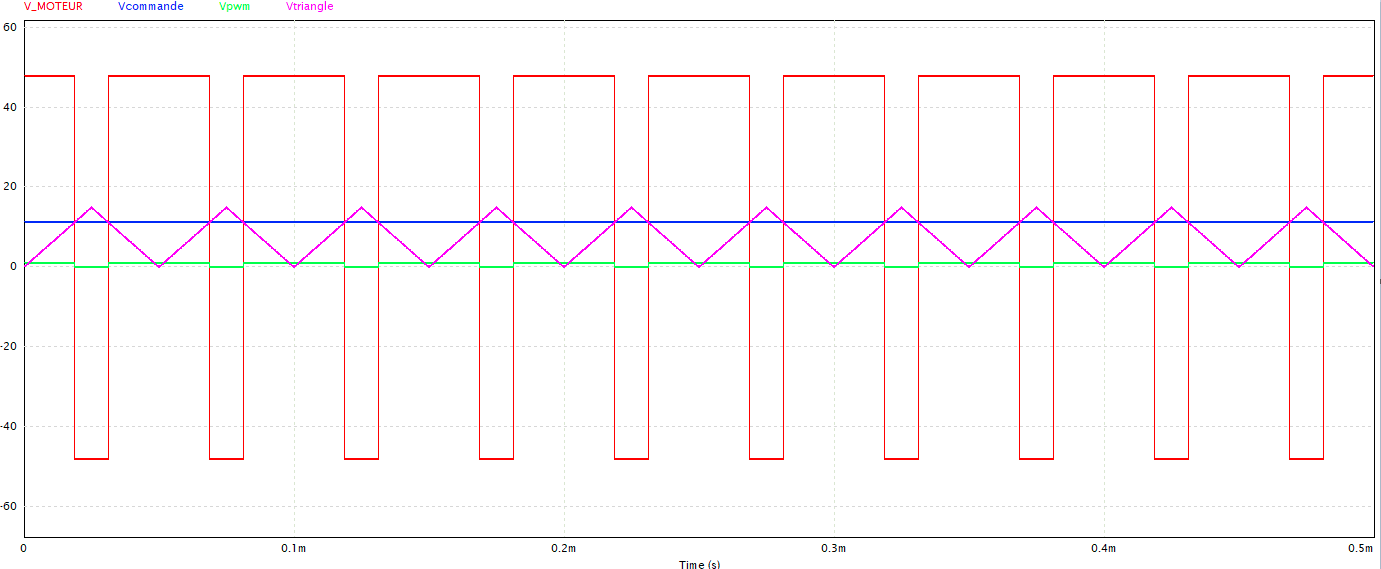
[picture p115: figure]

Courbe représentant les différentes tensions étudiées lors de la simulation PSIM du hacheur

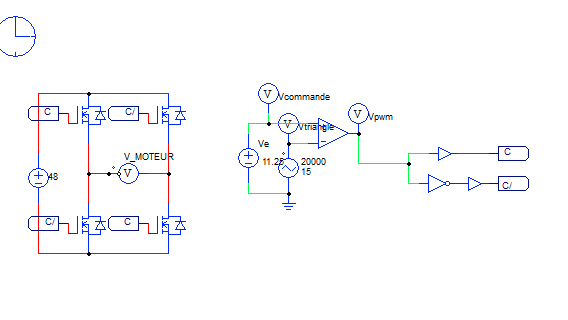
[picture p116: figure]
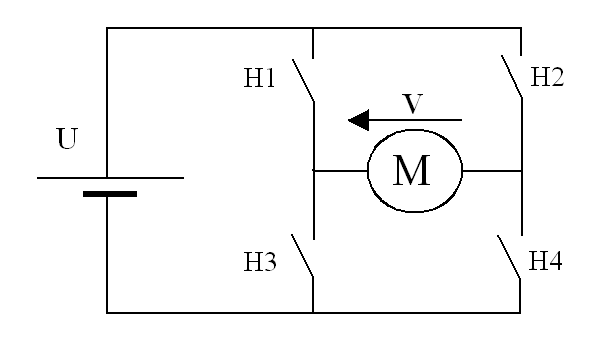
[picture p117: figure]

Schéma théorique du hacheur

## ASSERVISSEMENT EN COURANT

## Simulation sous Matlab

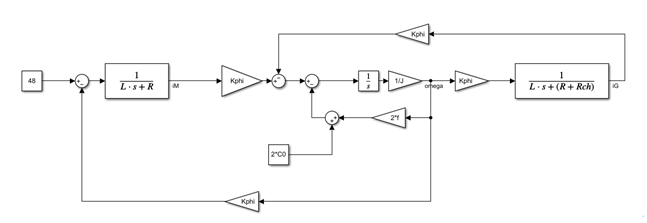
[picture p118: figure]

## Slide 15

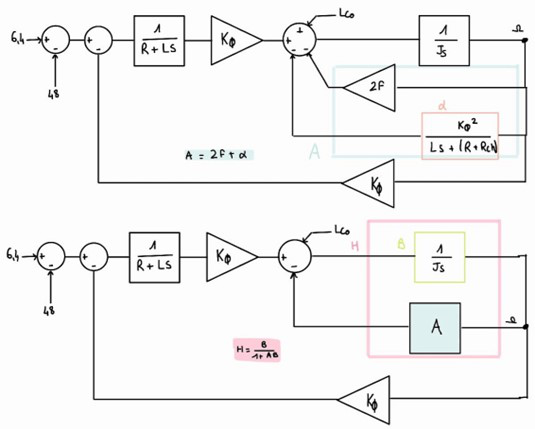
[picture p119: figure]
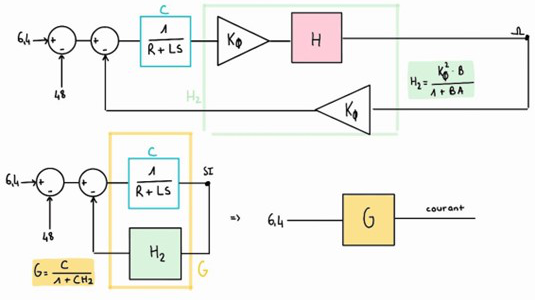
[picture p120: figure]

G=(a_4 ∙s^4 +a_3 ∙s^3 +a_2 ∙s^2 +a_1 ∙s+a_0)/(b_5 ∙s^5 +b_4 ∙s^4 +b_3 ∙s^3 +b_2 ∙s^2 +b_1 ∙s+b_0)

## Correcteurs PI pour l’asservissement en courant

- Valeur des correcteurs de l’asservissement de courant:
  - K_p =K_(psim) =8,17≈8,2
  - K_i =14106 ↔τ=5,8 e −5 s
- Valeurs avec les composants réels:
  - K_p =K_(psim) =−(R2)/(R1) →R1=10kΩ et R2=82 kΩ
  - τ=5,8 e −5 s→R=10kΩ et C=58 nF

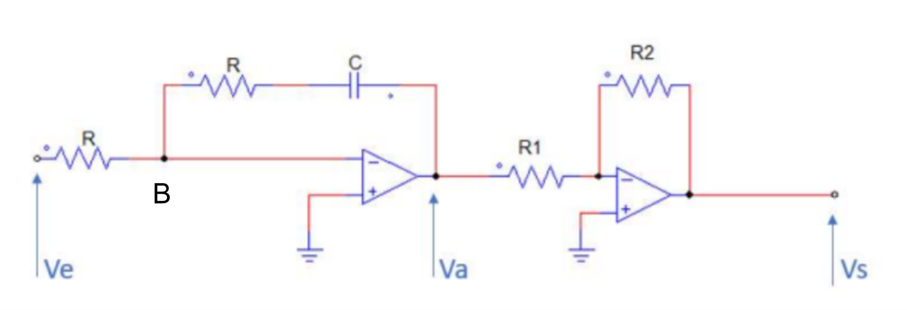
[picture p121: figure]

Correcteur PI avec des AOP

## Comparaison entre PSIM et Matlab

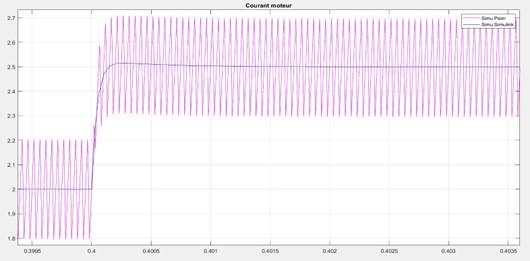
[picture p122: figure]

## Correcteurs PI pour l’asservissement en vitesse

- Valeur des correcteurs de l’asservissement de vitesse:
  - K_p =K_(psim) =2,8≈77,7
  - K_i =14106 ↔τ=0,036 s
- Valeurs avec les composants réels:
  - K_p =K_(psim) =−(R2)/(R1) →R1=8,2kΩ et R2=22 kΩ
  - τ=5,8 e −5 s→R=20kΩ et C=1,8 uF

Correcteur PI avec des AOP

## Comparaison entre PSIM et Matlab

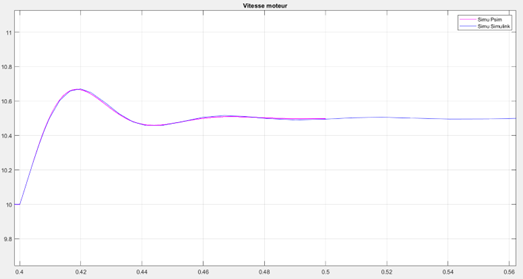
[picture p123: figure]

## Conception des circuits sur Proteus et des PCB

## Soudure et cartes imprimées
