EvanTrenchant/ProjetGES7/Modelisation/2025_09_12/Comparaison courant induit Psim VS Simulink moteur à vide.png

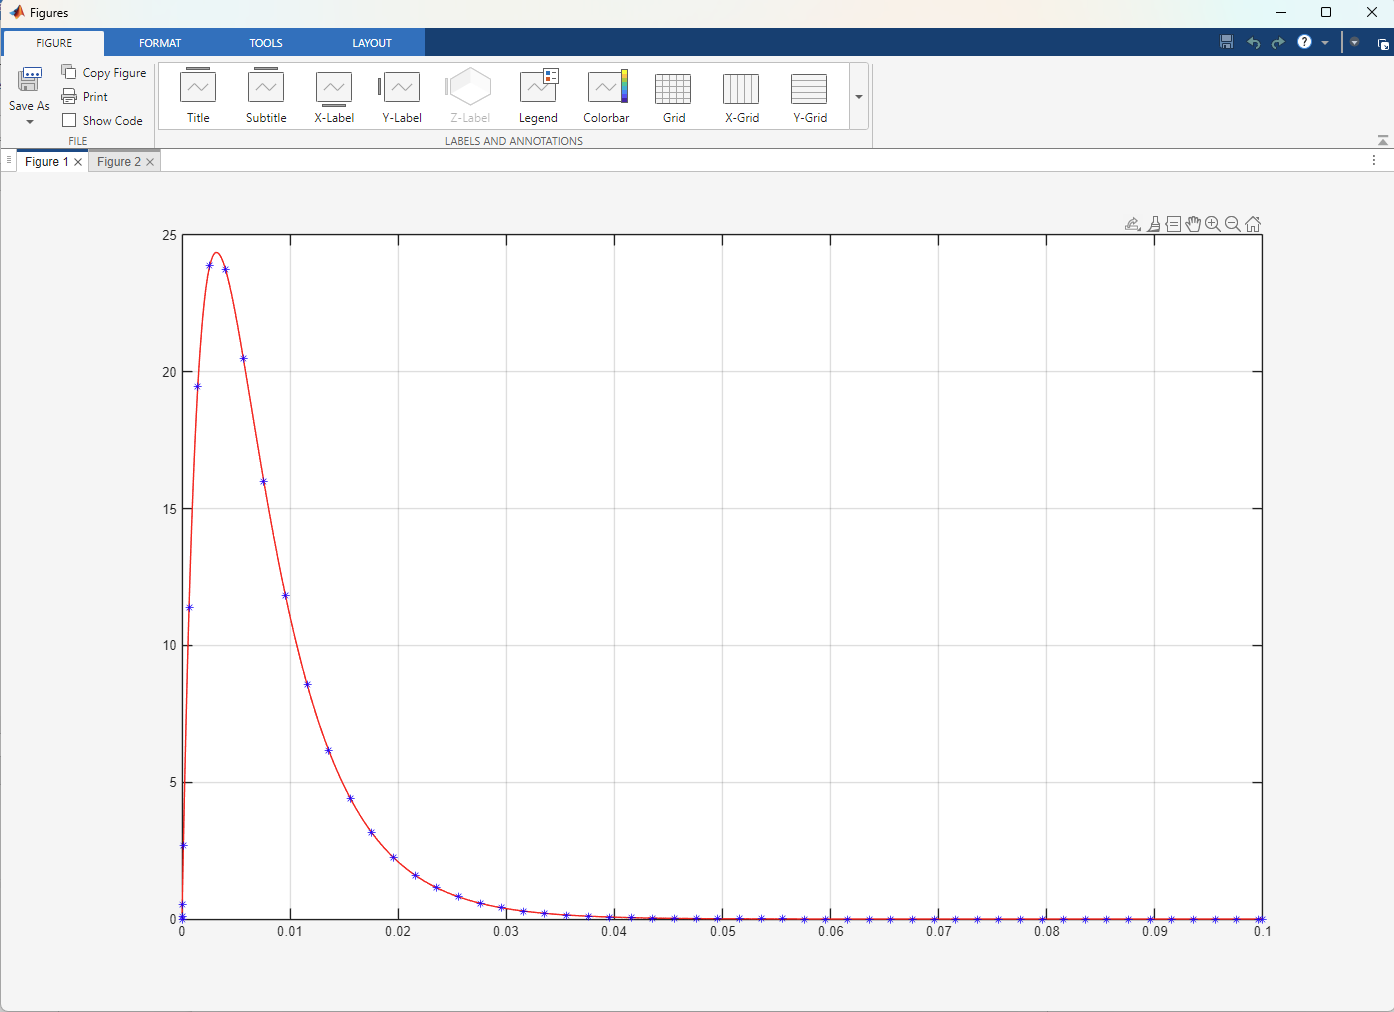
Modelisation/2025_09_12/Comparaison courant induit Psim VS Simulink moteur à vide.png
