EvanTrenchant/ProjetGES7/Modelisation/2025_09_12/Schéma moteur à vide Simulink.png

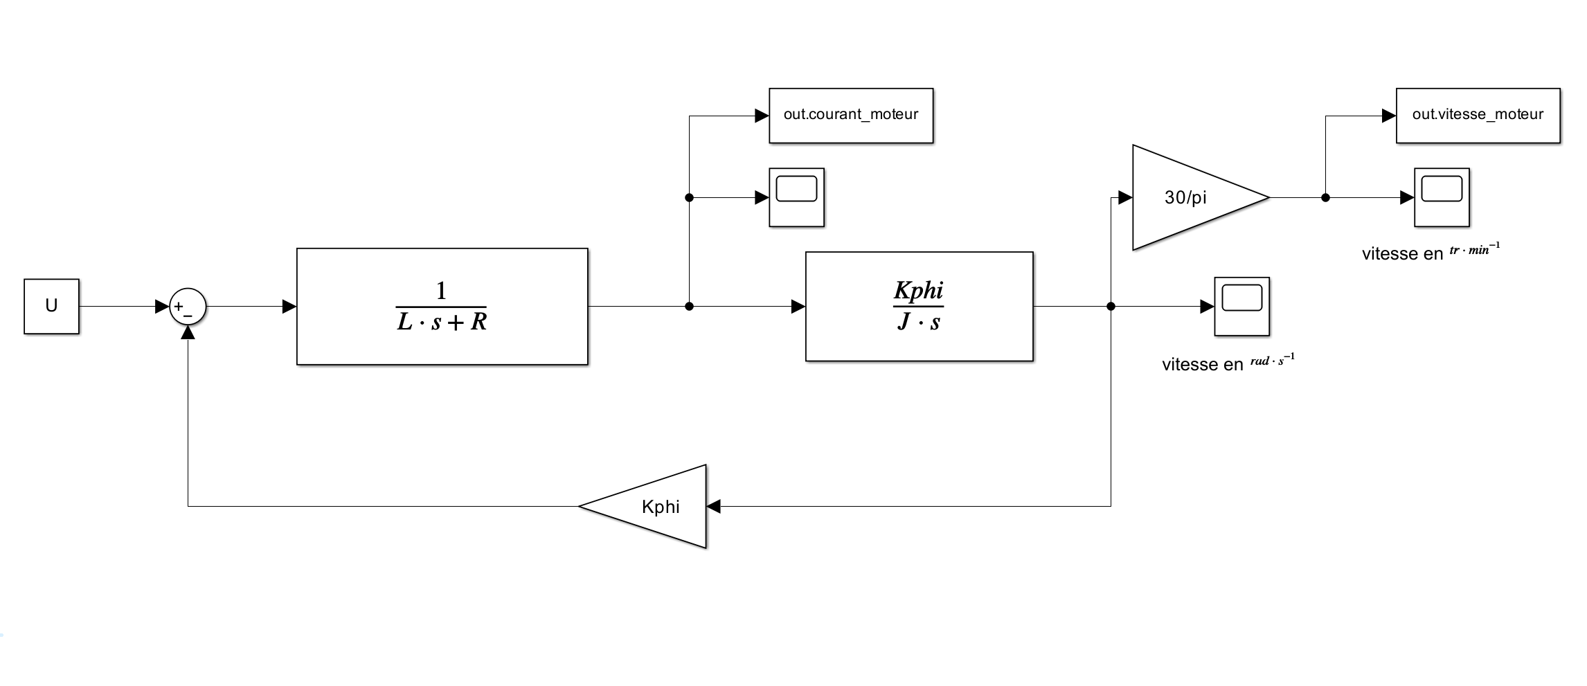
Modelisation/2025_09_12/Schéma moteur à vide Simulink.png
