EvanTrenchant/ProjetGES7/Modelisation/2025_09_22/Comparaison courant génératrice moteur avec charge.png

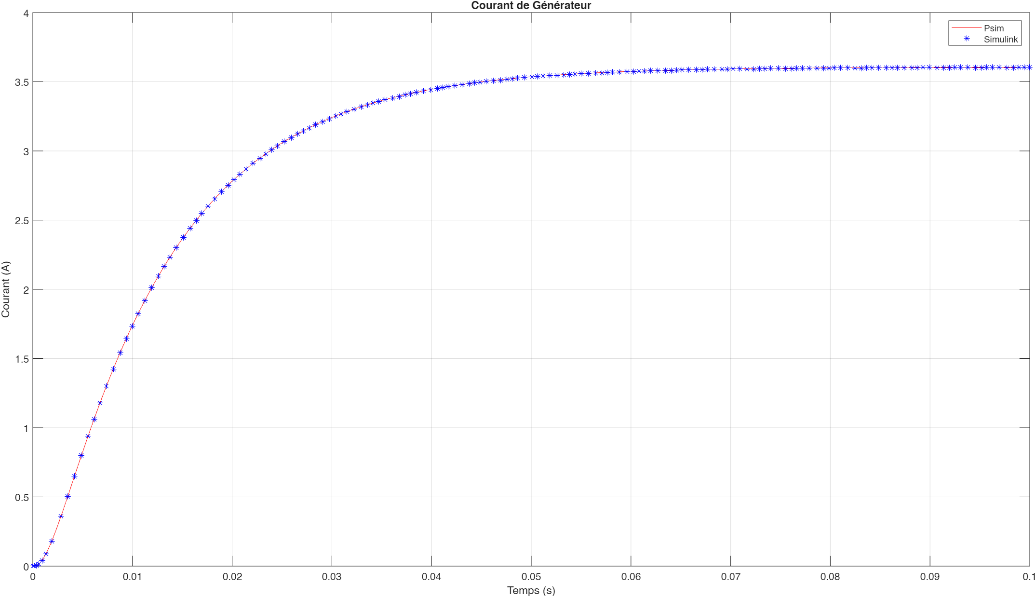
Modelisation/2025_09_22/Comparaison courant génératrice moteur avec charge.png
