EvanTrenchant/ProjetGES7/Modelisation/2025_09_22/Comparaison courant moteur moteur avec charge.png

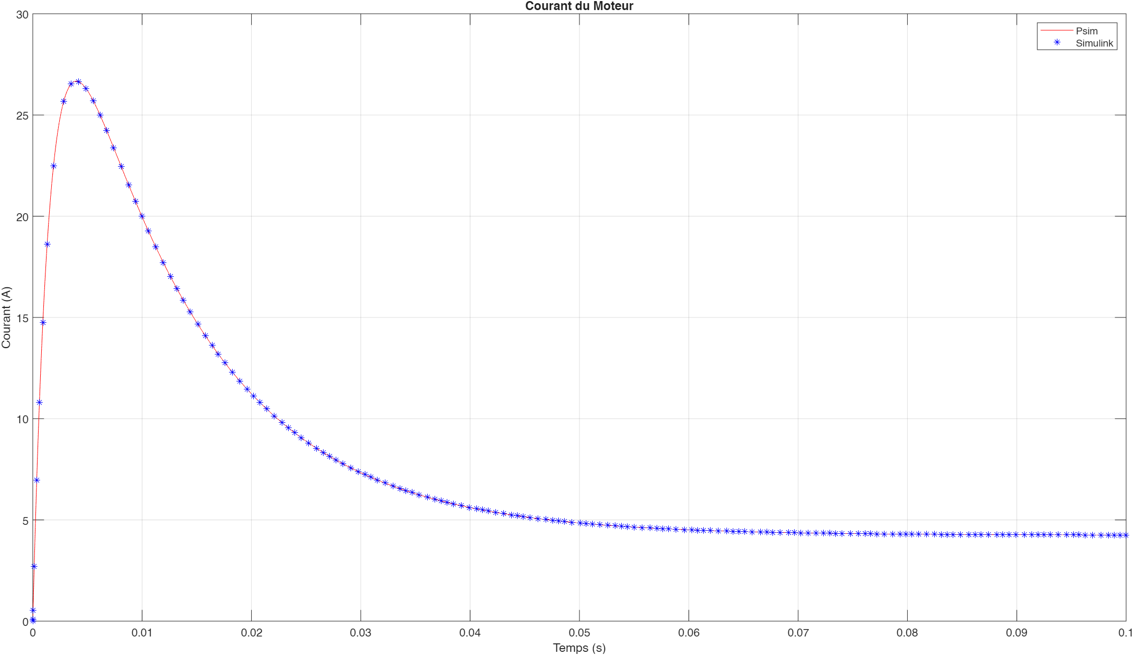
Modelisation/2025_09_22/Comparaison courant moteur moteur avec charge.png
