EvanTrenchant/ProjetGES7/Modelisation/2025_09_22/Comparaison vitesse moteur avec charge.png

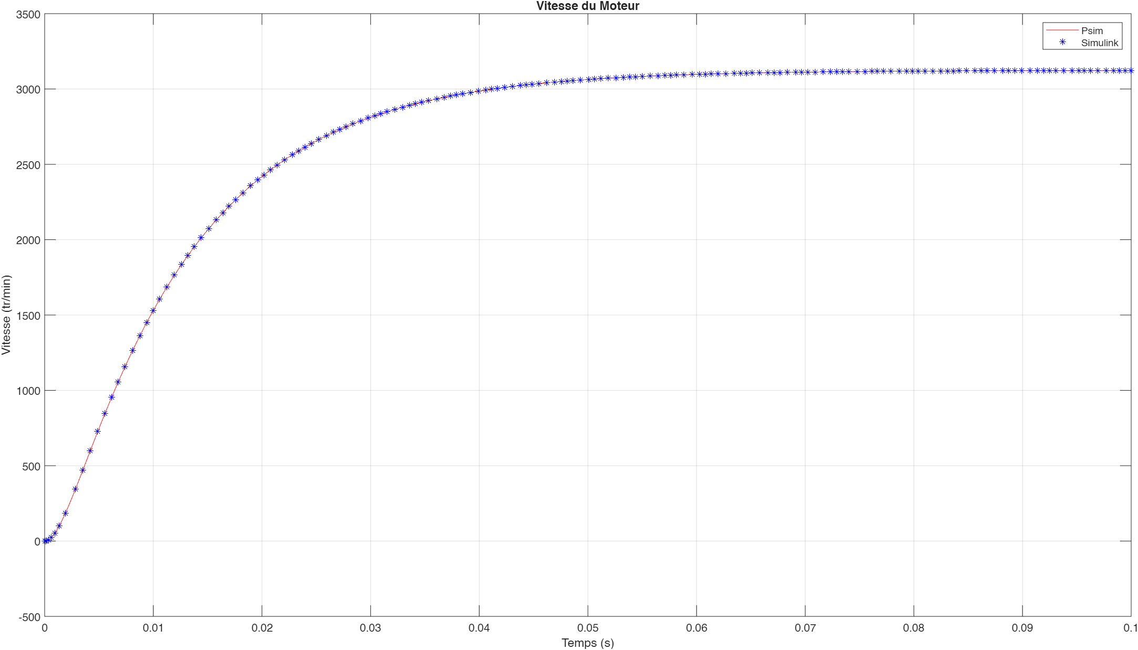
Modelisation/2025_09_22/Comparaison vitesse moteur avec charge.png
