EvanTrenchant/ProjetGES7/Modelisation/2025_09_22/Schéma moteur avec charge Simulink.png

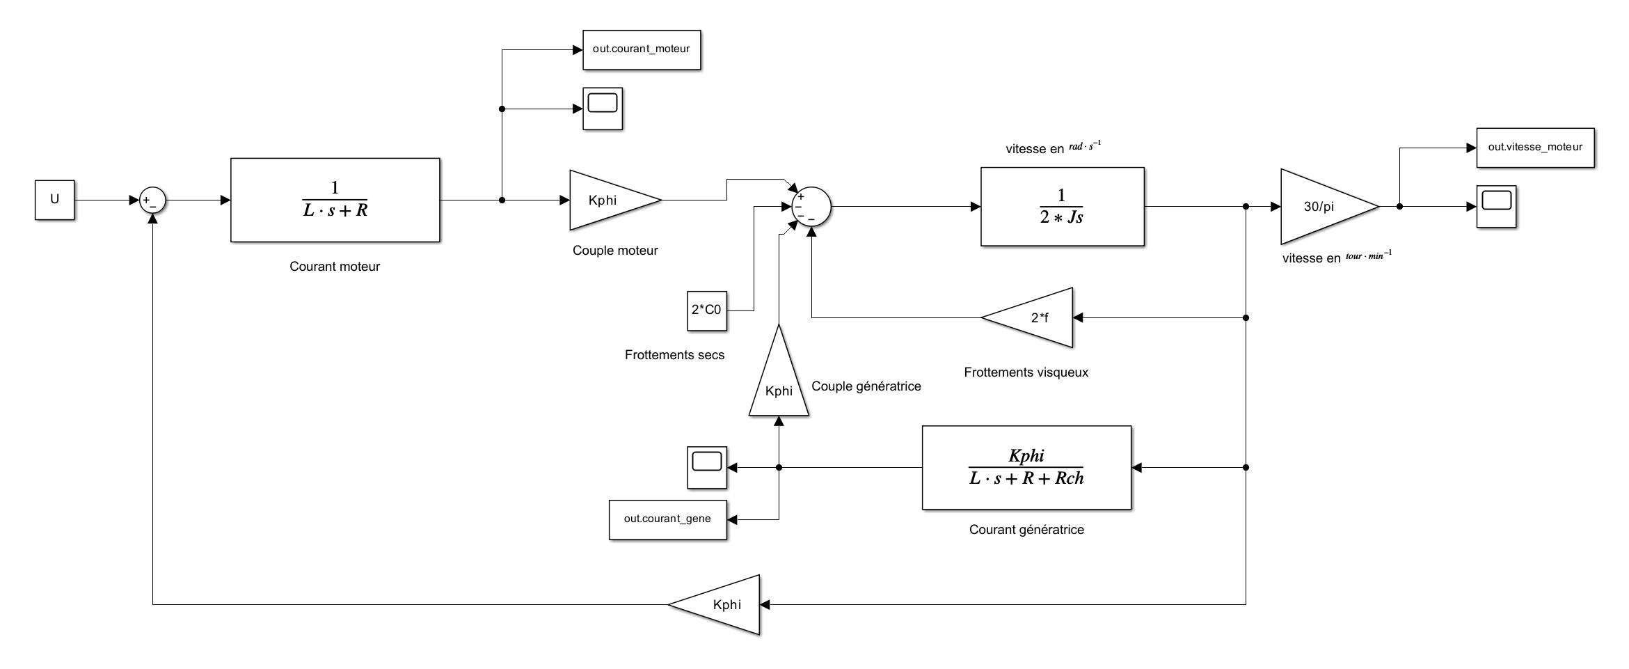
Modelisation/2025_09_22/Schéma moteur avec charge Simulink.png
