EvanTrenchant/ProjetGES7/Modelisation/2025_10_01/Schéma moteur + charge + hacheur Psim.png

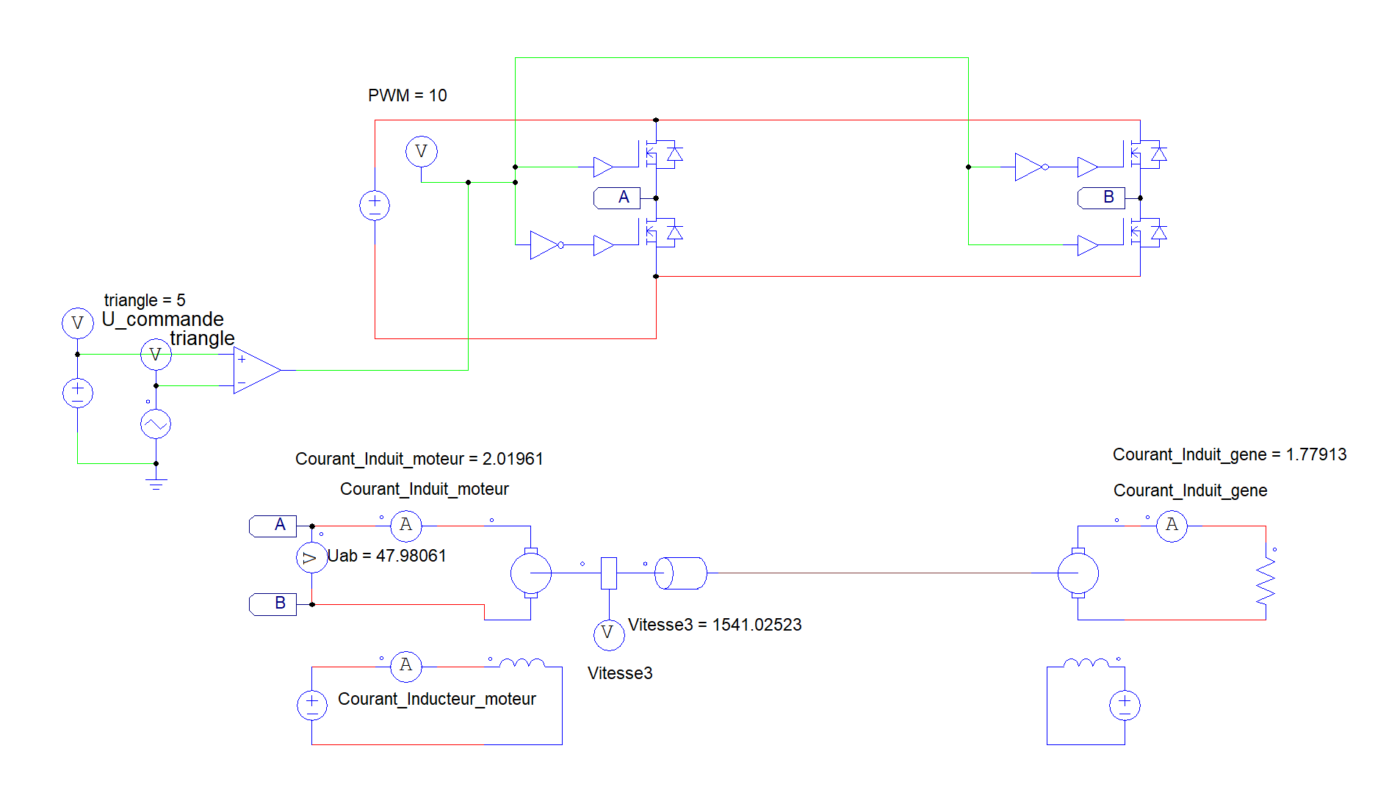
Modelisation/2025_10_01/Schéma moteur + charge + hacheur Psim.png
