EvanTrenchant/ProjetGES7/Modelisation/2025_10_13/Schéma asservissement courant Simulink.png

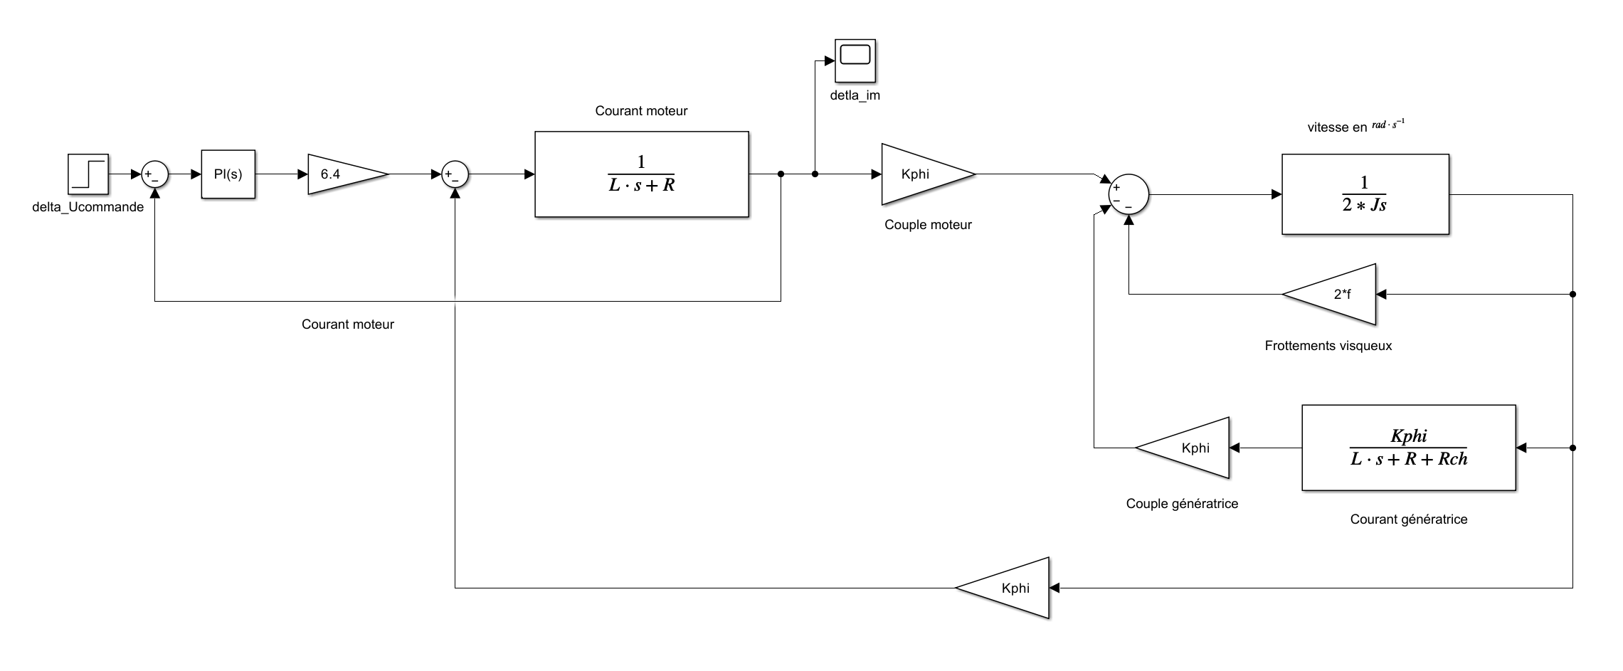
Modelisation/2025_10_13/Schéma asservissement courant Simulink.png
