EvanTrenchant/ProjetGES7/Modelisation/2025_11_02/Comparaison asservissement vitesse.png

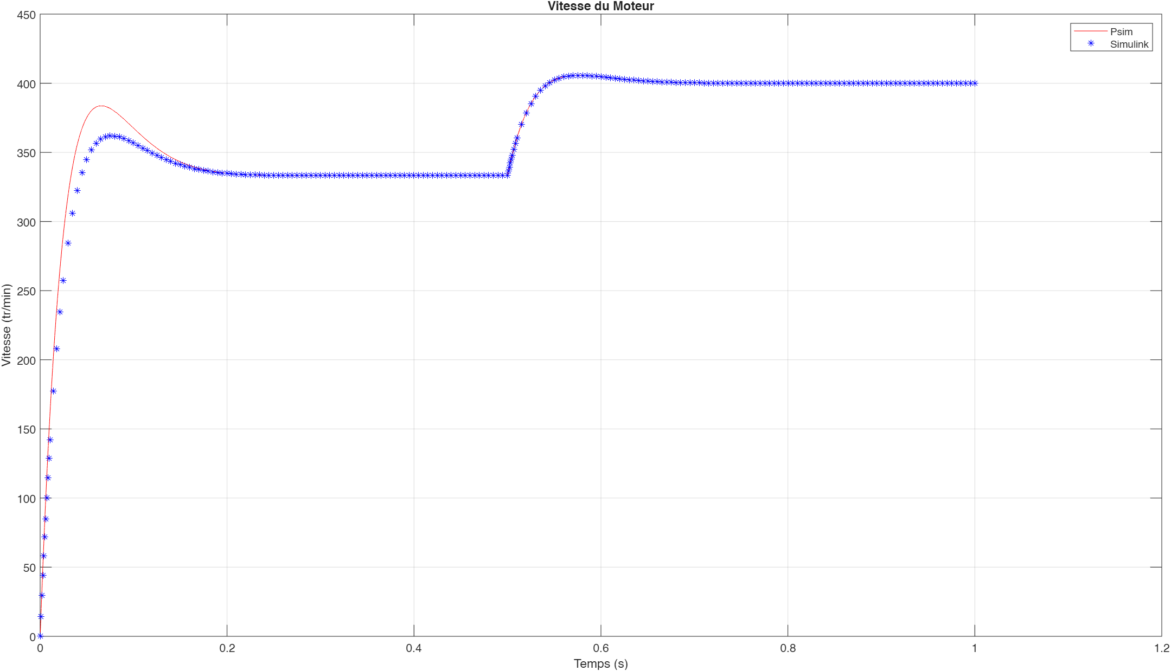
Modelisation/2025_11_02/Comparaison asservissement vitesse.png
