EvanTrenchant/ProjetGES7/note_Tableau/IMG_20250922_093421.jpg

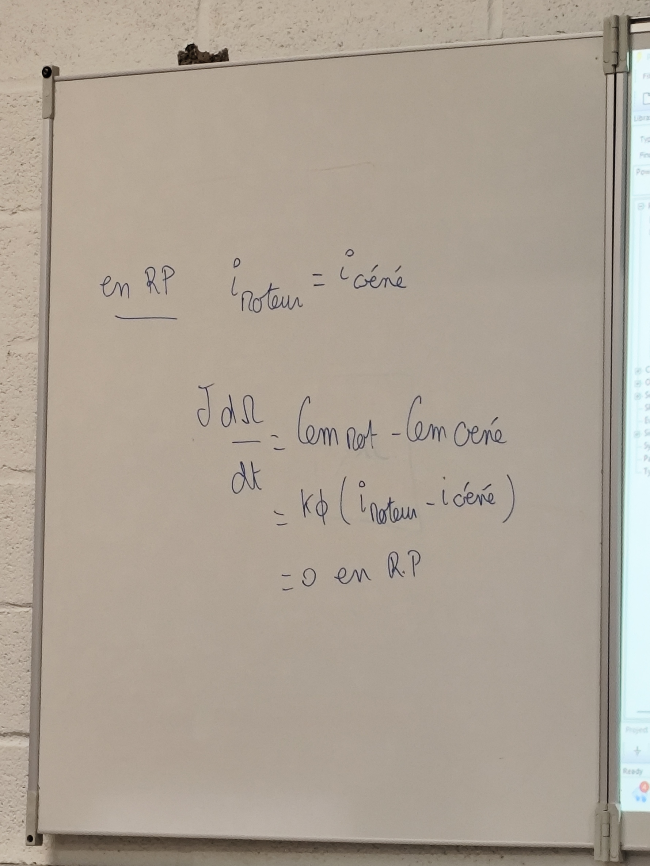
note_Tableau/IMG_20250922_093421.jpg
