EvanTrenchant/ProjetGES7/note_Tableau/IMG_20250922_094147.jpg

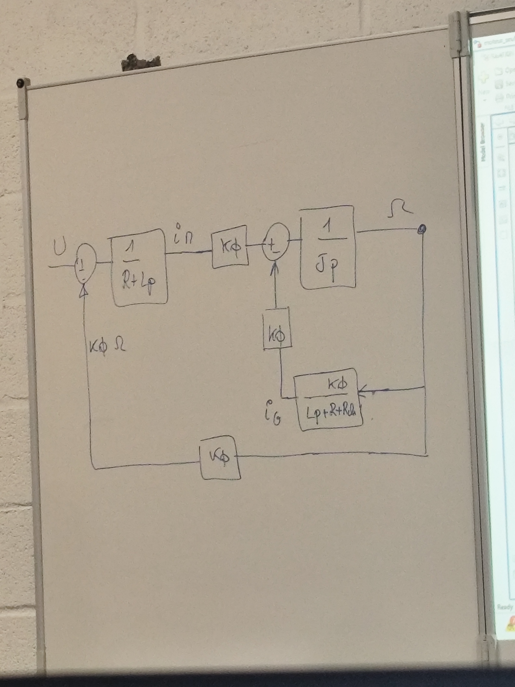
note_Tableau/IMG_20250922_094147.jpg
