EvanTrenchant/ProjetGES7/note_Tableau/IMG_20251001_145751.jpg

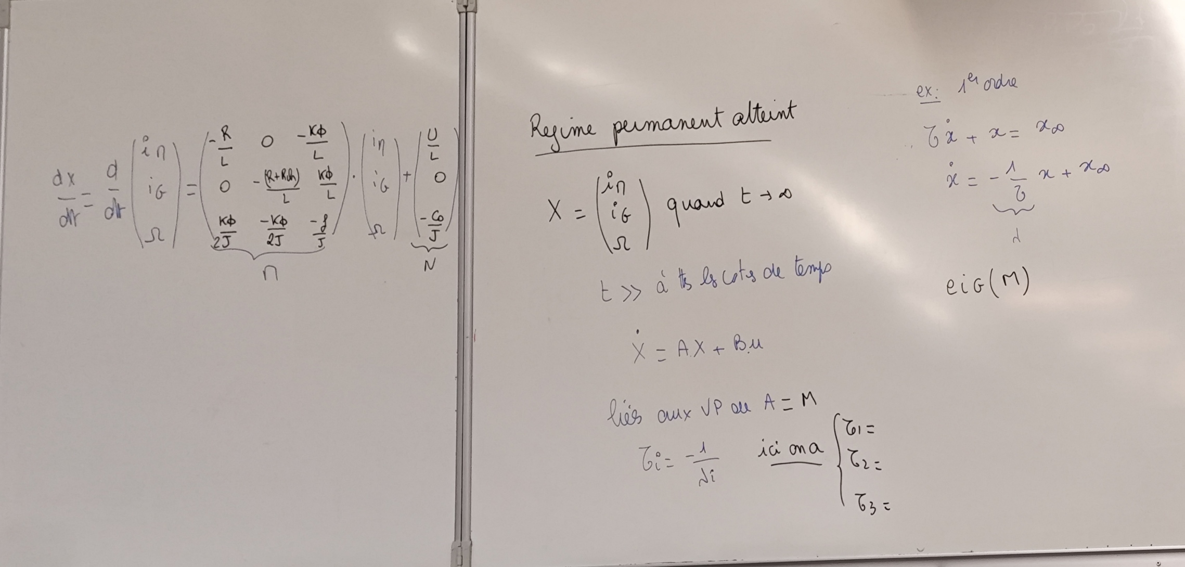
note_Tableau/IMG_20251001_145751.jpg
