EvanTrenchant/ProjetGES7/Rapport/images/BF_Vitesse/Zoom_Graphe_Comparaison_BF_Vitesse.png

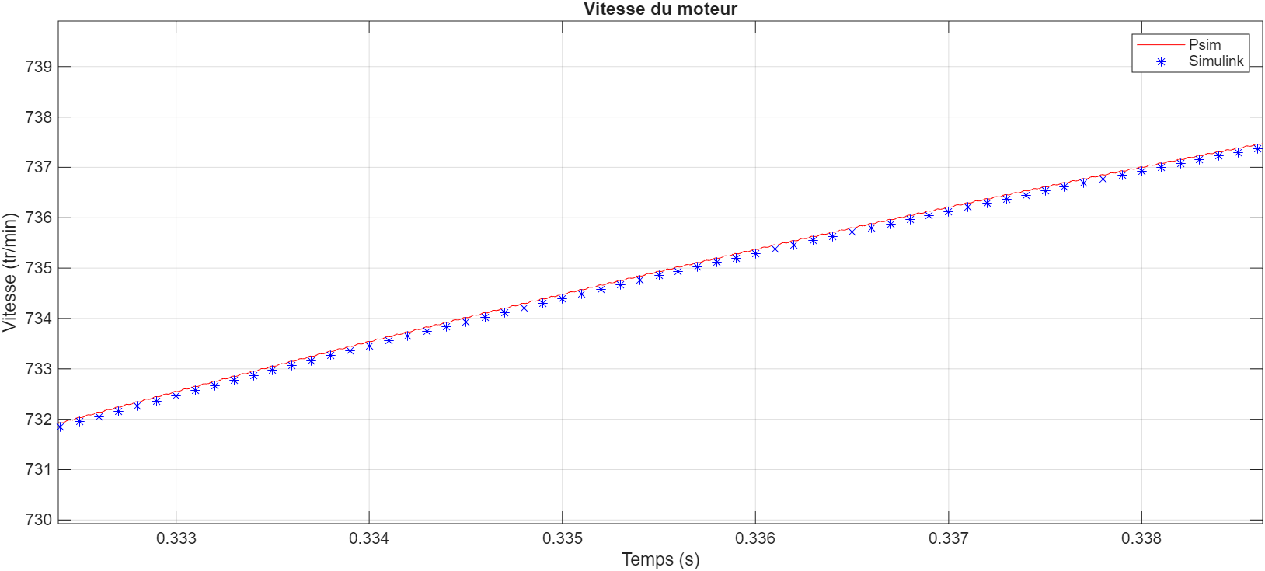
Rapport/images/BF_Vitesse/Zoom_Graphe_Comparaison_BF_Vitesse.png
