EvanTrenchant/ProjetGES7/Modélisation_Finale_VALIDE_13_01_2026/08_Test_&_Comparaison_Maquette/Codeur Incremental/Scope_Codeur_Charge.csv

x-axis | 1 | 2 | 3
second | Volt | Volt | Volt
-1.8050000E+00
-1.8047000E+00 | +1.9974875E+00 | +3.8455611E+00 | +984.4222E-03
-1.8044000E+00 | +1.9974875E+00 | +3.9045226E+00 | +863.8191E-03
-1.8041000E+00 | +1.9974875E+00 | +3.9102177E+00 | +931.6583E-03
-1.8038000E+00 | +1.9974875E+00 | +3.9182579E+00 | +906.6332E-03
-1.8035000E+00 | +1.9974875E+00 | +3.8927973E+00 | +943.7186E-03
-1.8032000E+00 | +1.9974875E+00 | +3.8740368E+00 | +822.5126E-03
-1.8029000E+00 | +1.9974875E+00 | +3.8924623E+00 | +940.7036E-03
-1.8026000E+00 | +1.9849246E+00 | +3.9095477E+00 | +1.0064322E+00
-1.8023000E+00 | +1.9849246E+00 | +3.9132328E+00 | +895.4774E-03
-1.8020000E+00 | +1.9849246E+00 | +3.9162479E+00 | +901.5076E-03
-1.8017000E+00 | +1.9849246E+00 | +3.8954773E+00 | +887.6382E-03
-1.8014000E+00 | +1.9849246E+00 | +3.8894472E+00 | +1.0136684E+00
-1.8011000E+00 | +1.9849246E+00 | +3.8901172E+00 | +835.1759E-03
-1.8008000E+00 | +1.9849246E+00 | +3.8981574E+00 | +913.5679E-03
-1.8005000E+00 | +1.9849246E+00 | +3.9028475E+00 | +857.7890E-03
-1.8002000E+00 | +1.9849246E+00 | +3.9195979E+00 | +1.0706533E+00
-1.7999000E+00 | +1.9849246E+00 | +3.9035175E+00 | +858.9950E-03
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
