EvanTrenchant/ProjetGES7/Modélisation_Finale_VALIDE_13_01_2026/08_Test_&_Comparaison_Maquette/Tachy/Scope_Tachy_Charge.csv

x-axis | 1 | 2 | 3
second | Volt | Volt | Volt
-1.820000E+00 | +1.989950E+00 | +3.938442E+00 | +867.839E-03
-1.817500E+00 | +1.989950E+00 | +3.961055E+00 | +862.312E-03
-1.815000E+00 | +1.989950E+00 | +3.945980E+00 | +865.075E-03
-1.812500E+00 | +1.989950E+00 | +3.942211E+00 | +870.603E-03
-1.810000E+00 | +1.989950E+00 | +3.953518E+00 | +895.477E-03
-1.807500E+00 | +1.991834E+00 | +3.957287E+00 | +939.699E-03
-1.805000E+00 | +1.989950E+00 | +3.945980E+00 | +914.824E-03
-1.802500E+00 | +1.989950E+00 | +3.934673E+00 | +928.643E-03
-1.800000E+00 | +1.989950E+00 | +3.942211E+00 | +903.769E-03
-1.797500E+00 | +1.989950E+00 | +3.945980E+00 | +845.729E-03
-1.795000E+00 | +1.989950E+00 | +3.919598E+00 | +873.367E-03
-1.792500E+00 | +1.989950E+00 | +3.953518E+00 | +887.186E-03
-1.790000E+00 | +1.989950E+00 | +3.919598E+00 | +914.824E-03
-1.787500E+00 | +1.989950E+00 | +3.953518E+00 | +889.950E-03
-1.785000E+00 | +1.989950E+00 | +3.976131E+00 | +903.769E-03
-1.782500E+00 | +1.989950E+00 | +3.945980E+00 | +925.879E-03
-1.780000E+00 | +1.989950E+00 | +3.968593E+00 | +906.533E-03
-1.777500E+00 | +1.989950E+00 | +3.938442E+00 | +831.910E-03
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
