EvanTrenchant/ProjetGES7/Modelisation_old/2025_10_27/test psim archives vitesse.pdf

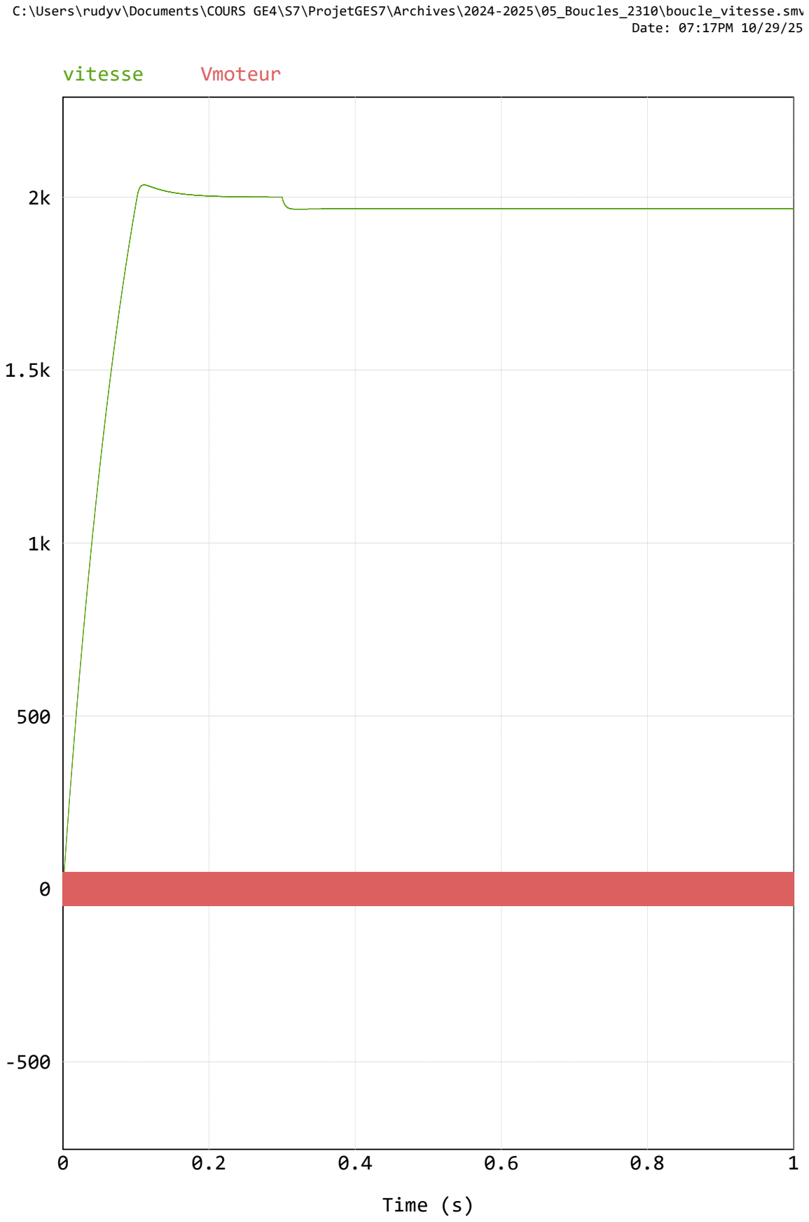
[picture p189: figure]
C:\Users\rudyv\Documents\COURS GE4\S7\ProjetGES7\Archives\2024-2025\05_Boucles_2310\boucle_vitesse.smv Date: 07:17PM 10/29/25; Time (s); vitesse; Vmoteur
