EvanTrenchant/ProjetGES7/Modélisation_Finale_VALIDE_13_01_2026/08_Test_&_Comparaison_Maquette/Tachy/Courant_moteur.png

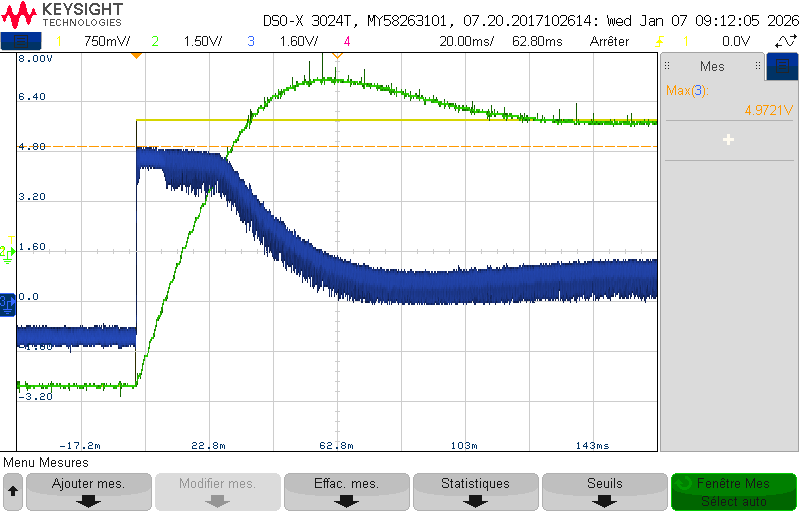
Modélisation_Finale_VALIDE_13_01_2026/08_Test_&_Comparaison_Maquette/Tachy/Courant_moteur.png
