EvanTrenchant/ProjetGES7/Rapport/images/Image PCB/Carte_PCB.pdf

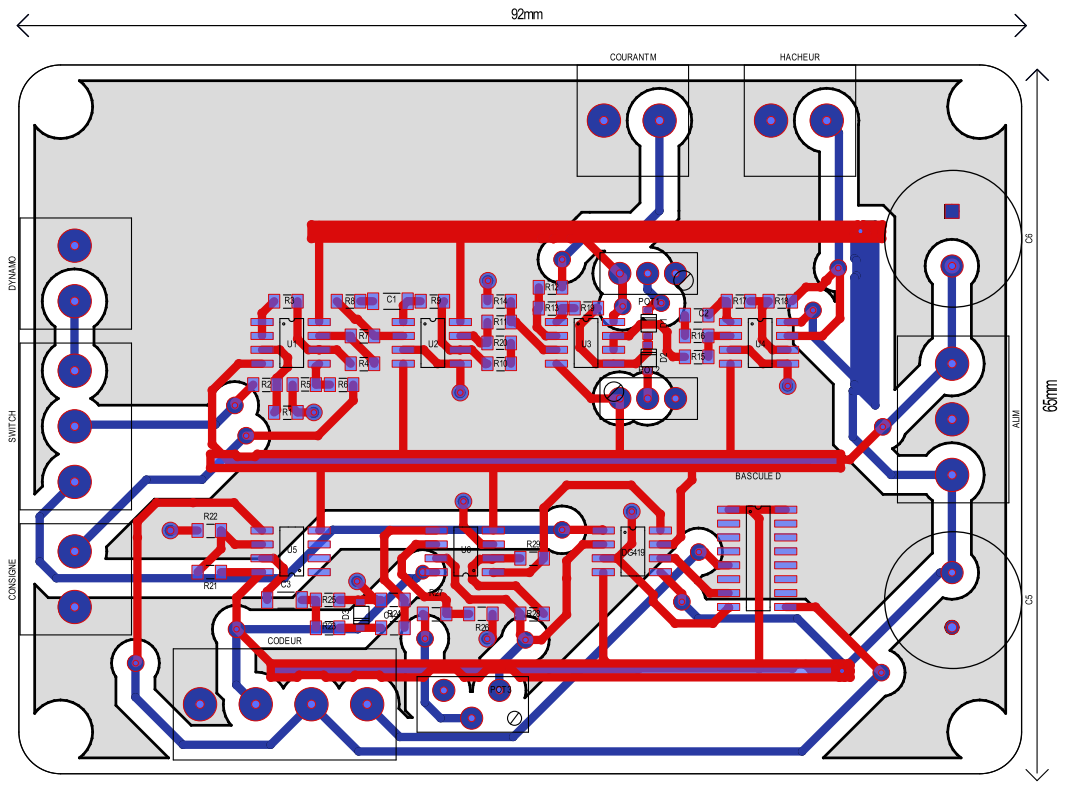
[picture p191: page 1]
