EvanTrenchant/ProjetGES7/Rapport/images/Image PCB/VGA_PCB.pdf

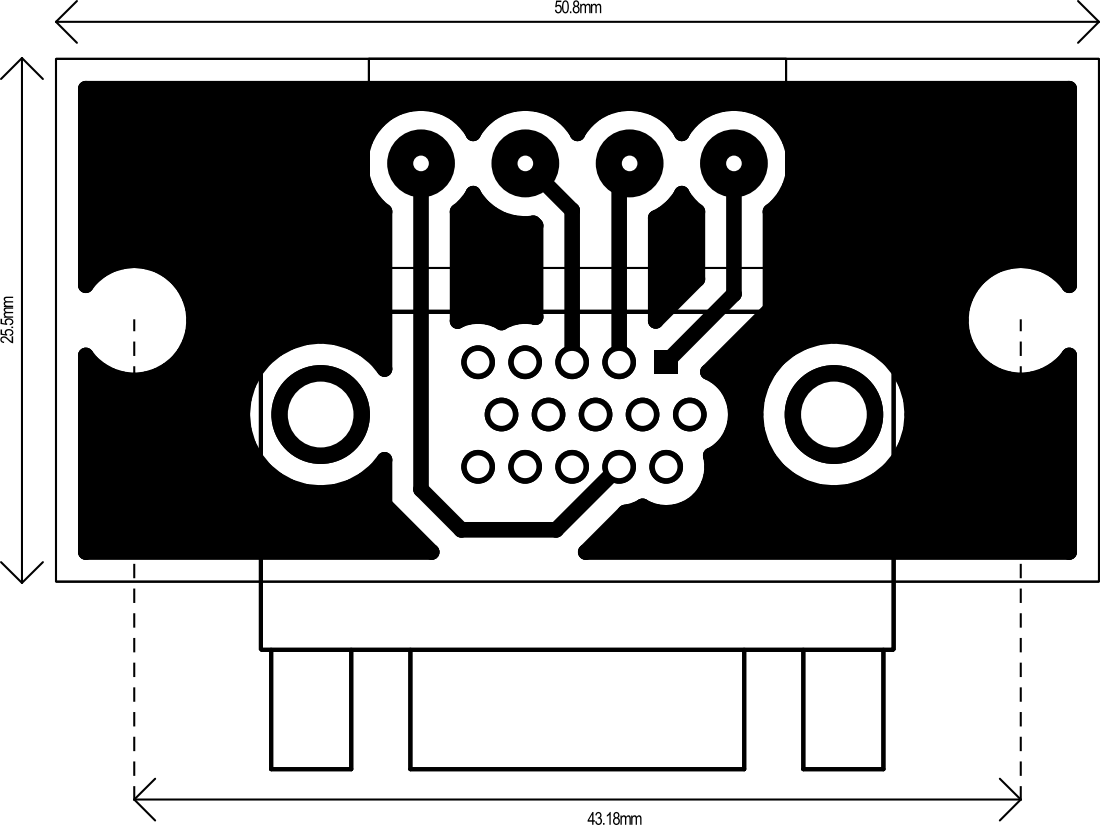
[picture p192: page 1]
