EvanTrenchant/ProjetGES7/(list of files, drawings)

Other design files:
Archives/2022-2023/package9.pdsprj
Archives/2022-2023/Projet_GE1_Barety_Guth_Martinez.pdsprj
Archives/2024-2025/projet_s7_sgass_mguerchon.pdsprj
Archives/Carte 1.pdsprj
Archives/Carte 2.pdsprj
Modélisation_Finale_VALIDE_13_01_2026/07_Conception_PCB/Carte VGA.pdsprj
Modélisation_Finale_VALIDE_13_01_2026/07_Conception_PCB/PCB_Final_ProjetGES7_2025_27_11.pdsprj
Modélisation_Intermédiaire_VALIDE/07_Conception_Des_PCB/PCB_Final_ProjetGES7_2025_27_11_VALIDE.pdsprj
Modélisation_Intermédiaire_VALIDE/07_Conception_Des_PCB/Project Backups/PCB_Final_ProjetGES7_2025_27_11_VALIDE [20251210, 16-01-42].pdsprj
