EvanTrenchant/ProjetGES7/(commit log)

2025-09-22 ajout note de Damien
2025-10-22 ajouts archives
    [Projet_GE1_Barety_Guth_Martinez.pdsprj, package9.pdsprj, projet_s7_sgass_mguerchon.pdsprj]
2025-10-22 Update motor control parameters and simulation results in report
2025-10-26 Add section on speed control using incremental encoder in report
2025-11-03 Schém et Graphe Moteur Charge Frottement
2025-11-08 Modelisation choix des composants
2025-11-14 ajouts archives proteus
    [Carte 1.pdsprj, Carte 2.pdsprj]
2025-12-29 ajout svg
    [Carte_VGA_VALIDE.pdsprj, PCB_Final_ProjetGES7_2025_27_11_VALIDE [20251210, 16-01-42].pdsprj, PCB_Final_ProjetGES7_2025_27_11_VALIDE.pdsprj]
2025-12-29 Image PCB
2025-12-29 Ajout partie assemblage (rédigée par Laël)
2025-12-29 ajout partie PCB
2026-01-13 Dossier_Modelesiation finale 13/01
    [Carte VGA.pdsprj, PCB_Final_ProjetGES7_2025_27_11.pdsprj, Scope_Codeur_Charge.csv, Scope_Tachy_Charge.csv]
2026-01-15 Modification de la partie 7 - Assemblage du système
